ajayre/djetecu/005/Photos/ECU GIF/Aux Board Wiring.gif

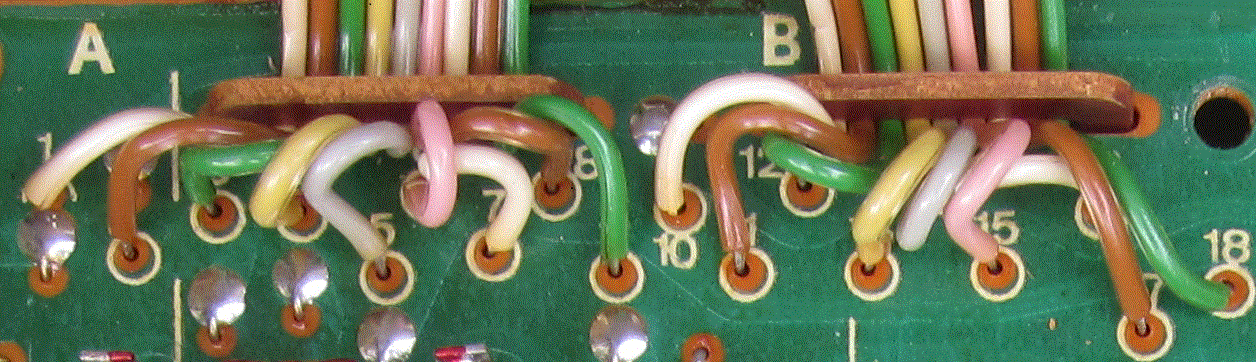
005/Photos/ECU GIF/Aux Board Wiring.gif
