ajayre/djetecu/005/Photos/ECU GIF/ECU Connector.gif

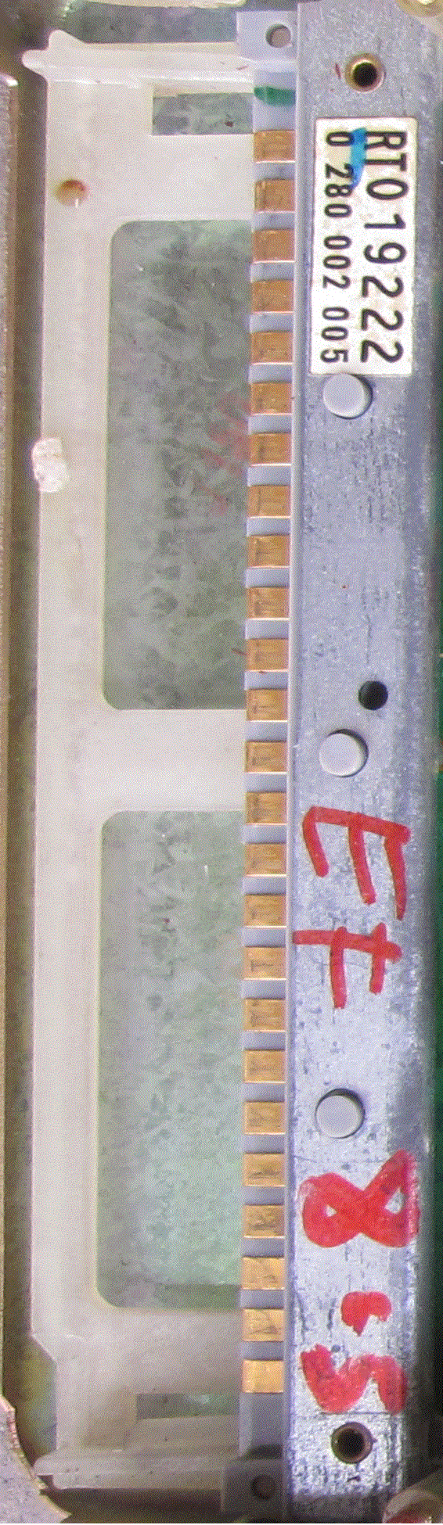
005/Photos/ECU GIF/ECU Connector.gif
