ajayre/djetecu/README.md

# Bosch D-Jetronic ECU Reverse Engineering Project

Schematics, simulation and photos. Work in progress. Supplied as-is.
