ajayre/djetecu/005/Schematics/Bosch 0 280 002 005 ECU Schematic.pdf-comment.html

# Bosch 0 280 002 005 ECU Schematic.pdf - Drive File Comments

{"anchor":"[null,[20,[0.3388324975967407,0.570936918258667,0.3535383939743042,0.5936641693115234]]]","author":{"displayName":"Pulse Width Multiplier","kind":"drive#user","picture":{"url":"//ssl.gstatic.com/docs/common/blue_silhouette96-0.png"}},"commentId":"AAAAKIMqTOY","content":"This area on the Aux Board is where the injector pulse is modified by bias inputs from the Speed Correction, Acceleration Enrichmentt, and Coolant Temperature Compensation circuits.\r\rNote the numerous (17) elevated resistors seen in the center. These are \"switched on test\" resistors where tuning can be performed by replacing resistors with different values. SOT resistors are depicted in bold throughout this schematic.\r","createdDate":"2020-08-13T01:20:13.000Z","deleted":false,"fileId":"AAHRpnXss1BSm1GQ5JTXtdxWG7rqqPFxCiCbxdgMYGcspkrfiV3KI8ri_D3V4RS67tfEnK4pajk2hcSiFbKjaerxNkvqE3YmhLg","fileTitle":"Bosch 0 280 002 005 ECU Schematic.pdf","htmlContent":"This area on the Aux Board is where the injector pulse is modified by bias inputs from the Speed Correction, Acceleration Enrichmentt, and Coolant Temperature Compensation circuits.<br><br>Note the numerous (17) elevated resistors seen in the center. These are &quot;switched on test&quot; resistors where tuning can be performed by replacing resistors with different values. SOT resistors are depicted in bold throughout this schematic.<br>","kind":"drive#comment","modifiedDate":"2020-08-13T01:20:35.000Z","replies":[],"status":"open"}

Author profile image

Pulse Width Multiplier

Aug 13, 2020, 1:20:13 AM(edited: Aug 13, 2020, 1:20:35 AM)

This area on the Aux Board is where the injector pulse is modified by bias inputs from the Speed Correction, Acceleration Enrichmentt, and Coolant Temperature Compensation circuits.

Note the numerous (17) elevated resistors seen in the center. These are "switched on test" resistors where tuning can be performed by replacing resistors with different values. SOT resistors are depicted in bold throughout this schematic.

{"anchor":"[null,[17,[0.27902859449386597,0.7633093595504761,0.29373449087142944,0.7860366106033325]]]","author":{"displayName":"Voltage Regulator","kind":"drive#user","picture":{"url":"//ssl.gstatic.com/docs/common/blue_silhouette96-0.png"}},"commentId":"AAAAKIMqTOM","content":"Many circuits in this ECU require a 10V power source provided by this step down regulator.\r","createdDate":"2020-08-13T01:18:38.000Z","deleted":false,"fileId":"AAHRpnXss1BSm1GQ5JTXtdxWG7rqqPFxCiCbxdgMYGcspkrfiV3KI8ri_D3V4RS67tfEnK4pajk2hcSiFbKjaerxNkvqE3YmhLg","fileTitle":"Bosch 0 280 002 005 ECU Schematic.pdf","htmlContent":"Many circuits in this ECU require a 10V power source provided by this step down regulator.<br>","kind":"drive#comment","modifiedDate":"2020-08-13T01:19:10.000Z","replies":[],"status":"open"}

Author profile image

Voltage Regulator

Aug 13, 2020, 1:18:38 AM(edited: Aug 13, 2020, 1:19:10 AM)

Many circuits in this ECU require a 10V power source provided by this step down regulator.

{"anchor":"[null,[16,[0.8002287149429321,0.18081945180892944,0.8149346113204956,0.2035467028617859]]]","author":{"displayName":"Acceleration Enrichment","kind":"drive#user","picture":{"url":"//ssl.gstatic.com/docs/common/blue_silhouette96-0.png"}},"commentId":"AAAAKIMqTOo","content":"This area of the Aux Board takes a signal from the TPS via ECU terminals 9 and 20 through Aux leads 3 and 5 as alternating HI - LO as the throttle is advanced. The Acceleration Enrichment circuit uses this step function to enrich the mixture based on driver demand from the right foot.\r\rAn idle signal from the TPS (terminal 17 via Aux 2) shuts down this circuit.\r","createdDate":"2020-08-13T01:17:27.000Z","deleted":false,"fileId":"AAHRpnXss1BSm1GQ5JTXtdxWG7rqqPFxCiCbxdgMYGcspkrfiV3KI8ri_D3V4RS67tfEnK4pajk2hcSiFbKjaerxNkvqE3YmhLg","fileTitle":"Bosch 0 280 002 005 ECU Schematic.pdf","htmlContent":"This area of the Aux Board takes a signal from the TPS via ECU terminals 9 and 20 through Aux leads 3 and 5 as alternating HI - LO as the throttle is advanced. The Acceleration Enrichment circuit uses this step function to enrich the mixture based on driver demand from the right foot.<br><br>An idle signal from the TPS (terminal 17 via Aux 2) shuts down this circuit.<br>","kind":"drive#comment","modifiedDate":"2020-08-13T01:17:54.000Z","replies":[],"status":"open"}

Author profile image

Acceleration Enrichment

Aug 13, 2020, 1:17:27 AM(edited: Aug 13, 2020, 1:17:54 AM)

This area of the Aux Board takes a signal from the TPS via ECU terminals 9 and 20 through Aux leads 3 and 5 as alternating HI - LO as the throttle is advanced. The Acceleration Enrichment circuit uses this step function to enrich the mixture based on driver demand from the right foot.

An idle signal from the TPS (terminal 17 via Aux 2) shuts down this circuit.

{"anchor":"[null,[6,[0.5404975414276123,0.7821174263954163,0.555203378200531,0.8048446774482727]]]","author":{"displayName":"Fuel Pump Control","kind":"drive#user","picture":{"url":"//ssl.gstatic.com/docs/common/blue_silhouette96-0.png"}},"commentId":"AAAAKIMqTOQ","content":"This circuit delivers a switched ground to ECU terminal 19 which is wired to terminal 85 of the Fuel Pump Relay under two conditions:\r\r1. ECU powered without a speed signal (100 series Aux Board) > C400 provides switched ground for 1.5 seconds to pressurize fuel loop for start.\r\r2. ECU powered with a speed signal (above 300 RPM), continuous ground delivered through T401 until engine RPM drops or ECU is powered off.\r","createdDate":"2020-08-13T01:14:26.000Z","deleted":false,"fileId":"AAHRpnXss1BSm1GQ5JTXtdxWG7rqqPFxCiCbxdgMYGcspkrfiV3KI8ri_D3V4RS67tfEnK4pajk2hcSiFbKjaerxNkvqE3YmhLg","fileTitle":"Bosch 0 280 002 005 ECU Schematic.pdf","htmlContent":"This circuit delivers a switched ground to ECU terminal 19 which is wired to terminal 85 of the Fuel Pump Relay under two conditions:<br><br>1. ECU powered without a speed signal (100 series Aux Board) &gt; C400 provides switched ground for 1.5 seconds to pressurize fuel loop for start.<br><br>2. ECU powered with a speed signal (above 300 RPM), continuous ground delivered through T401 until engine RPM drops or ECU is powered off.<br>","kind":"drive#comment","modifiedDate":"2020-08-13T01:15:11.000Z","replies":[],"status":"open"}

Author profile image

Fuel Pump Control

Aug 13, 2020, 1:14:26 AM(edited: Aug 13, 2020, 1:15:11 AM)

This circuit delivers a switched ground to ECU terminal 19 which is wired to terminal 85 of the Fuel Pump Relay under two conditions:

1. ECU powered without a speed signal (100 series Aux Board) > C400 provides switched ground for 1.5 seconds to pressurize fuel loop for start.

2. ECU powered with a speed signal (above 300 RPM), continuous ground delivered through T401 until engine RPM drops or ECU is powered off.

{"anchor":"[null,[4,[0.7425106167793274,0.17060983180999756,0.7572165131568909,0.193337082862854]]]","author":{"displayName":"Injector Drivers","kind":"drive#user","picture":{"url":"//ssl.gstatic.com/docs/common/blue_silhouette96-0.png"}},"commentId":"AAAAKIMqTOg","content":"The Injector Drivers are the heavy components along the right edge and upper edge of this picture. This is actually the lower and left sides of the ECU when it is mounted - easily identified by the 2 large heat sinks mounted on those sides. Injector pulses from the drivers are output to the ECU terminals shown:\r\r3 > I > 1 & 5\r4 > II > 4 & 8\r5 > III > 6 & 3\r6 > IV > 7 & 2\r\rNote the correlation to the M117 firing order\r\r1-5-4-8-6-3-7-2\r\rThis part of the ECU draws power from terminal 24. The rest of the ECU draws power from terminal 16.\r","createdDate":"2020-08-13T01:12:15.000Z","deleted":false,"fileId":"AAHRpnXss1BSm1GQ5JTXtdxWG7rqqPFxCiCbxdgMYGcspkrfiV3KI8ri_D3V4RS67tfEnK4pajk2hcSiFbKjaerxNkvqE3YmhLg","fileTitle":"Bosch 0 280 002 005 ECU Schematic.pdf","htmlContent":"The Injector Drivers are the heavy components along the right edge and upper edge of this picture. This is actually the lower and left sides of the ECU when it is mounted - easily identified by the 2 large heat sinks mounted on those sides. Injector pulses from the drivers are output to the ECU terminals shown:<br><br>3 &gt; I &gt; 1 &amp; 5<br>4 &gt; II &gt; 4 &amp; 8<br>5 &gt; III &gt; 6 &amp; 3<br>6 &gt; IV &gt; 7 &amp; 2<br><br>Note the correlation to the M117 firing order<br><br>1-5-4-8-6-3-7-2<br><br>This part of the ECU draws power from terminal 24. The rest of the ECU draws power from terminal 16.<br>","kind":"drive#comment","modifiedDate":"2020-08-13T01:13:28.000Z","replies":[],"status":"open"}

Author profile image

Injector Drivers

Aug 13, 2020, 1:12:15 AM(edited: Aug 13, 2020, 1:13:28 AM)

The Injector Drivers are the heavy components along the right edge and upper edge of this picture. This is actually the lower and left sides of the ECU when it is mounted - easily identified by the 2 large heat sinks mounted on those sides. Injector pulses from the drivers are output to the ECU terminals shown:

3 > I > 1 & 5
4 > II > 4 & 8
5 > III > 6 & 3
6 > IV > 7 & 2

Note the correlation to the M117 firing order

1-5-4-8-6-3-7-2

This part of the ECU draws power from terminal 24. The rest of the ECU draws power from terminal 16.

{"anchor":"[null,[4,[0.5571870803833008,0.14481693506240845,0.5718929767608643,0.1675441861152649]]]","author":{"displayName":"NOR Gates","kind":"drive#user","picture":{"url":"//ssl.gstatic.com/docs/common/blue_silhouette96-0.png"}},"commentId":"AAAAKIMqTOI","content":"Labeled by groups, these serve a summation process on the various waveforms created by the pulse wave multiplier (300 series on Aux Board). The \"OR'd\" together waveform is delivered to the Injector Drivers.\r","createdDate":"2020-08-13T01:11:04.000Z","deleted":false,"fileId":"AAHRpnXss1BSm1GQ5JTXtdxWG7rqqPFxCiCbxdgMYGcspkrfiV3KI8ri_D3V4RS67tfEnK4pajk2hcSiFbKjaerxNkvqE3YmhLg","fileTitle":"Bosch 0 280 002 005 ECU Schematic.pdf","htmlContent":"Labeled by groups, these serve a summation process on the various waveforms created by the pulse wave multiplier (300 series on Aux Board). The &quot;OR&#39;d&quot; together waveform is delivered to the Injector Drivers.<br>","kind":"drive#comment","modifiedDate":"2020-08-13T01:11:29.000Z","replies":[],"status":"open"}

Author profile image

NOR Gates

Aug 13, 2020, 1:11:04 AM(edited: Aug 13, 2020, 1:11:29 AM)

Labeled by groups, these serve a summation process on the various waveforms created by the pulse wave multiplier (300 series on Aux Board). The "OR'd" together waveform is delivered to the Injector Drivers.

{"anchor":"[null,[3,[0.6409828066825867,0.4349873661994934,0.6556887030601501,0.45771467685699463]]]","author":{"displayName":"Injector Group Toggle Input from PG","kind":"drive#user","picture":{"url":"//ssl.gstatic.com/docs/common/blue_silhouette96-0.png"}},"commentId":"AAAAKIMqTOc","content":"The 800 series components span upwards and left from this highlighted area. This part takes the 5V square wave signals, phased at 90 degrees, from the pulse generator to the rest of the Injector Group Toggle circuit depicted on page 13.\r","createdDate":"2020-08-13T01:07:25.000Z","deleted":false,"fileId":"AAHRpnXss1BSm1GQ5JTXtdxWG7rqqPFxCiCbxdgMYGcspkrfiV3KI8ri_D3V4RS67tfEnK4pajk2hcSiFbKjaerxNkvqE3YmhLg","fileTitle":"Bosch 0 280 002 005 ECU Schematic.pdf","htmlContent":"The 800 series components span upwards and left from this highlighted area. This part takes the 5V square wave signals, phased at 90 degrees, from the pulse generator to the rest of the Injector Group Toggle circuit depicted on page 13.<br>","kind":"drive#comment","modifiedDate":"2020-08-13T01:09:57.000Z","replies":[],"status":"open"}

Author profile image

Injector Group Toggle Input from PG

Aug 13, 2020, 1:07:25 AM(edited: Aug 13, 2020, 1:09:57 AM)

The 800 series components span upwards and left from this highlighted area. This part takes the 5V square wave signals, phased at 90 degrees, from the pulse generator to the rest of the Injector Group Toggle circuit depicted on page 13.

{"anchor":"[null,[2,[0.33187827467918396,0.5666389465332031,0.34658414125442505,0.5893661975860596]]]","author":{"displayName":"Groups I & III","kind":"drive#user","picture":{"url":"//ssl.gstatic.com/docs/common/blue_silhouette96-0.png"}},"commentId":"AAAAKIMqTOk","content":"Group I & III components are in the lower left half of this polygon\r\r21 > I > 1 & 5\r22 > III > 6 & 3\r","createdDate":"2020-08-13T01:03:48.000Z","deleted":false,"fileId":"AAHRpnXss1BSm1GQ5JTXtdxWG7rqqPFxCiCbxdgMYGcspkrfiV3KI8ri_D3V4RS67tfEnK4pajk2hcSiFbKjaerxNkvqE3YmhLg","fileTitle":"Bosch 0 280 002 005 ECU Schematic.pdf","htmlContent":"Group I &amp; III components are in the lower left half of this polygon<br><br>21 &gt; I &gt; 1 &amp; 5<br>22 &gt; III &gt; 6 &amp; 3<br>","kind":"drive#comment","modifiedDate":"2020-08-13T01:05:09.000Z","replies":[],"status":"open"}

Author profile image

Groups I & III

Aug 13, 2020, 1:03:48 AM(edited: Aug 13, 2020, 1:05:09 AM)

Group I & III components are in the lower left half of this polygon

21 > I > 1 & 5
22 > III > 6 & 3

{"anchor":"[null,[2,[0.4779117703437805,0.4607802629470825,0.4926176369190216,0.48350757360458374]]]","author":{"displayName":"Groups II & IV","kind":"drive#user","picture":{"url":"//ssl.gstatic.com/docs/common/blue_silhouette96-0.png"}},"commentId":"AAAAKIMqTOU","content":"Group II & IV components are in the upper right half of this polygon.\r\r13 > II > 4 & 8\r14 > IV > 7 & 2\r","createdDate":"2020-08-13T01:02:45.000Z","deleted":false,"fileId":"AAHRpnXss1BSm1GQ5JTXtdxWG7rqqPFxCiCbxdgMYGcspkrfiV3KI8ri_D3V4RS67tfEnK4pajk2hcSiFbKjaerxNkvqE3YmhLg","fileTitle":"Bosch 0 280 002 005 ECU Schematic.pdf","htmlContent":"Group II &amp; IV components are in the upper right half of this polygon.<br><br>13 &gt; II &gt; 4 &amp; 8<br>14 &gt; IV &gt; 7 &amp; 2<br>","kind":"drive#comment","modifiedDate":"2020-08-13T01:06:20.000Z","replies":[],"status":"open"}

Author profile image

Groups II & IV

Aug 13, 2020, 1:02:45 AM(edited: Aug 13, 2020, 1:06:20 AM)

Group II & IV components are in the upper right half of this polygon.

13 > II > 4 & 8
14 > IV > 7 & 2
