ajayre/djetecu/005/Photos/100 Full Load Mixture Control.jpg

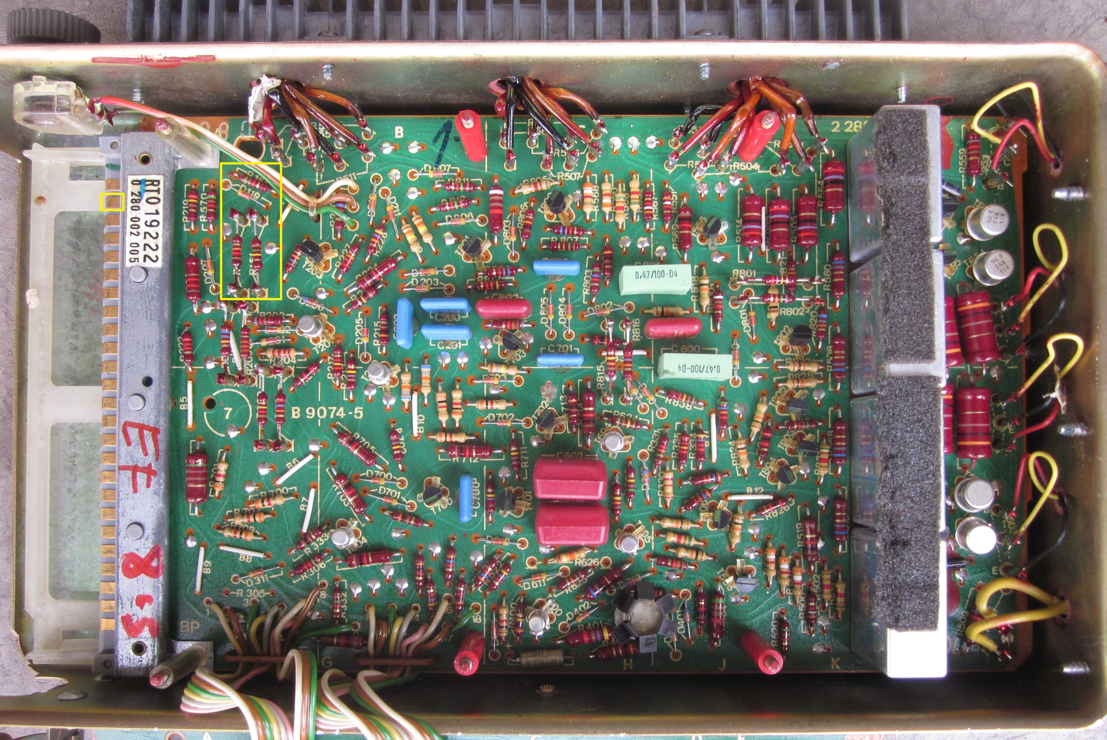
005/Photos/100 Full Load Mixture Control.jpg
