ajayre/djetecu/005/Photos/A-100 Voltage Regulator.jpg

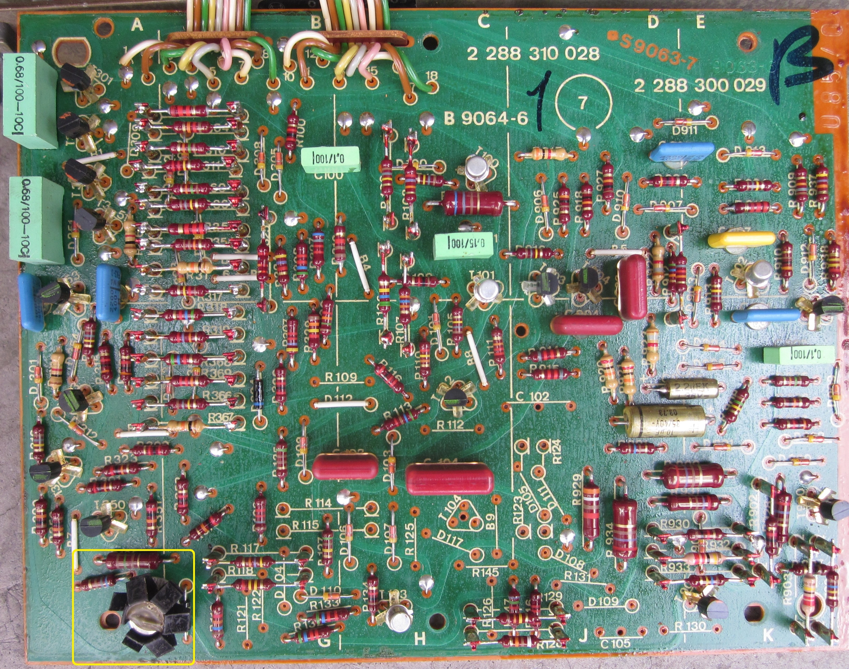
005/Photos/A-100 Voltage Regulator.jpg
