ajayre/djetecu/005/Photos/A-900 Accelerartion Enrichment.jpg

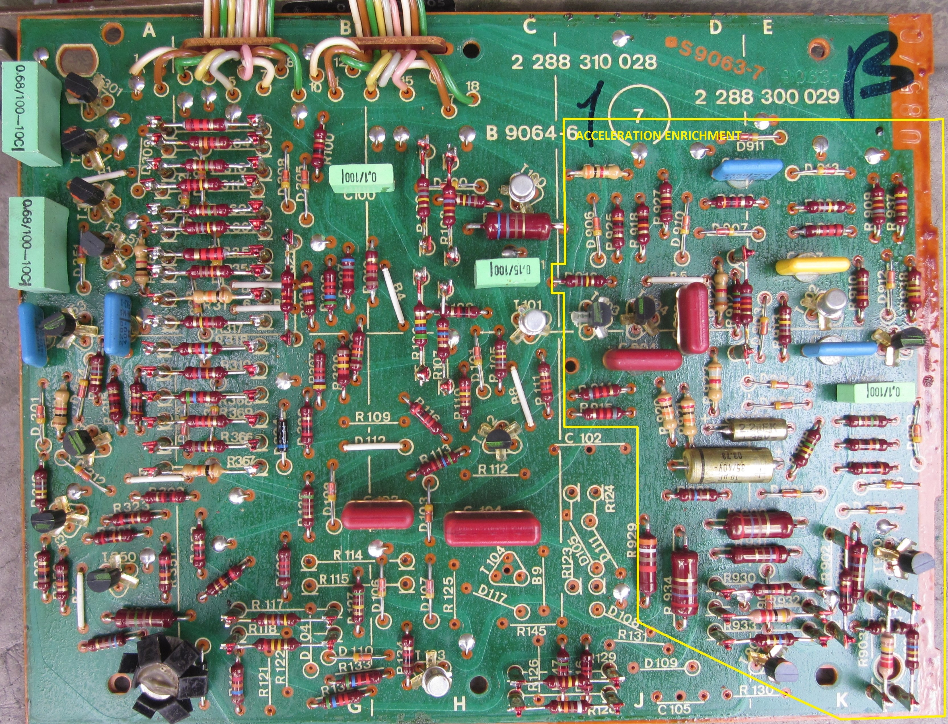
005/Photos/A-900 Accelerartion Enrichment.jpg
