ajayre/djetecu/005/Photos/ECU GIF/Inection to Ignition Correlation.gif

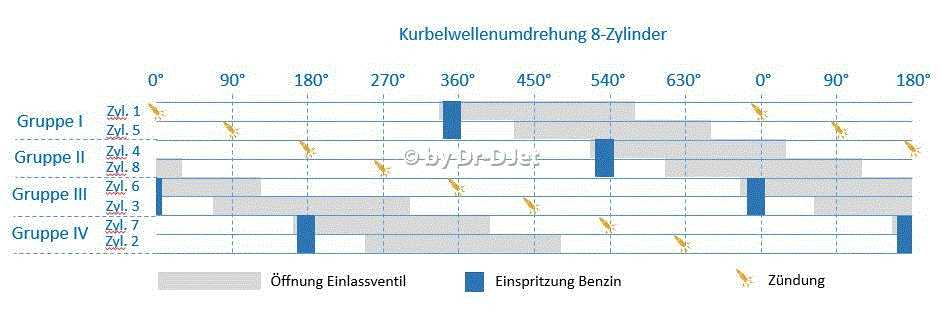
005/Photos/ECU GIF/Inection to Ignition Correlation.gif
