ajayre/djetecu/005/Schematics/Bosch ECU 0 280 002 005 Components.xlsx

Reference | Value | PCB | Footprint | Datasheet | Notes | Qty
C200 | 6n8 | M | Lower Right B | ~ |  | 1
C201 | 6n8 | M | Lower Right B | ~ |  | 1
C202 | 1n0 | M | Lower Center B | ~ |  | 1
C400 | 6u8 | M | Lower Left H | 5910-00-600-2672 MIL-ETS_B 6.8/35 20% 39003 P (https://www.parttarget.com/5910-00-600-2672_5910006002672_MILC39003-1.html/-F8D27916-3146-4198-B705-0653E1CA1DFE) | EPO Tantal | 1
C500 | 6u8 | M | Right D Line | ~ | Bosch MK 6,8μF ±5% 100V | 1
C501 | 6u8 | M | Right D Line | ~ | Bosch MK 6,8μF ±5% 100V | 1
C550 | 6u8 | M | Right K Line | ~ | Bosch MK 6,8μF ±5% 100V | 1
C551 | 6u8 | M | Right K Line | ~ | Bosch MK 6,8μF ±5% 100V | 1
C602 | 2u2 | M | Center H | ~ |  | 1
C603 | 2u2 | M | Center H | ~ |  | 1
C700 | 2n2 | M | Center Right G | ~ |  | 1
C701 | 2n2 | M | Lower Center C | ~ |  | 1
C800 | 470n | M | Left D-J Line | ~ |  | 1
C801 | 33n | M | Lower C-D Line | ~ |  | 1
C802 | 33n | M | Lower B-C Line | ~ |  | 1
C803 | 470n | M | Lower C-D Line | ~ |  | 1
C805 | 2n2 | M | Center Left C | ~ |  | 1
C100 | 100n | A | Upper B-C Line | ~ |  | 1
C101 | 15n | A | Lower Right C | ~ |  | 1
C103 | 15n | A | Center G-H Line | ~ |  | 1
C121 | 470n | A | Center H | ~ |  | 1
C300 | 680n | A | Upper Left A | ~ |  | 1
C301 | 1n0 | A | Left A-F Line | ~ |  | 1
C350 | 680n | A | Lower Left A | ~ |  | 1
C351 | 2n2 | A | Center A-F Line | ~ |  | 1
C900 | 10uF | A | Center D-E Line | ~ |  | 1
C901 | 2n2 | A | Upper Center K | ~ |  | 1
C902 | 100n | A | Upper Right K | ~ |  | 1
C903 | 47n | A | Right D-J Line | ~ |  | 1
C904 | 47n | A | Upper Left J | ~ |  | 1
C905 | 3n3 | A | Center D-E Line | ~ |  | 1
C906 | 2u2 | A | Upper D-E Line | ~ |  | 1
C907 | 100p | A | Lower Left E | ~ |  | 1 | 33
Reference | Value | PCB | Footprint | Datasheet | Notes | Qty
D119 | D | M | Upper Center A | ~ |  | 1
D201 | D | M | Lower Right A | ~ |  | 1
D202 | D | M | Lower Right A | ~ |  | 1
D203 | D | M | Lower Center B | ~ |  | 1
D204 | D | M | Lower Center B | ~ |  | 1
D205 | D | M | Lower Left B | ~ |  | 1
D206 | D | M | Lower A-B Line | ~ |  | 1
D207 | D | M | Center Left A | ~ |  | 1
D210 | D | M | Upper Left B | ~ |  | 1
D211 | D | M | Upper Left B | ~ |  | 1
D307 | D | M | Upper Right H | ~ |  | 1
D310 | D | M | Upper H-J Line | ~ |  | 1
D311 | D | M | Lower Center F | ~ |  | 1
D400 | D | M | Lower Left H | ~ |  | 1
D401 | 7V4 | M | Lower Left J | ~ |  | 1
D402 | D | M | Lower Center H | ~ |  | 1
D403 | D | M | Lower Left J | ~ |  | 1
D500 | D | M | Lower Center K | ~ | D600 on Peter's labeled picture | 1
D501 | D | M | Lower Right E wired out to heat sink | ~ |  | 1
D550 | D | M | Upper Center E | ~ | D500 on Peter's labeled picture | 1
D610 | 7V4 | M | Upper Right H | ~ |  | 1
D611 | D | M | Lower Left H | ~ |  | 1
D612 | D | M | Lower G-H Line | ~ |  | 1
D613 | 7V4 | M | Lower Right H | ~ |  | 1
D700 | D | M | Center G | ~ |  | 1
D701 | D | M | Center G | ~ |  | 1
D702 | D | M | Upper G-H Line | ~ |  | 1
D703 | D | M | Upper G-H Line | ~ |  | 1
D800 | D | M | Center D-J Line | ~ |  | 1
D801 | D | M | Lower Center D | ~ |  | 1
D802 | D | M | Lower Right C | ~ |  | 1
D803 | D | M | Center Left C | ~ |  | 1
D804 | D | M | Lower Center C | ~ |  | 1
D805 | D | M | Lower Left C | ~ |  | 1
D806 | D | M | Center Right B | ~ |  | 1
D807 | D | M | Upper Right B | ~ |  | 1
D100 | D | A | Center C | ~ |  | 1
D101 | D | A | Upper Center H | ~ |  | 1
D102 | D | A | Center Right G | ~ |  | 1
D103 | D | A | Center Left H | ~ |  | 1
D106 | D | A | Lower Left H | ~ |  | 1
D107 | D | A | Lower Left H | ~ |  | 1
D110 | D | A | Lower G-H Line | ~ |  | 1
D120 | 10V | A | Lower Left G | ~ |  | 1
D301 | D | A | Upper Left F | ~ |  | 1
D302 | D | A | Center Left B | ~ |  | 1
D303 | D | A | Lower Left B | ~ |  | 1
D304 | 6V2 | A | Upper Center G | ~ |  | 1
D305 | D | A | Center Right B | ~ |  | 1
D306 | D | A | Lower Left B | ~ |  | 1
D308 | D | A | Center B | ~ |  | 1
D312 | D | A | Center F | ~ |  | 1
D351 | D | A | Lower Left A | ~ |  | 1
D352 | D | A | Center Left B | ~ |  | 1
D353 | D | A | Upper Left G | ~ |  | 1
D354 | D | A | Upper Center F | ~ |  | 1
D356 | D | A | Upper Left G | ~ |  | 1
D900 | D | A | Center Right K | ~ |  | 1
D901 | D | A | Center Left K | ~ |  | 1
D902 | D | A | Center Right K | ~ |  | 1
D903 | D | A | Left E-K Line | ~ |  | 1
D904 | D | A | Upper Left K | ~ |  | 1
D905 | D | A | Upper Left K | ~ |  | 1
D906 | D | A | Lower Left D | ~ |  | 1
D907 | D | A | Lower D-E Line | ~ |  | 1
D908 | D | A | Lower Left K | ~ |  | 1
D909 | D | A | Upper Right K | ~ |  | 1
D910 | D | A | Lower Right D | ~ |  | 1
D911 | D | A | Upper D-E Line | ~ |  | 1
D912 | D | A | Lower Right E | ~ |  | 1
D913 | D | A | Center E | ~ |  | 1 | 71
Reference | Value | PCB | Footprint | Datasheet | Notes | Qty
R151 | 150K | M | Center A | ~ | Bn Gn Y Gd = 150KΩ ±5% SOT pair = 11111Ω | 1
R152 | 12K | M | Center A | ~ | Bn R O Gd = 12KΩ ±5% | 1
R155 | 5k1 | M | Upper Center A | ~ | Gn Br R Gd = 5.1KΩ ±5% | 1
R200 | 120K | M | Upper Center F | ~ | Bn R Y Gd = 120KΩ ±5% SOT pair = 22041Ω | 1
R201 | 27K | M | Upper Right F | ~ | R V O Gd = 27KΩ ±5% | 1
R202 | 820 | M | Lower Center A | ~ | Gr R Bn R = 820Ω ±2% | 1
R204 | 2k2 | M | Lower Center A | ~ | R R R R = 2.2KΩ ±2% | 1
R205 | 680K | M | Left A-F Line | ~ | Bl Gr Y Gd = 680KΩ ±5% SOT pair 31473Ω | 1
R206 | 33K | M | Center A-F Line | ~ | O O O Gd = 33KΩ ±5% | 1
R209 | 130K | M | Center B | ~ | Br O Y Gd = 130KΩ ±5% | 1
R210 | 68K | M | Center B-G Line | ~ | Bl Gr O Gd = 68KΩ ±5% | 1
R211 | 68K | M | Center B-G Line | ~ | Bl Gr O Gd = 68KΩ ±5% | 1
R212 | 130K | M | Center B | ~ | Br O Y Gd = 130KΩ ±5% | 1
R213 | 180K | M | Left B-G Line | ~ | Br Gr Y Gd = 180KΩ ±5% | 1
R214 | 100K | M | Center Left B | ~ | Br Bk Y Gd = 100KΩ ±5% | 1
R215 | 300 | M | Lower Left B | ~ | O Bk Br Gd = 300Ω ±5% | 1
R216 | 2K | M | Right A-F Line | ~ | R Bk R Gd = 2KΩ ±5% | 1
R217 | 2k4 | M | Left B-G Line | ~ | R Y R Gd = 2.4KΩ ±5% | 1
R218 | 510 | M | Center Left F | ~ | Gr Br Br Gd = 510Ω ±5% | 1
R219 | 240 | M | Upper Left A | ~ | R Y Br Gd = 240Ω ±5% | 1
R220 | 1k2 | M | Center Left A | ~ | Br R R Gd = 1.2KΩ ±5% | 1
R222 | 2k2 | M | Lower Leftt A | ~ | R R R Gd = 2.2KΩ ±5% | 1
R224 | 1K | M | Center Left B | ~ | Br Bk R Gd = 1KΩ ±5% | 1
R227 | 22K | M | Center Left B | ~ | R R O Gd = 22KΩ ±5% | 1
R228 | 47K | M | Center Left B | ~ | Y V O Gd = 47KΩ ±5% | 1
R229 | 18K | M | Center Right A | ~ | R529 on Peter's labeled picture - Br Gr O Gd = 18KΩ ±5% | 1
R230 | 6k2 | M | Upper Left B (under rheostat wires) | ~ | Bl R R Gd = 6.2KΩ ±5% (need to verify with clip undone) | 1
R306 | 1k5 | M | Center F-G Line | ~ | Br Gn R R = 1.5KΩ ±2% | 1
R330 | 2k4 | M | Center Left J | ~ | R Y R R = 2.4KΩ ±2% | 1
R331 | 15K | M | Upper H-J Line | ~ | Br Gn O R = 15KΩ ±2% | 1
R332 | 1k5 | M | Lower Left G | ~ | Br Gn R Gd = 1.5KΩ ±5% | 1
R333 | 100 | M | Lower F-G Line | ~ | Br Bk Br Gd = 100Ω ±5% | 1
R334 | 4k8 | M | Upper Left J | ~ | Y Gr R R = 4.8KΩ ±2% | 1
R335 | 22K | M | Upper Left J | ~ | R R O R = 22KΩ ±2% | 1
R400 | 300K | M | Lower Left H | ~ | O Bk Y Gd = 300KΩ ±5% | 1
R401 | 470 | M | Lower Right H | ~ | Y V Br R = 470Ω ±2% | 1
R402 | 1K | M | Lower Left J | ~ | R408 on Peter's labeled picture - Br Bk R Gd = 1KΩ ±5% | 1
R403 | 1k2 | M | Lower H-J Line | ~ | Br R R Gd = 1.2KΩ ±5% | 1
R404 | 510 | M | Lower Center J | ~ | Gn Br Br R = 510Ω ±2% | 1
R405 | 3 | M | Lower Right H | ~ | O Bk Gd Gd = 3Ω ±5% | 1
R407 | 68 | M | Lower Right H | ~ | Bl Gr Bk Gd = 68Ω ±5% | 1
R408 | 1K | M | Lower Left H | ~ | R403(2) on Peter's labeled picture - Br Bk R Gd = 1KΩ ±5% | 1
R500 | 3k9 | M | Lower Right J | ~ | O W R Gd = 3.9KΩ ±5% | 1
R501 | 3k9 | M | Lower Right J | ~ | O W R Gd = 3.9KΩ ±5% | 1
R502 | 5k1 | M | Lower Left K | ~ | Gn Br R Gd = 5.1KΩ ±5% | 1
R503 | 300 | M | Upper Center K | ~ | O Bk Br Gd = 300Ω ±5% | 1
R504 | 27 |  | Upper Center D wired out to Heat Sink | ~ | 014 measured ceramic | 1
R505 | 27 | M | Upper Right D | ~ | R W Bk Gd = 27Ω ±5% | 1
R506 | 6 |  | Upper Left C wired out to Heat Sink | ~ | 014 measured ceramic | 1
R507 | 6 |  | Upper Left C wired out to Heat Sink | ~ | 014 measured ceramic | 1
R508 | 6.8 | M | Left E-K Line | ~ | Bl Gr Gd Gd = 6.8Ω ±5% | 1
R509 | 820 | M | Lower Right K | ~ | Gr R Br Gd = 820Ω ±5% | 1
R510 | 6.8 | M | Center Left K | ~ | Bl Gr Gd Gd = 6.8Ω ±5% | 1
R511 | 6 |  | Upper A-B Line wired out to Heat Sink | ~ | 014 measured ceramic | 1
R512 | 6 |  | Upper A-B Line wired out to Heat Sink | ~ | 014 measured ceramic | 1
R513 | 27 |  | Upper Left D wired out to Heat Sink | ~ | 014 measured ceramic | 1
R514 | 27 | M | Upper Center D | ~ | R W Bk Gd = 27Ω ±5% | 1
R515 | 300 | M | Upper Center K | ~ | O Bk Br Gd = 300Ω ±5% | 1
R516 | 5k1 | M | Lower Left K | ~ | Gn Br R Gd = 5.1KΩ ±5% | 1
R517 | 3k9 | M | Lower Right J | ~ | O W R Gd = 3.9KΩ ±5% | 1
R518 | 3k9 | M | Lower Right J | ~ | O W R Gd = 3.9KΩ ±5% | 1
R519 | 1K | M | Center Right J | ~ | Br Bk R Gd = 1KΩ ±5% | 1
R520 | 5k1 | M | Lower Right J | ~ | Gn Br R Gd = 5.1KΩ ±5% | 1
R521 | 3k9 | M | Lower Right G | ~ | O Bk R Gd = 3KΩ ±5% | 1
R522 | 4k7 | M | Lower Left H | ~ | Y V R Gd = 4.7KΩ ±5% | 1
R523 | 3k6 | M | Lower G-H Line | ~ | O Bl R Gd = 3.6KΩ ±5% | 1
R550 | 3k9 | M | Upper Center C | ~ | O W R Gd = 3.9KΩ ±5% | 1
R551 | 3k9 | M | Upper Left D | ~ | O W R Gd = 3.9KΩ ±5% | 1
R552 | 5k1 | M | Upper Right C | ~ | Gn Br R Gd = 5.1KΩ ±5% | 1
R553 | 300 | M | Lower Right E | ~ | O Bk Br Gd = 300Ω ±5% | 1
R554 | 27 |  | Upper Left D wired out to Heat Sink | ~ | 014 measured ceramic | 1
R555 | 27 | M | Upper Right D | ~ | R W Bk Gd = 27Ω ±5% | 1
R556 | 6 |  | Upper A-B Line wired out to Heat Sink | ~ | 014 measured ceramic | 1
R557 | 6 |  | Upper A-B Line wired out to Heat Sink | ~ | 014 measured ceramic | 1
R558 | 6.8 | M | Upper Left K | ~ | Bl Gr Gd Gd = 6.8Ω ±5% | 1
R559 | 820 | M | Upper Right E | ~ | Gr R Br Gd = 820Ω ±5% | 1
R560 | 6.8 | M | Center Left E | ~ | Bl Gr Gd Gd = 6.8Ω ±5% | 1
R561 | 6 |  | Upper Left C wired out to Heat Sink | ~ | R501 on Peter's schematic - 014 measured ceramic | 1
R562 | 6 |  | Upper Left C wired out to Heat Sink | ~ | R502 on Peter's schematic - 014 measured ceramic | 1
R563 | 27 |  | Upper Right D-E Line wired out to Heat Sink | ~ | 014 measured ceramic | 1
R564 | 27 | M | Upper Left E | ~ | R W Bk Gd = 27Ω ±5% | 1
R565 | 300 | M | Lower Center E | ~ | O Bk Br Gd = 300Ω ±5% | 1
R566 | 5k1 | M | Upper Right C | ~ | Gn Br R Gd = 5.1KΩ ±5% | 1
R567 | 3k9 | M | Upper Right C | ~ | O W R Gd = 3.9KΩ ±5% | 1
R568 | 3k9 | M | Upper Center C | ~ | O W R Gd = 3.9KΩ ±5% | 1
R569 | 1K | M | Upper Left D | ~ | Br Bk R Gd = 1KΩ ±5% | 1
R570 | 5k1 | M | Upper Left A | ~ | Gn Br R Gd = 5.1KΩ ±5% | 1
R571 | 3K | M | Lower Center G | ~ | O Bk R Gd = 3KΩ ±5% | 1
R572 | 4k7 | M | Lower Right G | ~ | Y V R Gd = 4.7KΩ ±5% | 1
R573 | 3k6 | M | Lower Right G | ~ | O Bl R Gd = 3.6KΩ ±5% | 1
R620 | 10K | M | Center Left J | ~ | Br Bk O Gd = 10KΩ ±5% | 1
R621 | 5k1 | M | Center Left J | ~ | Gn Br R Gd = 5.1KΩ ±5% | 1
R622 | 500K | M | Center Right H | ~ | R602 on Peter's labeled picture - Gn Br Y Gd = 510KΩ ±5% | 1
R623 | 130K | M | Center Right H | ~ | R603 on Peter's labeled picture - Br O Y Gd = 130KΩ ±5% | 1
R624 | 510K | M | Upper Right H | ~ | Gn Br Y Gd = 510KΩ ±5% | 1
R625 | 15K | M | Lower Center H | ~ | Br Gn O Gd = 15KΩ ±5% | 1
R627 | 24K | M | Lower Center H | ~ | R Y O Gd = 24KΩ ±5% | 1
R628 | 10K | M | Center Left J | ~ | Br Bk O Gd = 10KΩ ±5% | 1
R629 | 1k3 | M | Lower Left J | ~ | R626 on Peter's labeled pictuere - Br O R Gd = 1.3KΩ ±5% | 1
R700 | 3K | M | Center Right F | ~ | O Bk R Gd = 3KΩ ±5% | 1
R701 | 3K | M | Upper Left F | ~ | O Bk R Gd = 3KΩ ±5% | 1
R702 | 180K | M | Upper Center G | ~ | Br Gr Y Gd = 180KΩ ±5% | 1
R703 | 1K | M | Center Left G | ~ | Br Bk R Gd = 1KΩ ±5% | 1
R704 | 300 | M | Center G | ~ | O Bk Br Gd = 300Ω ±5% | 1
R705 | 1K | M | Upper Left G | ~ | Br Bk R Gd = 1KΩ ±5% | 1
R706 | 180K | M | Center Left H | ~ | Br Gr Y Gd = 180KΩ ±5% | 1
R707 | 3K | M | Center F | ~ | O Bk R Gd = 3KΩ ±5% | 1
R708 | 3K | M | Center F | ~ | O Bk R Gd = 3KΩ ±5% | 1
R709 | 3K | M | Upper Right G | ~ | O Bk R Gd = 3KΩ ±5% | 1
R710 | 3K | M | Upper G-H Line | ~ | O Bk R Gd = 3KΩ ±5% | 1
R711 | 180K | M | Upper Left H | ~ | Br Gr Y Gd = 180KΩ ±5% | 1
R712 | 1k | M | Upper G-H Line | ~ | Br Bk R Gd = 1KΩ ±5% | 1
R713 | 300 | M | Upper Center H | ~ | O Bk Br Gd = 300Ω ±5% | 1
R714 | 1K | M | Upper Center H | ~ | Br Bk R Gd = 1KΩ ±5% | 1
R715 | 180k | M | Left H-C Line | ~ | R713 (2) on Peter's schematic - Br Gr Y Gd = 180KΩ ±5% | 1
R717 | 3K | M | Upper Right G | ~ | O Bk R Gd = 3KΩ ±5% | 1
R718 | 3K | M | Upper Right G | ~ | O Bk R Gd = 3KΩ ±5% | 1
R800 | 9k1 | M | Lower Left D | ~ | W Br R Gd = 9.1KΩ ±5% | 1
R801 | 270K | M | Lower Right D | ~ | R V Y Gd = 270KΩ ±5% SOT pair 58696Ω | 1
R802 | 75K | M | Lower Right D | ~ | V Gn O Gd = 75KΩ ±5% | 1
R803 | 5k6 | M | Lower Right C | ~ | Gn Bl R Gd = 5.6KΩ ±5% | 1
R804 | 6k8 | M | Center Left C | ~ | Bl Gr R Gd = 6.8KΩ ±5% | 1
R805 | 5k1 | M | Upper Left C | ~ | Gn Br R Gd = 5.1KΩ ±5% | 1
R806 | 10K | M | Upper Left C | ~ | Br Bk O Gd = 10KΩ ±5% | 1
R807 | 15K | M | Center Left C | ~ | Br Gn O Gd = 15KΩ ±5% | 1
R808 | 900 | M | Upper Left C | ~ | W Br Br Rd = 910Ω ±2% | 1
R809 | 6k8 | M | Lower B-C Line | ~ | Bl Gr R Gd = 6.8KΩ ±5% | 1
R810 | 1k5 | M | Upper Right B | ~ | Br Gn R Gd = 1.5KΩ ±5% | 1
R811 | 1k5 | M | Upper Right B | ~ | Br Gn R Gd = 1.5KΩ ±5% | 1
R812 | 4k3 | M | Lower B-C Line | ~ | Y O R Gd = 4.3KΩ ±5% | 1
R813 | 1k3 | M | Lower Left C | ~ | Br O R Gd = 1.3KΩ ±5% | 1
R814 | 20K | M | Lower Right C | ~ | R Bk O Rd = 20KΩ ±2% | 1
R815 | 130K | M | Right C-H Line | ~ | Br O Y Gd = 130KΩ ±5% SOT pair 22357Ω | 1
R816 | 27K | M | Right C-H Line | ~ | R V O Gd = 27KΩ ±5% | 1
R817 | 10K | M | Lower C-D Line | ~ | Br Bk O Gd = 10KΩ ±5% | 1
R818 | 10K | M | Lower Left D | ~ | Br Bk O Gd = 10KΩ ±5% | 1
R819 | 10K | M | Lower Right D | ~ | Br Bk O Gd = 10KΩ ±5% | 1
R820 | 68K | M | Lower Left E | ~ | Bl Gr O Gd = 68KΩ ±5% | 1
R821 | 22K | M | Lower Right D | ~ | R R O Gd = 22KΩ ±5% | 1
R822 | 56k | M | Upper Center J | ~ | Gr Bl O R = 56KΩ ±2% | 1
R823 | 10K | M | Center J | ~ | R822 (2) on Peter's labeled picture - Br Bk O Gd = 10KΩ ±5% | 1
R824 | 10k | M | Upper Center J | ~ | Br Bk O Gd = 10KΩ ±5% | 1
R825 | 1K | M | Lower Left G | ~ | Br Bk R Gd = 1KΩ ±5% | 1
R826 | 2K | M | Center Right J | ~ | R Bk R Gd = 2KΩ ±5% | 1
R827 | 1K | M | Lower F-G Line | ~ | Br Bk R Gd = 1KΩ ±5% | 1
R828 | 10K | M | Upper Right J | ~ | Br Bk O Gd = 10KΩ ±5% | 1
R829 | 10K | M | Upper Right J | ~ | Br Bk O Gd = 10KΩ ±5% | 1
R830 | 2K | M | Upper Right J | ~ | R Bk R Gd = 2KΩ ±5% | 1
R831 | 5k1 | M | Center J-K Line | ~ | Gn Br R Gd = 5.1KΩ ±5% | 1
R832 | 5k1 | M | Upper J-K Line | ~ | Gn Br R Gd = 5.1KΩ ±5% | 1
R833 | 10K | M | Right D-J Line | ~ | Br Bk O Gd = 10KΩ ±5% | 1
R835 | 300 | M | Center Right C | ~ | R839 on Peter's schematic - O Bk Br Gd = 300Ω ±5% | 1
R836 | 36K | M | Center Left J | ~ | R835 on Peter's labeled picture - O Bl O Rd = 36KΩ ±2% | 1
R837 | 36K | M | Center Left J | ~ | O Bl O Rd = 36KΩ ±2% | 1
R838 | 510K | M | Upper Left J |  | Gr Br Y Rd = 510KΩ ±2% | 1 | 155
R100 | 2K | A | Upper Right A | ~ | R Bk R Gd = 2KΩ ±5% | 1
R101 | 180K | A | Upper Center C | ~ | Br Gr Y Gd = 180KΩ ±5% | 1
R102 | 180K | A | Center Left C | ~ | Br Gr Y Gd = 180KΩ ±5% SOT pair 23478Ω | 1
R103 | 27K | A | Center C | ~ | R V O Gd = 27KΩ ±5% | 1
R104 | 680 | A | Lower Right C | ~ | Bl Gr Br Gd = 680Ω ±5% | 1
R105 | 180K | A | Upper Right H | ~ | Br Gr Y Gd = 180KΩ ±5% | 1
R106 | 560K | A | Left C-H Line | ~ | Gr Bl Y Gd = 560KΩ ±5% SOT pair 33826Ω | 1
R107 | 36K | A | Left C-H Line | ~ | O Bl O Gd = 36KΩ ±5% | 1
R108 | 1K | A | Lower Center C | ~ | Br Bk R Gd = 1KΩ ±5% | 1
R110 | 24K | A | Upper Center H | ~ | Rd Y O Gd = 24KΩ ±5% | 1
R111 | 22K | A | Upper Right H | ~ | R R O Gd = 22KΩ ±5% | 1
R113 | 560 | A | Center H | ~ | Gr Bl Br R = 560Ω ±2% | 1
R116 | 2K | A | Upper Left H | ~ | R Bk R R = 2KΩ ±2% | 1
R117 | 47K | A | Lower Center G | ~ | Y V O Gd = 47KΩ ±5% SOT pair 39303Ω | 1
R118 | 240K | A | Lower Center G | ~ | R Y Y Gd = 240KΩ ±5% | 1
R119 | 16K | A | Lower Left G | ~ | Br Bl O R = 16KΩ ±2% | 1
R120 | 1k8 | A | Center G | ~ | Br Gr R R = 1.8KΩ ±2% | 1
R127 | 510K | A | Lower Right G | ~ | Gr Br Y Gd = 510KΩ ±5% | 1
R128 | 91K | A | Bottom H-J Line | ~ | W Br O Gd = 91KΩ ±5% SOT pair 53529Ω | 1
R129 | 130K | A | Bottom H-J Line | ~ | Br O Y Gd = 130KΩ ±5% | 1
R132 | 5k6 | A | Bottom Right G | ~ | Gn Bl R R = 5.6KΩ ±2% | 1
R133 | 5k6 | A | Bottom G-H Line | ~ | Gn Bl R R = 5.6KΩ ±2% | 1
R134 | 1K | A | Bottom Left H | ~ | Br Bk R Gd = 1KΩ ±5% | 1
R135 | 500 | A | Center Right G | ~ | Gn Br Br Gd = 510Ω ±5% | 1
R146 | 2k4 | A | Lower Left J | ~ | R Y R R = 2.4KΩ ±2% [014 Aux Board] | 1
R147 | 7k5 | A | Lower Left J | ~ | V Gn R R = 7.5KΩ ±2% | 1
R161 | 150 | A | Lower F-G Line | ~ | Br Gn Br Gd = 150Ω ±5% | 1
R162 | 680 | A | Lower Right F | ~ | Bl Gr Br Gd = 680Ω ±5% | 1
R300 | 10K | A | Lower Left F | ~ | Br Bk O Gd = 10KΩ ±5% | 1
R301 | 20K | A | Center F | ~ | R Bk O Gd = 20KΩ ±5% | 1
R302 | 2K | A | Center F-G Line | ~ | R Bk R Gd = 2KΩ ±5% | 1
R303 | 2k2 | A | Upper A-B Line | ~ | R R R Gd = 2.2KΩ ±5% SOT pair 1859Ω | 1
R304 | 12K | A | Upper A-B Line | ~ | Br R O Gd = 12KΩ ±5% | 1
R307 | 4k7 | A | Upper Right G | ~ | Y V R R = 4.7KΩ ±2% | 1
R308 | 5k6 | A | Lower Right B | ~ | Gn Bl R R = 5.6KΩ ±2% | 1
R309 | 15K | A | Right B-G Line | ~ | Br Gn O R = 15KΩ ±2% | 1
R310 | 15K | A | Center A-B Line | ~ | Br Gn O Gd = 15KΩ ±5% SOT pair 14043Ω | 1
R311 | 220K | A | Center A-B Line | ~ | R R Y Gd = 220KΩ ±5% | 1
R312 | 180K | A | Center Left F | ~ | Br Gr Y Gd = 180KΩ ±5% | 1
R313 | 1k1 | A | Lower Left C | ~ | Br Br R Gd = 1.1KΩ ±5% | 1
R315 | 3K | A | Upper Center F | ~ | O Bk R Gd = 3KΩ ±5% | 1
R316 | 10K | A | Lower A-B Line | ~ | Br Bk O Gd = 10KΩ ±5% SOT pair 9231Ω | 1
R317 | 120K | A | Lower A-B Line | ~ | Br R Y Gd = 120KΩ ±5% | 1
R318 | 5k6 | A | Upper F-G Line | ~ | Gn Bl R Gd = 5.6KΩ ±5% SOT pair 4638Ω | 1
R319 | 27K | A | Upper F-G Line | ~ | R V O Gd = 27KΩ ±5% | 1
R320 | 2K | A | Upper Right G | ~ | R Bk R Gd = 2KΩ ±5% | 1
R323 | 20K | A | Center Right F | ~ | R Bk O Gd = 20KΩ ±5% | 1
R324 | 4k7 | A | Lower Right B | ~ | Y V R Gd = 4.7KΩ ±5% SOT pair 4003Ω | 1
R325 | 27K | A | Right B-G Line | ~ | R V O Gd = 27KΩ ±5% | 1
R326 | 1K | A | Upper Left F | ~ | Br Bk R Gd = 1KΩ ±5% | 1
R327 | 6k8 | A | Lower Right B | ~ | Bl Gr R R = 6.8KΩ ±2% | 1
R329 | 130K | A | Upper Right G | ~ | Br O Y R = 130KΩ ±2% | 1
R350 | 10K | A | Lower Left F | ~ | Br Bk O Gd = 10KΩ ±5% | 1
R351 | 20K | A | Lower Right F | ~ | R Bk O Gd = 20KΩ ±5% | 1
R352 | 2K | A | Lower Left G | ~ | R Bk R Gd = 2KΩ ±5% | 1
R353 | 2k2 | A | Lower A-B Line | ~ | R R R Gd = 2.2KΩ ±5% SOT pair 1833Ω | 1
R354 | 11K | A | Lower A-B Line | ~ | Br Br O Gd = 11KΩ ±5% | 1
R360 | 15K | A | Center A-B Line | ~ | Br Gn O Gd = 15KΩ ±5% SOT pair 13846Ω | 1
R361 | 180K | A | Center A-B Line | ~ | Br Gr Y Gd = 180KΩ ±5% | 1
R362 | 180K | A | Upper Right F | ~ | Br Gr Y Gd = 180KΩ ±5% | 1
R363 | 1K | A | Lower Left A | ~ | Br Bk R Gd = 1KΩ ±5% | 1
R365 | 3K | A | Upper Right F | ~ | O Bk R Gd = 3KΩ ±5% | 1
R366 | 180K | A | Upper F-G Line | ~ | Br Gr Y Gd = 180KΩ ±5% SOT pair 9474Ω | 1
R367 | 10K | A | Upper F-G Line | ~ | Br Bk O Gd = 10KΩ ±5% | 1
R368 | 5k6 | A | Upper F-G Line | ~ | Gn Bl R Gd = 5.6KΩ ±5% SOT pair 4464Ω | 1
R369 | 22K | A | Upper F-G Line | ~ | R R O Gd = 22KΩ ±5% | 1
R373 | 20K | A | Lower Left G | ~ | R Bk O Gd = 20KΩ ±5% | 1
R900 | 270 | A | Center J-K Line | ~ | R B Br Gd = 270Ω ±5% | 1
R901 | 160 | A | Center Right J | ~ | Br Bl Br Gd = 160Ω ±5% | 1
R902 | 1K | A | Lower Center K | ~ | Br Bk R Gd = 1KΩ ±5% {parallel pair with R928} | 1
R903 | 14K | A | Lower Right K | ~ | Br Y Bk R R = 14KΩ ±2% SOT pair 12874Ω | 1
R904 | 160K | A | Lower Right K | ~ | Br Bl Y Gd = 160KΩ ±5% | 1
R906 | 3K | A | Center Right K | ~ | O Bk R Gd = 3KΩ ±5% | 1
R907 | 100K | A | Lower Right K | ~ | 014: Bn Bk Y Gd = 100KΩ ±5% | 1
R908 | 150K | A | Upper Left K | ~ | Br Gn Y Gd = 150KΩ ±5% | 1
R909 | 18K | A | Center Right E | ~ | Br Gr O Gd =18KΩ ±5% | 1
R910 | 300 | A | Lower Right E | ~ | O Bk Br Gd = 300Ω ±5% | 1
R911 | 2k2 | A | Lower Center E | ~ | R R R Gd = 2.2KΩ ±5% | 1
R912 | 56K | A | Right D-J Line | ~ | Gn Bl O Gd = 56KΩ ±5% | 1
R913 | 180K | A | Left E-K Line | ~ | Br Gr Y Gd = 180KΩ ±5% | 1
R914 | 8k2 | A | Upper Left J | ~ | Gr R R Gd = 8.2KΩ ±5% | 1
R915 | 8k2 | A | Upper Left J | ~ | Gr R R Gd = 8.2KΩ ±5% | 1
R916 | 180k | A | Lower C-D Line | ~ | Br Gr Y Gd = 180KΩ ±5% | 1
R917 | 3K | A | Center Left D | ~ | O Bk R Gd = 3KΩ ±5% | 1
R918 | 10K | A | Lower Left D | ~ | Br Bk O Gd = 10KΩ ±5% | 1
R919 | 82K | A | Right D-J Line | ~ | Gr R O Gd = 82KΩ ±5% | 1
R920 | 20K | A | Upper Center J | ~ | R Bk O Gd = 20KΩ ±5% | 1
R921 | 20K | A | Upper Center J | ~ | R Bk O Gd = 20KΩ ±5% | 1
R922 | 1k8 | A | Lower Right D | ~ | Br Gr R Gd = 1.8KΩ ±5% | 1
R923 | 1k8 | A | Upper Right J | ~ | Br Gr R Gd = 1.8KΩ ±5% | 1
R924 | 180k | A | Center E | ~ | Br Gr Y Gd = 180KΩ ±5% | 1
R925 | 300 | A | Lower Left D | ~ | O Bk Br Gd = 300Ω ±5% | 1
R926 | 3K | A | Center D-E Line | ~ | O Bk R Gd = 3KΩ ±5% | 1
R927 | 10K | A | Lower Center D | ~ | Br Bk O Gd = 10KΩ ±5% | 1
R928 | 270 | A | Lower Right K | ~ | R V Br Gd = 270Ω ±5% | 1
R929 | 390 | A | Lower Center J | ~ | O W Br R = 390Ω ±2% | 1
R930 | 1K | A | Lower J-K Line | ~ | Br Bk R Gd = 1KΩ ±5% | 1
R931 | 270 | A | Center J-K Line | ~ | R V Br Gd = 270Ω ±5% | 1
R932 | 14K | A | Lower J-K Line | ~ | Br Y Bk R R = 14KΩ ±2% SOT pair 12874Ω | 1
R933 | 160K | A | Lower J-K Line | ~ | Br Bl Y Gd = 160KΩ ±5% | 1
R934 | 270 | A | Lower Center J | ~ | R V Br Gd = 270Ω ±5% | 1
R935 | 15K | A | Upper Right K | ~ | Br Gn O Gd = 15KΩ ±5% | 1
R936 | 10K | A | Upper Right K | ~ | Br Bk O Gd = 10KΩ ±5% | 1
R937 | 47K | A | Center Right E | ~ | Y V O Gd = 47KΩ ±5% | 1
R938 | 240K | A | Lower Right E | ~ | R Y Y Gd = 240KΩ ±5% | 1 | 105 | 260
Reference | Value | PCB | Footprint | Datasheet | Notes | Qty
T200 | S7324 | M | Package_TO_SOT_THT:TO-92_Inline | http://www.fairchildsemi.com/ds/BC/BC547.pdf | Left B-G Line | 1
T201 | S2670 | M | Package_TO_SOT_THT:TO-92_Inline | http://www.fairchildsemi.com/ds/BC/BC547.pdf | Lower A-B Line - "TIY S 09" | 1
T203 | S2066 | M | Package_TO_SOT_THT:TO-92_Inline | http://www.fairchildsemi.com/ds/BC/BC557.pdf | Center A-B Line - "TIY S 21" | 1
T304 | BCY58 | M | Package_TO_SOT_THT:TO-92_Inline | http://www.fairchildsemi.com/ds/BC/BC547.pdf | Lower Left G BCY57R M407 | 1
T400 | BCY57 | M | Package_TO_SOT_THT:TO-92_Inline | http://www.fairchildsemi.com/ds/BC/BC547.pdf | Lower Left H | 1
T401 | BSX95 | M | Package_TO_SOT_THT:TO-92_Inline | http://www.fairchildsemi.com/ds/BC/BC547.pdf | Lower Right H | 1
T500 | BCY58 | M | Package_TO_SOT_THT:TO-92_Inline | http://www.fairchildsemi.com/ds/BC/BC547.pdf | Center K | 1
T501 | BSX95 | M | Package_TO_SOT_THT:TO-92_Inline | https://diotec.com/tl_files/diotec/files/pdf/datasheets/bc337.pdf | Center Right K | 1
T502 | AUY21 | M | Package_TO_SOT_THT:TO-3PB-3_Vertical | http://skory.gylcomp.hu/alkatresz/2SB817.pdf | Lower Right E wired out to heat sink | 1
T503 | AUY21 | M | Package_TO_SOT_THT:TO-3PB-3_Vertical | http://skory.gylcomp.hu/alkatresz/2SB817.pdf | Center Right K wired out to heat sink | 1
T504 | BSX95 | M | Package_TO_SOT_THT:TO-92_Inline | https://diotec.com/tl_files/diotec/files/pdf/datasheets/bc337.pdf | Center Right K | 1
T505 | BCY58 | M | Package_TO_SOT_THT:TO-92_Inline | http://www.fairchildsemi.com/ds/BC/BC547.pdf | Center K | 1
T506 | BCY58 | M | Package_TO_SOT_THT:TO-92_Inline | http://www.fairchildsemi.com/ds/BC/BC547.pdf | Lower Center J | 1
T550 | BCY58 | M | Package_TO_SOT_THT:TO-92_Inline | http://www.fairchildsemi.com/ds/BC/BC547.pdf | Center E | 1
T551 | BSX95 | M | Package_TO_SOT_THT:TO-92_Inline | https://diotec.com/tl_files/diotec/files/pdf/datasheets/bc337.pdf | Center Right E | 1
T552 | AUY21 | M | Package_TO_SOT_THT:TO-3PB-3_Vertical | http://skory.gylcomp.hu/alkatresz/2SB817.pdf | Upper Right K wired out to heat sink | 1
T553 | AUY21 | M | Package_TO_SOT_THT:TO-3PB-3_Vertical | http://skory.gylcomp.hu/alkatresz/2SB817.pdf | Upper Right E wired out to heat sink | 1
T554 | BSX95 | M | Package_TO_SOT_THT:TO-92_Inline | https://diotec.com/tl_files/diotec/files/pdf/datasheets/bc337.pdf | Lower Right E | 1
T555 | BCY58 | M | Package_TO_SOT_THT:TO-92_Inline | http://www.fairchildsemi.com/ds/BC/BC547.pdf | Lower Center E | 1
T556 | BCY58 | M | Package_TO_SOT_THT:TO-92_Inline | http://www.fairchildsemi.com/ds/BC/BC547.pdf | Center Left D | 1
T604 | BCY57 | M | Package_TO_SOT_THT:TO-92_Inline | http://www.fairchildsemi.com/ds/BC/BC547.pdf | Upper Right H | 1
T605 | BCY57 | M | Package_TO_SOT_THT:TO-92_Inline | http://www.fairchildsemi.com/ds/BC/BC547.pdf | Lower Right H | 1
T700 | BCY58 | M | Package_TO_SOT_THT:TO-92_Inline | http://www.fairchildsemi.com/ds/BC/BC547.pdf | Center Right G | 1
T701 | BCY58 | M | Package_TO_SOT_THT:TO-92_Inline | http://www.fairchildsemi.com/ds/BC/BC547.pdf | Center Left H | 1
T702 | BCY58 | M | Package_TO_SOT_THT:TO-92_Inline | http://www.fairchildsemi.com/ds/BC/BC547.pdf | Upper Left H | 1
T703 | BCY58 | M | Package_TO_SOT_THT:TO-92_Inline | http://www.fairchildsemi.com/ds/BC/BC547.pdf | Lower Left C | 1
T800 | BCY58 | M | Package_TO_SOT_THT:TO-92_Inline | http://www.fairchildsemi.com/ds/BC/BC547.pdf | Upper Left C | 1
T801 | BCY58 | M | Package_TO_SOT_THT:TO-92_Inline | http://www.fairchildsemi.com/ds/BC/BC547.pdf | Center Right B | 1
T802 | S2066 | M | Package_TO_SOT_THT:TO-92_Inline | http://www.fairchildsemi.com/ds/BC/BC557.pdf | Lower Right D | 1
T803 | BCY58 | M | Package_TO_SOT_THT:TO-92_Inline | http://www.cdil.com/datasheets/bc413_14_b_c.pdf | Upper Right J | 1
T804 | BCY58 | M | Package_TO_SOT_THT:TO-92_Inline | http://www.fairchildsemi.com/ds/BC/BC547.pdf | Upper Right J | 1
T805 | BCY58 | M | Package_TO_SOT_THT:TO-92_Inline | http://www.fairchildsemi.com/ds/BC/BC547.pdf | Upper Right J | 1
T806 | BCY58 | M | Package_TO_SOT_THT:TO-92_Inline | http://www.fairchildsemi.com/ds/BC/BC547.pdf | Center Left J | 1
T100 | S2672 | A | Package_TO_SOT_THT:TO-92_Inline | http://www.fairchildsemi.com/ds/BC/BC547.pdf | Center Right C | 1
T101 | S2672 | A | Package_TO_SOT_THT:TO-92_Inline | http://www.fairchildsemi.com/ds/BC/BC547.pdf | Right C-H Line | 1
T102 | BCY58 | A | Package_TO_SOT_THT:TO-92_Inline | http://www.fairchildsemi.com/ds/BC/BC547.pdf | Upper Right H | 1
T103 | S2672 | A | Package_TO_SOT_THT:TO-92_Inline | http://www.fairchildsemi.com/ds/BC/BC547.pdf | Lower Left H | 1
T109 | BSX45 | A | Package_TO_SOT_THT:TO-92_Inline | http://www.fairchildsemi.com/ds/BC/BC547.pdf | Lower Right F | 1
T300 | BCY58 | A | Package_TO_SOT_THT:TO-92_Inline | http://www.fairchildsemi.com/ds/BC/BC547.pdf | Center Left F | 1 | 52
T301 | S2066 | A | Package_TO_SOT_THT:TO-92_Inline | http://www.fairchildsemi.com/ds/BC/BC557.pdf | Upper Left A | 1
T302 | S2066 | A | Package_TO_SOT_THT:TO-92_Inline | http://www.fairchildsemi.com/ds/BC/BC557.pdf | Center Left A | 1
T303 | BCY58 | A | Package_TO_SOT_THT:TO-92_Inline | http://www.fairchildsemi.com/ds/BC/BC547.pdf | Upper Center F | 1
T350 | BCY58 | A | Package_TO_SOT_THT:TO-92_Inline | http://www.fairchildsemi.com/ds/BC/BC547.pdf | Lower Right F | 1
T351 | S2066 | A | Package_TO_SOT_THT:TO-92_Inline | http://www.fairchildsemi.com/ds/BC/BC557.pdf | Lower Center A | 1
T352 | S2066 | A | Package_TO_SOT_THT:TO-92_Inline | http://www.fairchildsemi.com/ds/BC/BC557.pdf | Center A | 1
T353 | BCY58 | A | Package_TO_SOT_THT:TO-92_Inline | http://www.fairchildsemi.com/ds/BC/BC547.pdf | Left A-F Line | 1
T900 | S2066 | A | Package_TO_SOT_THT:TO-92_Inline | http://www.fairchildsemi.com/ds/BC/BC557.pdf | Center Right K | 1
T901 | BCY58 | A | Package_TO_SOT_THT:TO-92_Inline | http://www.fairchildsemi.com/ds/BC/BC547.pdf | Upper Right K | 1
T902 | BCY58 | A | Package_TO_SOT_THT:TO-92_Inline | http://www.fairchildsemi.com/ds/BC/BC547.pdf | Lower Center E | 1
T903 | BCY58 | A | Package_TO_SOT_THT:TO-92_Inline | http://www.fairchildsemi.com/ds/BC/BC547.pdf | Left D-J Line | 1
T904 | BCY58 | A | Package_TO_SOT_THT:TO-92_Inline | http://www.fairchildsemi.com/ds/BC/BC547.pdf | Center D-J Line | 1
T905 | S2066 | A | Package_TO_SOT_THT:TO-92_Inline | http://www.fairchildsemi.com/ds/BC/BC557.pdf | Lower J-K Line | 1
Reference | Value | PCB | Footprint | Datasheet | Notes | Qty
ECU1 | Edge Connector | M |  | ~ |  | 1
RV1 | ECU Rheostat | M |  | ~ | DRALOWID 65H | 1
MPS1 | Manifold Pressure Sensor |  |  | ~ | Bosch 0 280 100 100 | 1
SW1 | Start |  |  | ~ | Start Bus Power (T50) | 1
SW2 | Full Throttle |  |  | ~ | E2 grounded to E12 | 1
SW3 | At Idle |  |  | ~ | E17 Grounded to E12 | 1
T1 | Air Temp Sensor |  |  | Steinhart-Hart Calculator for T1 Air Temp Sensor | Bosch 0 280 130 006 | 1
T2 | Water Temp Sensor |  |  | Steinhart-Hart Calculator for T2 Coolant Temp Sensor | Bosch 0 280 130 014 | 1
