ajayre/djetecu/005/Schematics/Bosch 0 280 002 005 ECU Schematic 1.08.pdf

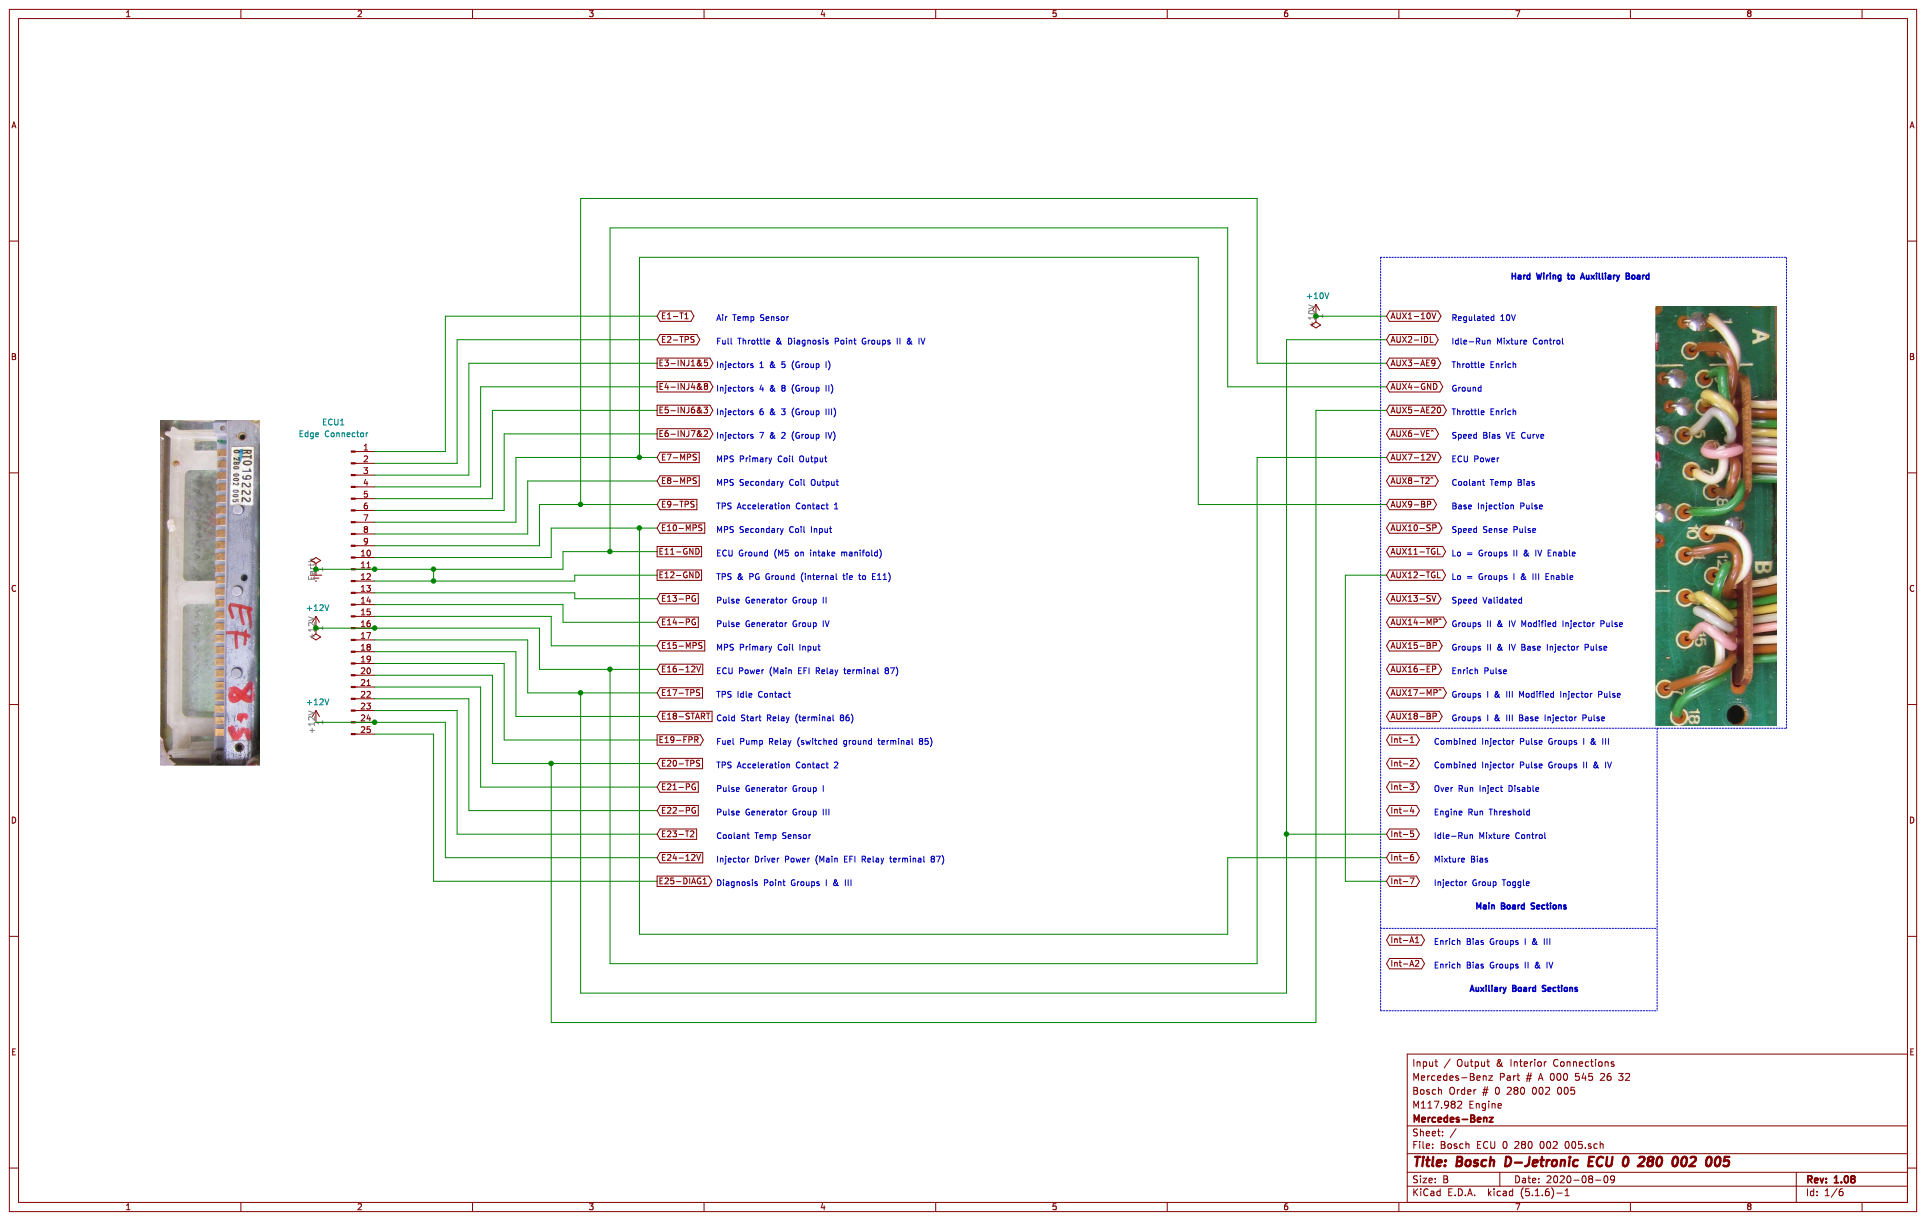
[picture p13: page 1]

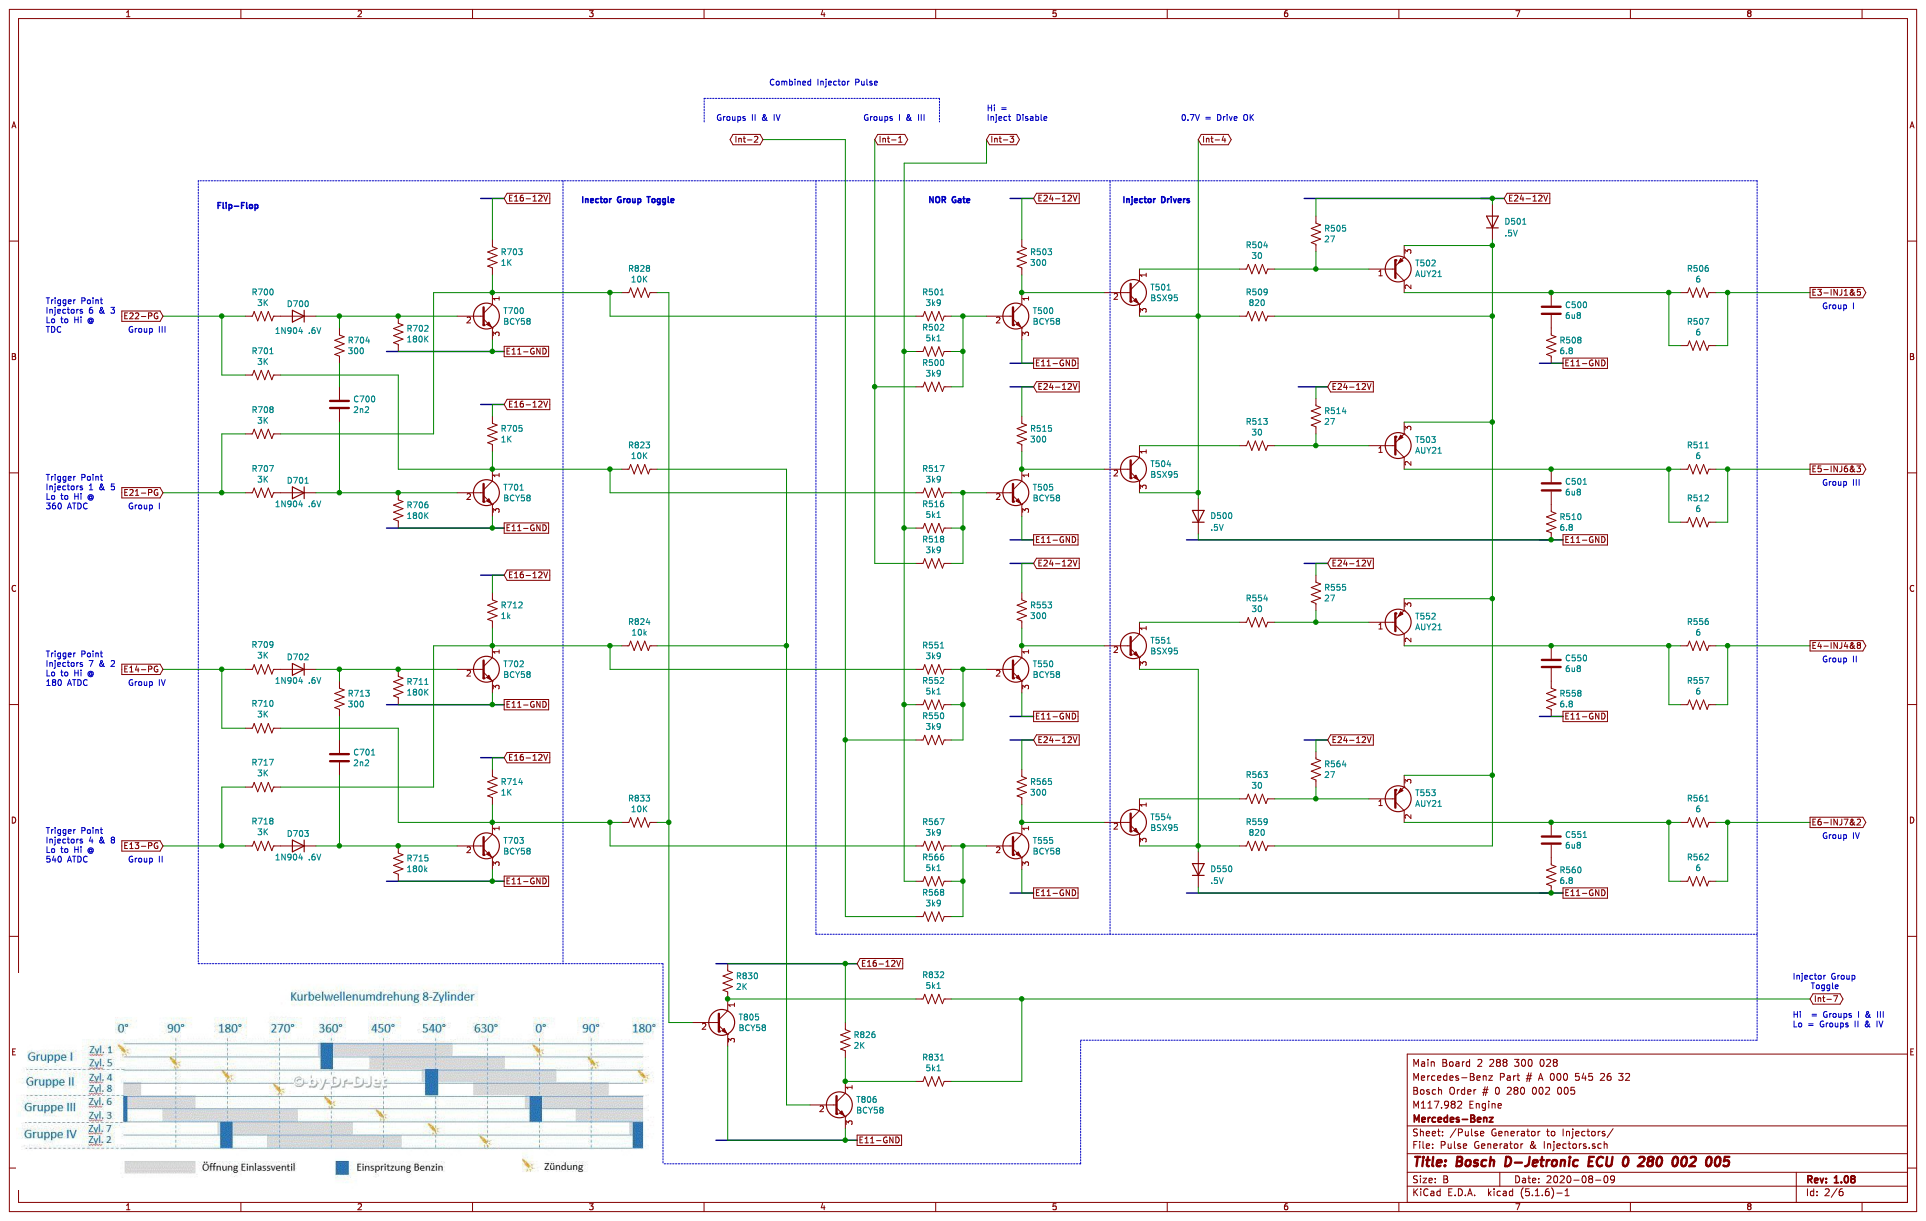
[picture p14: page 2]

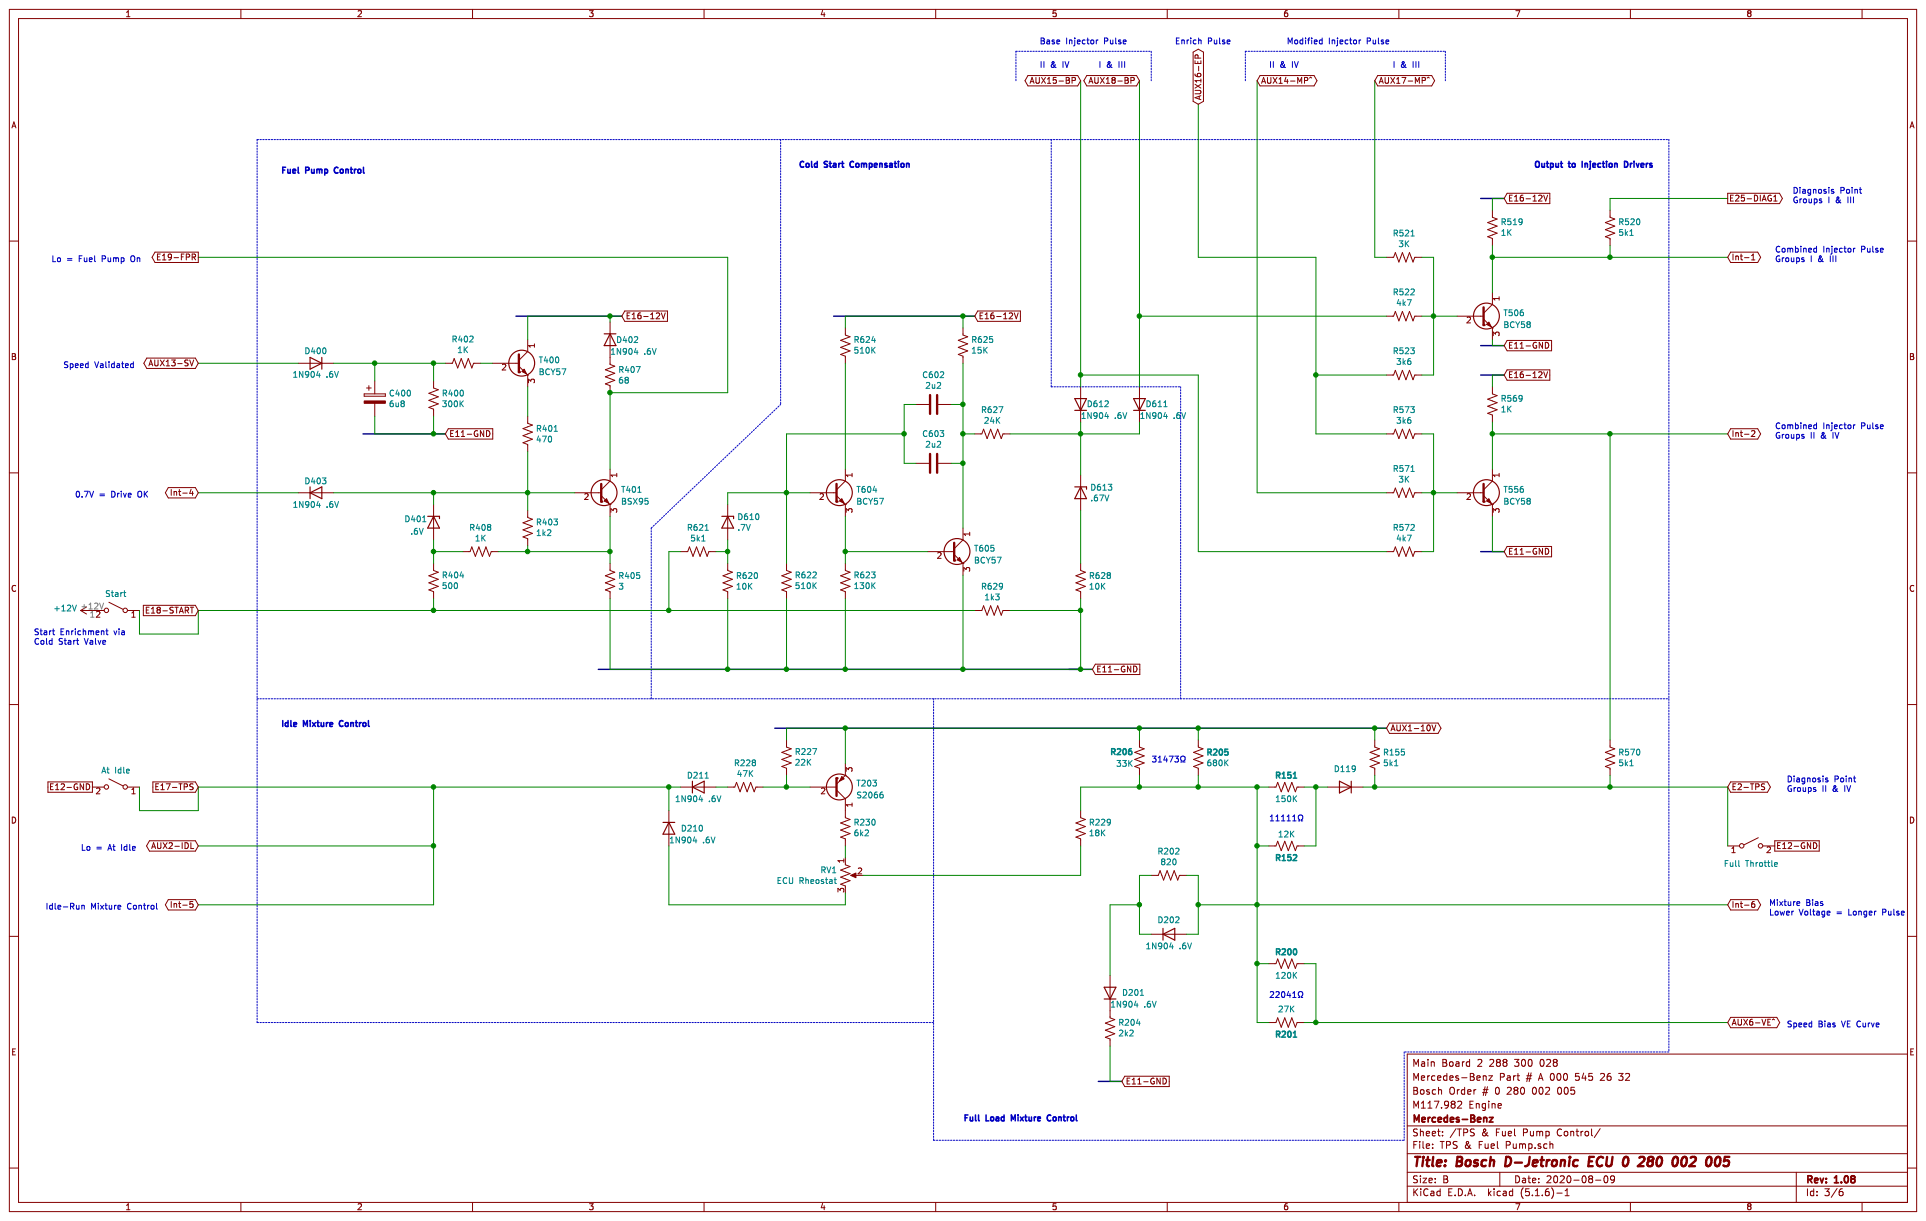
[picture p15: page 3]

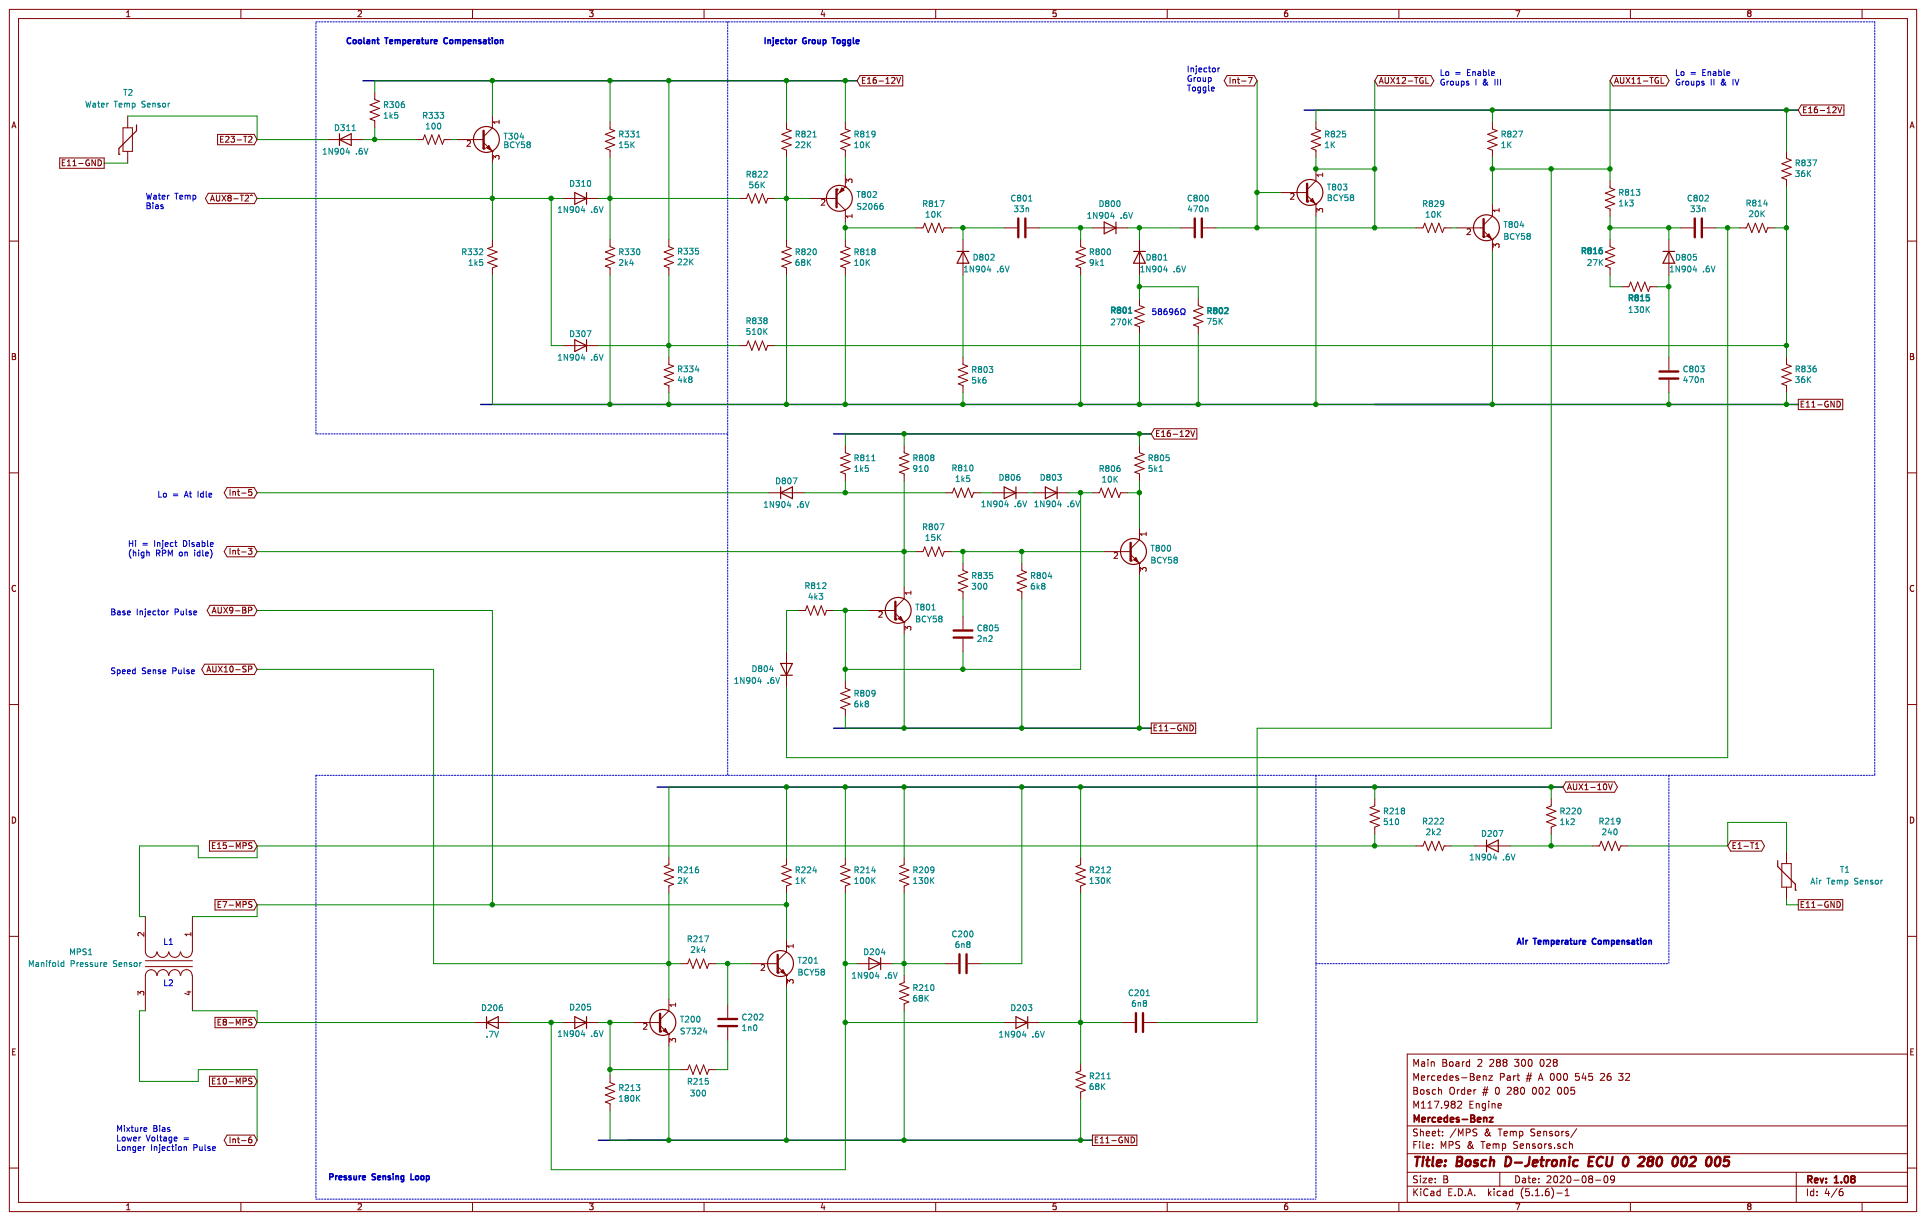
[picture p16: page 4]

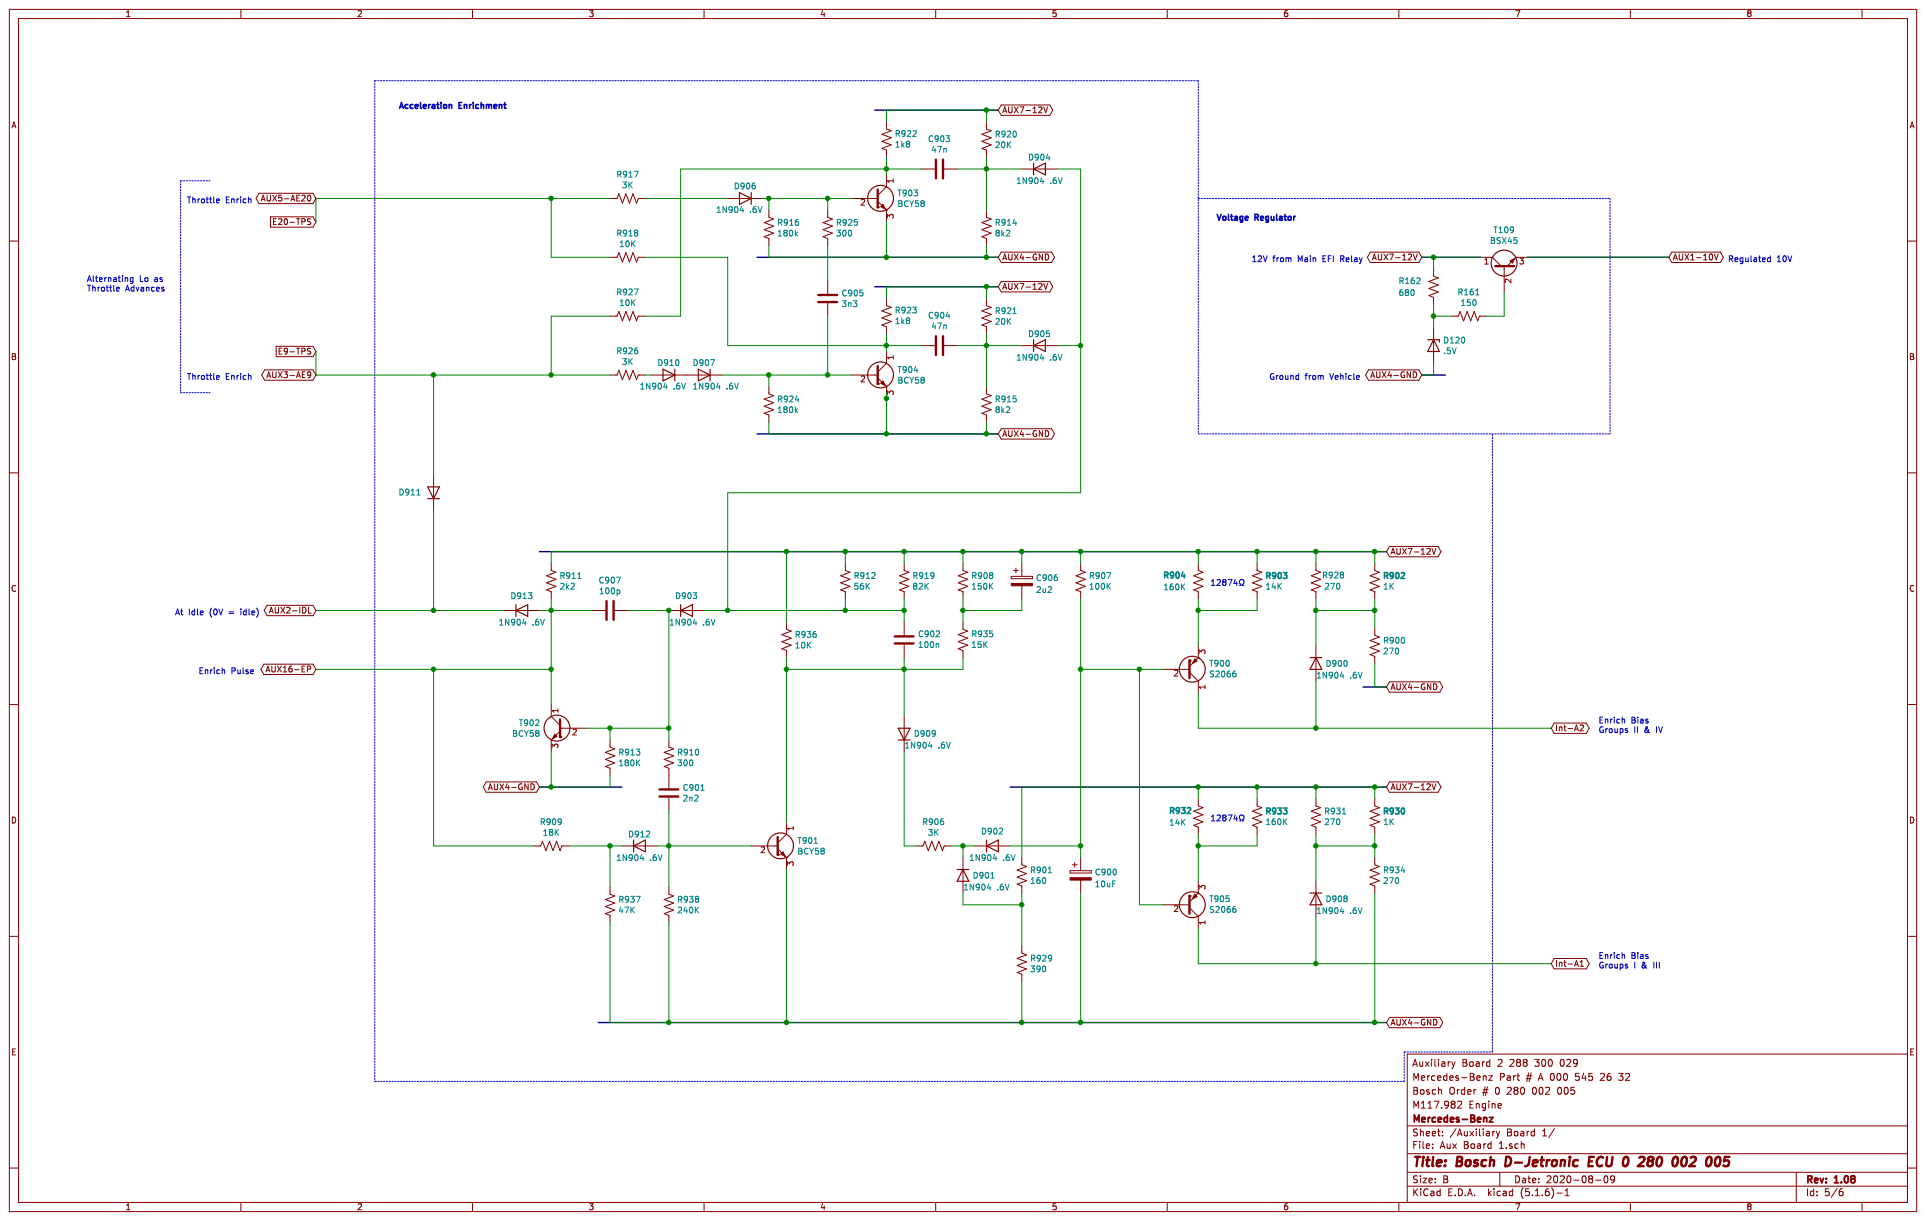
[picture p17: page 5]

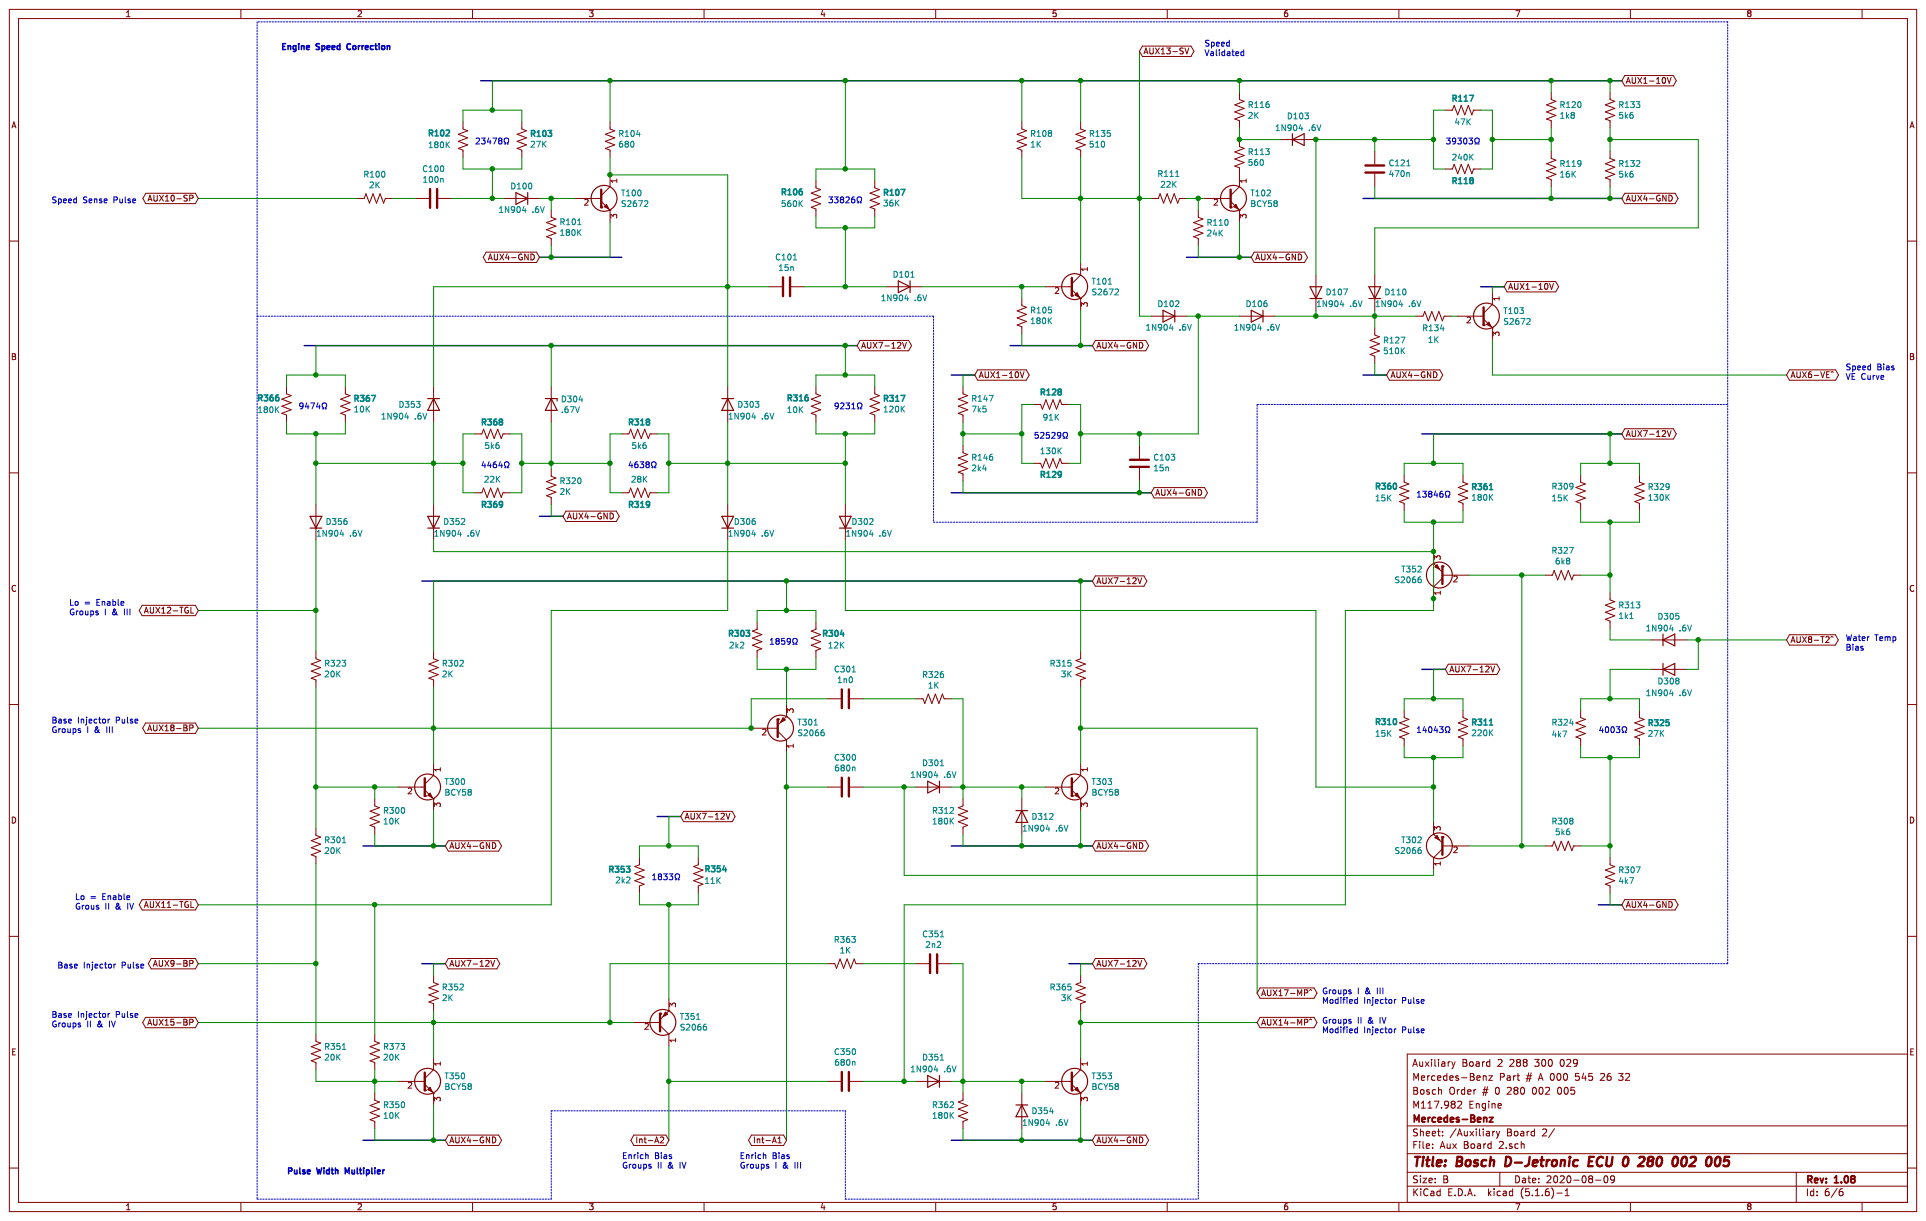
[picture p18: page 6]
