ajayre/djetecu/005/Schematics/Bosch 0 280 002 005 ECU Schematic 1.09.pdf

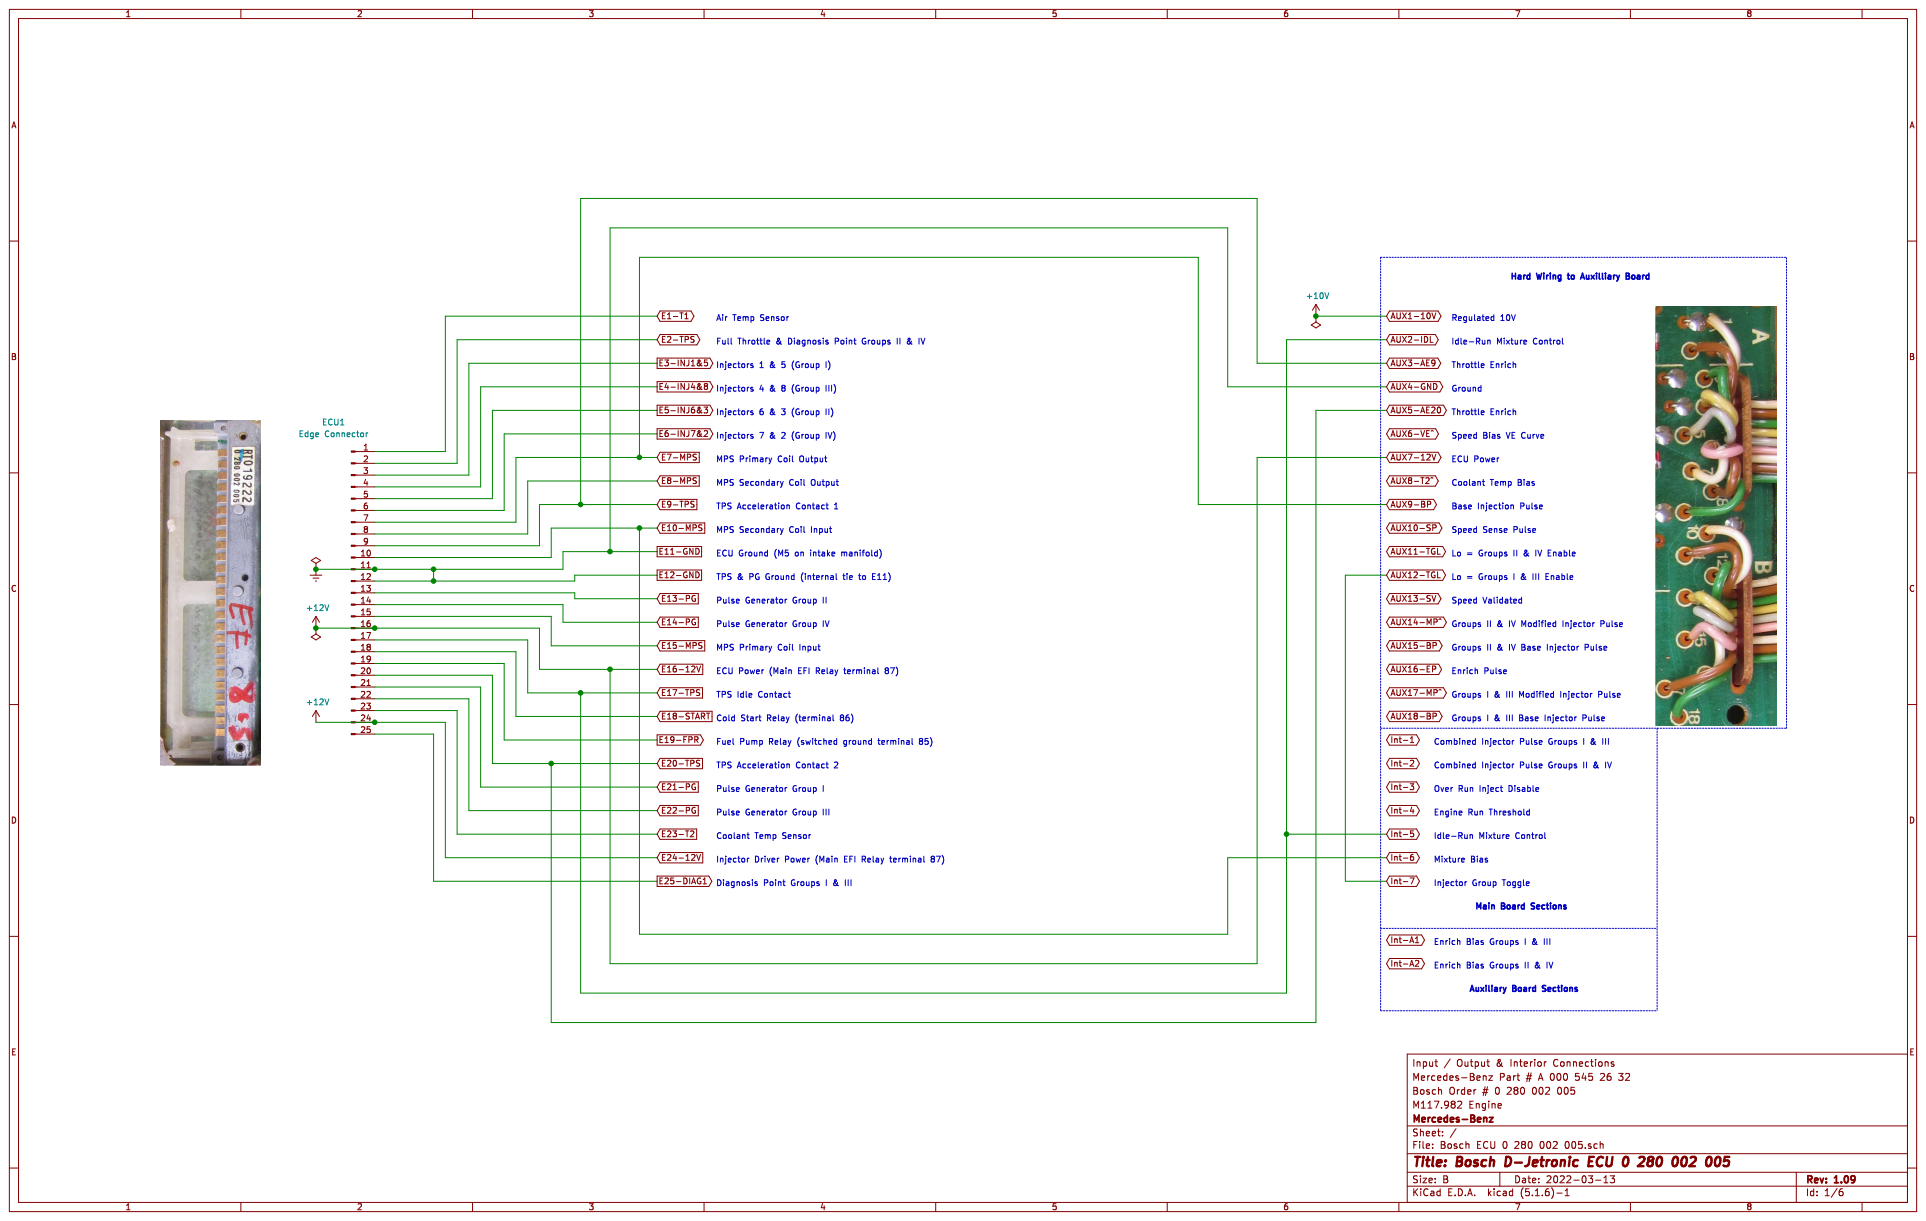
[picture p19: page 1]

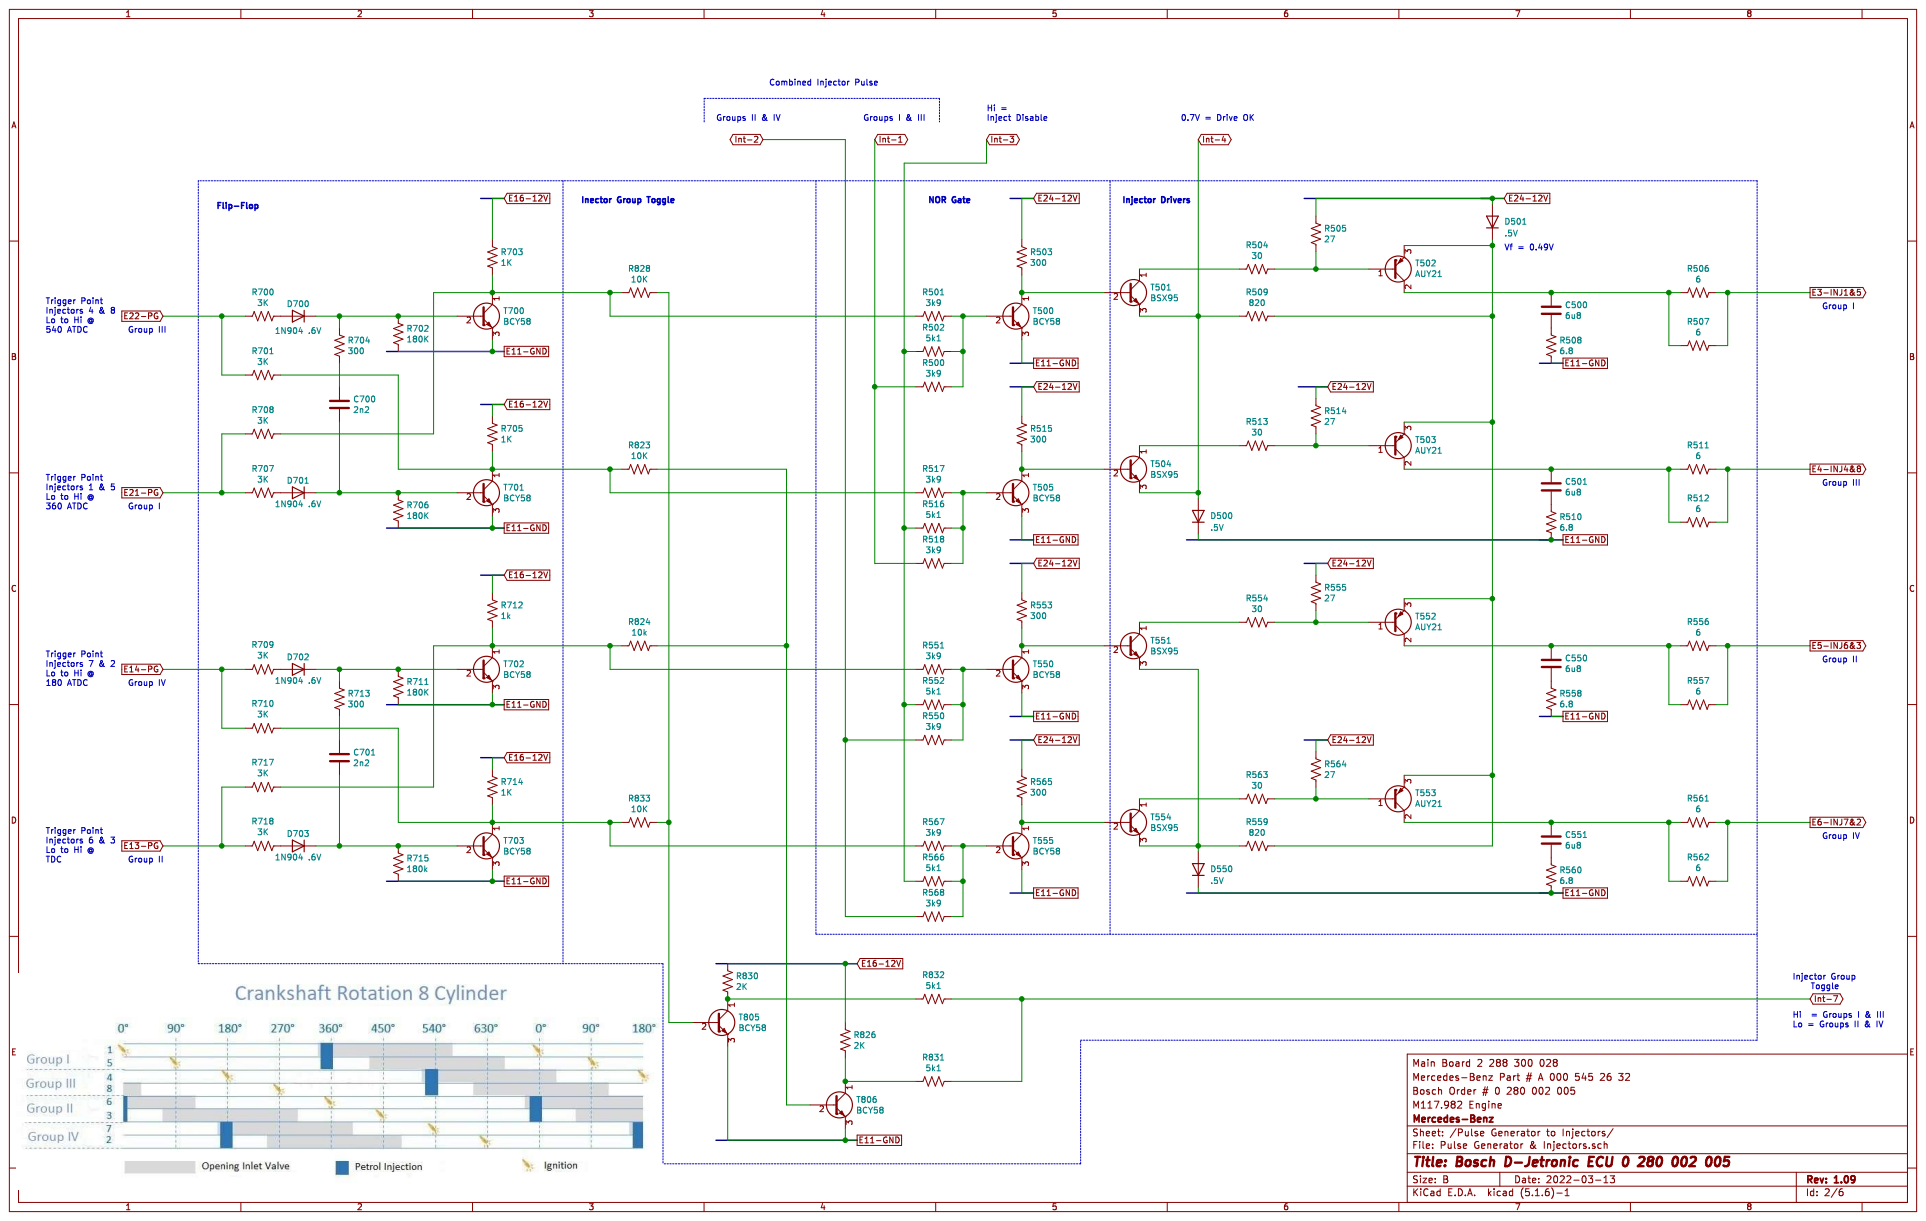
[picture p20: page 2]

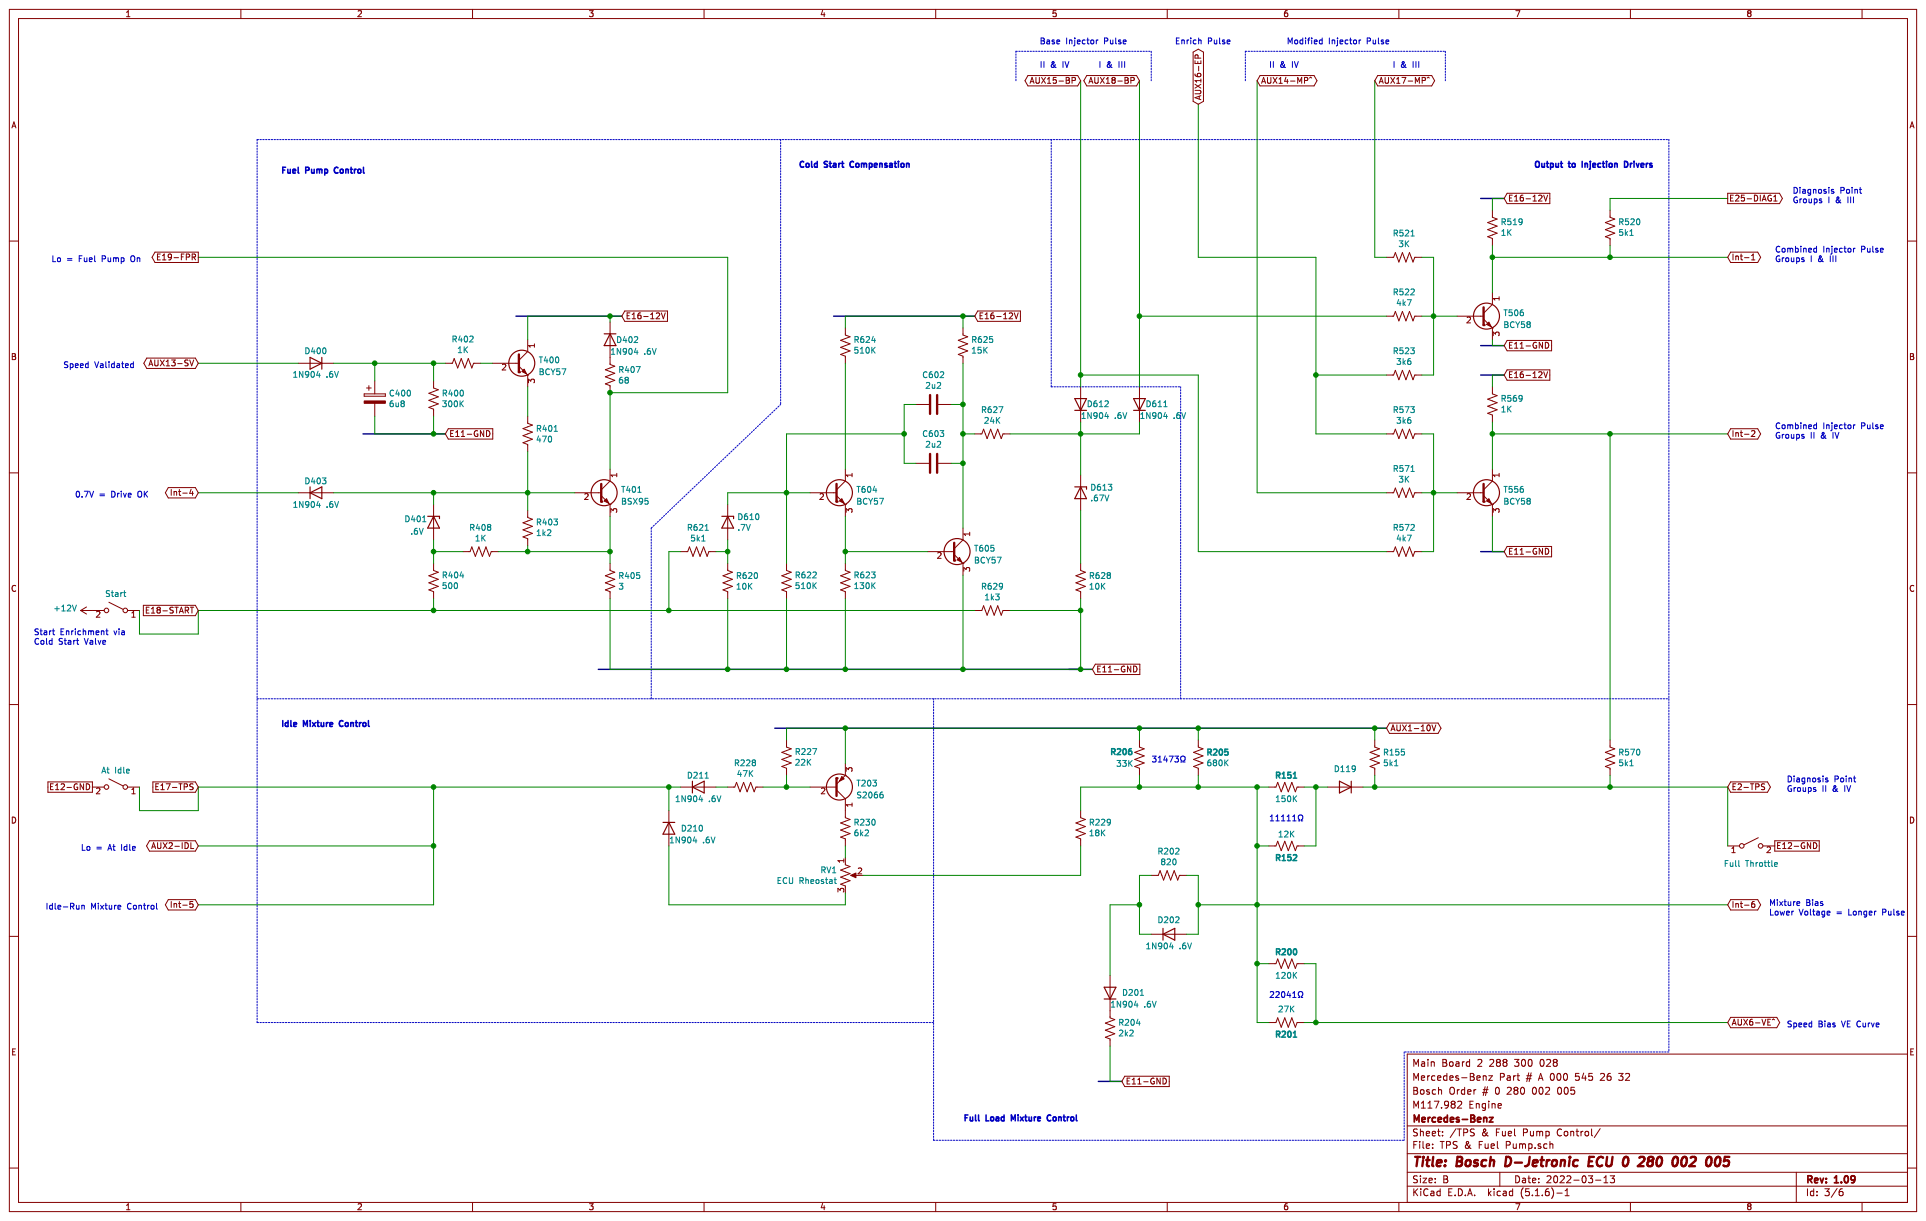
[picture p21: page 3]

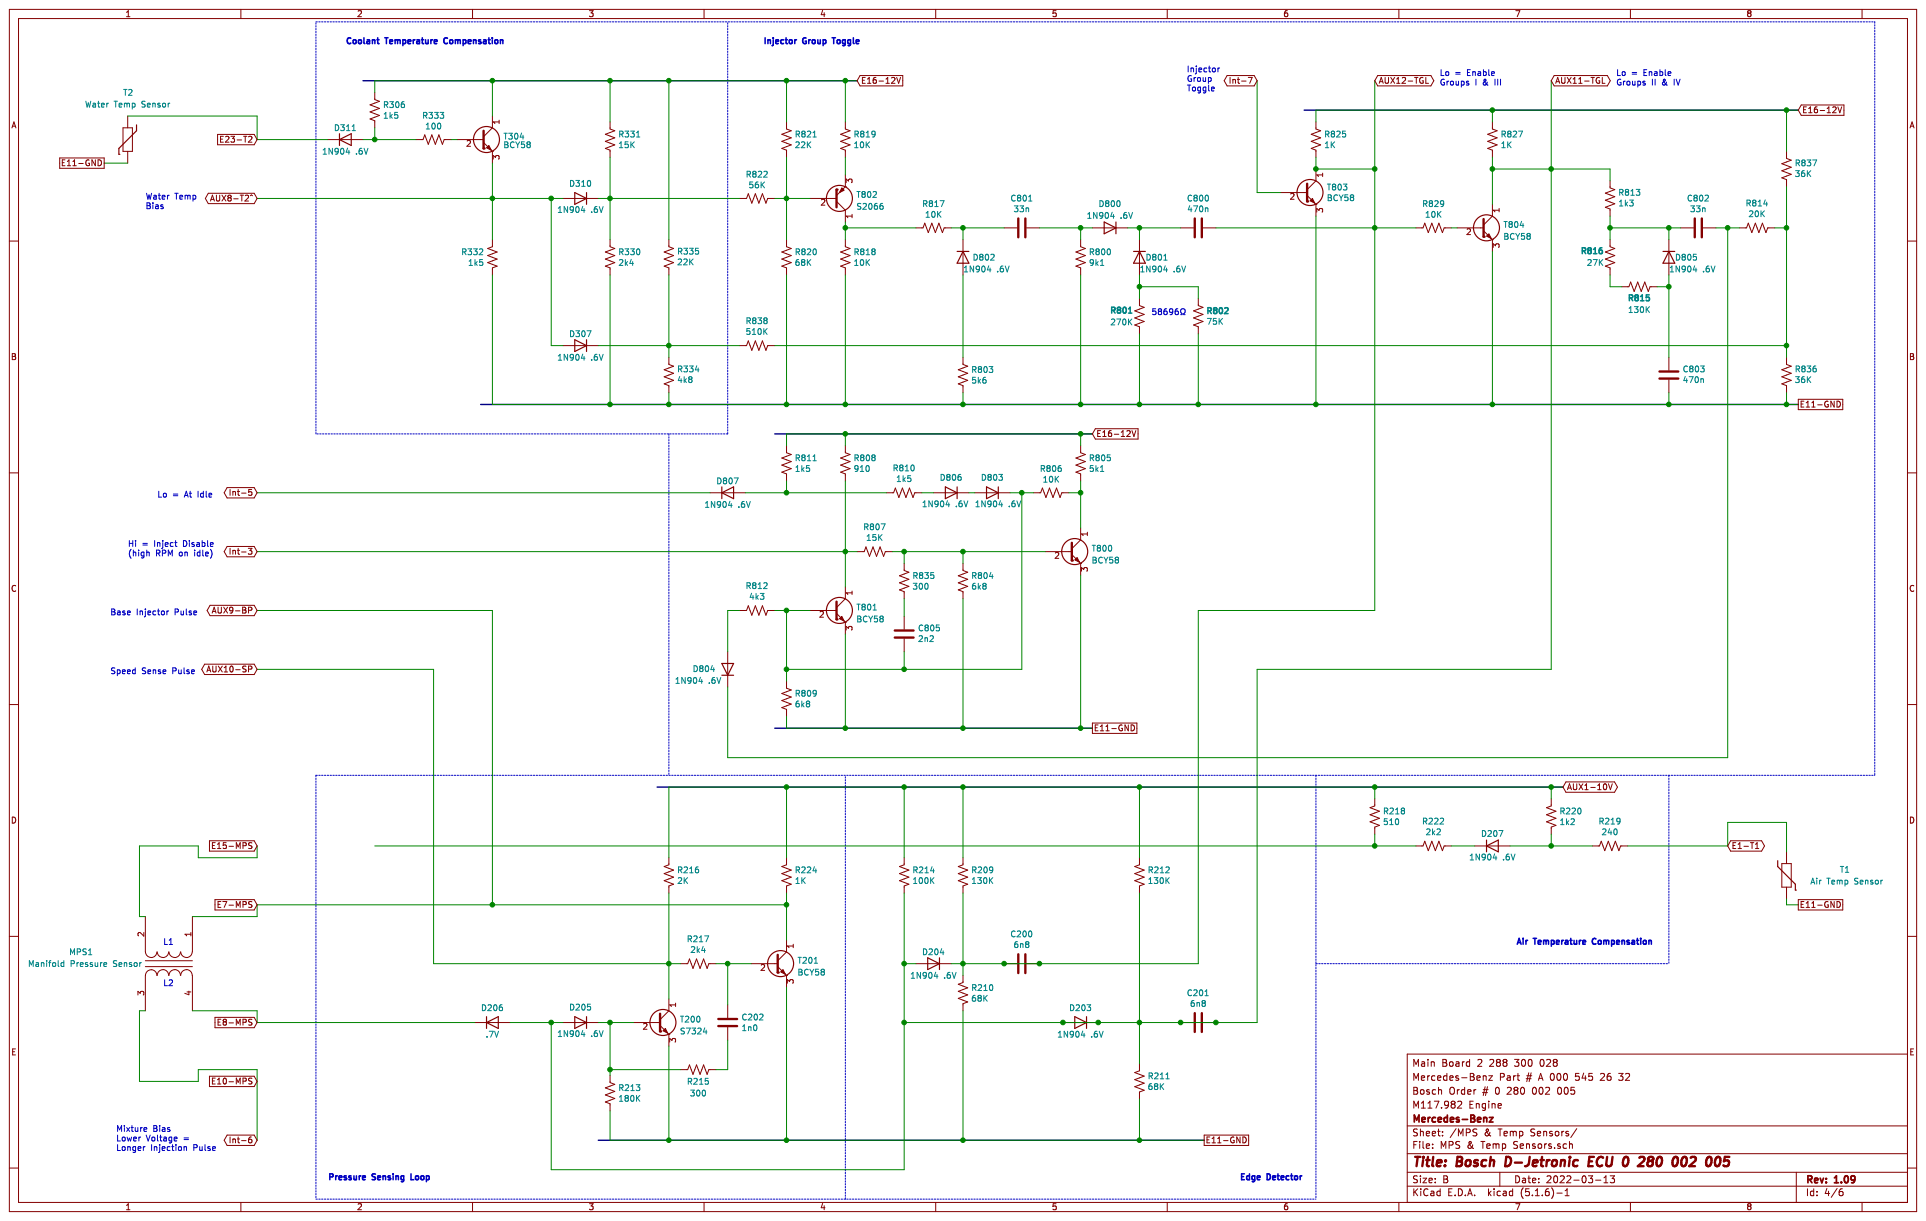
[picture p22: page 4]

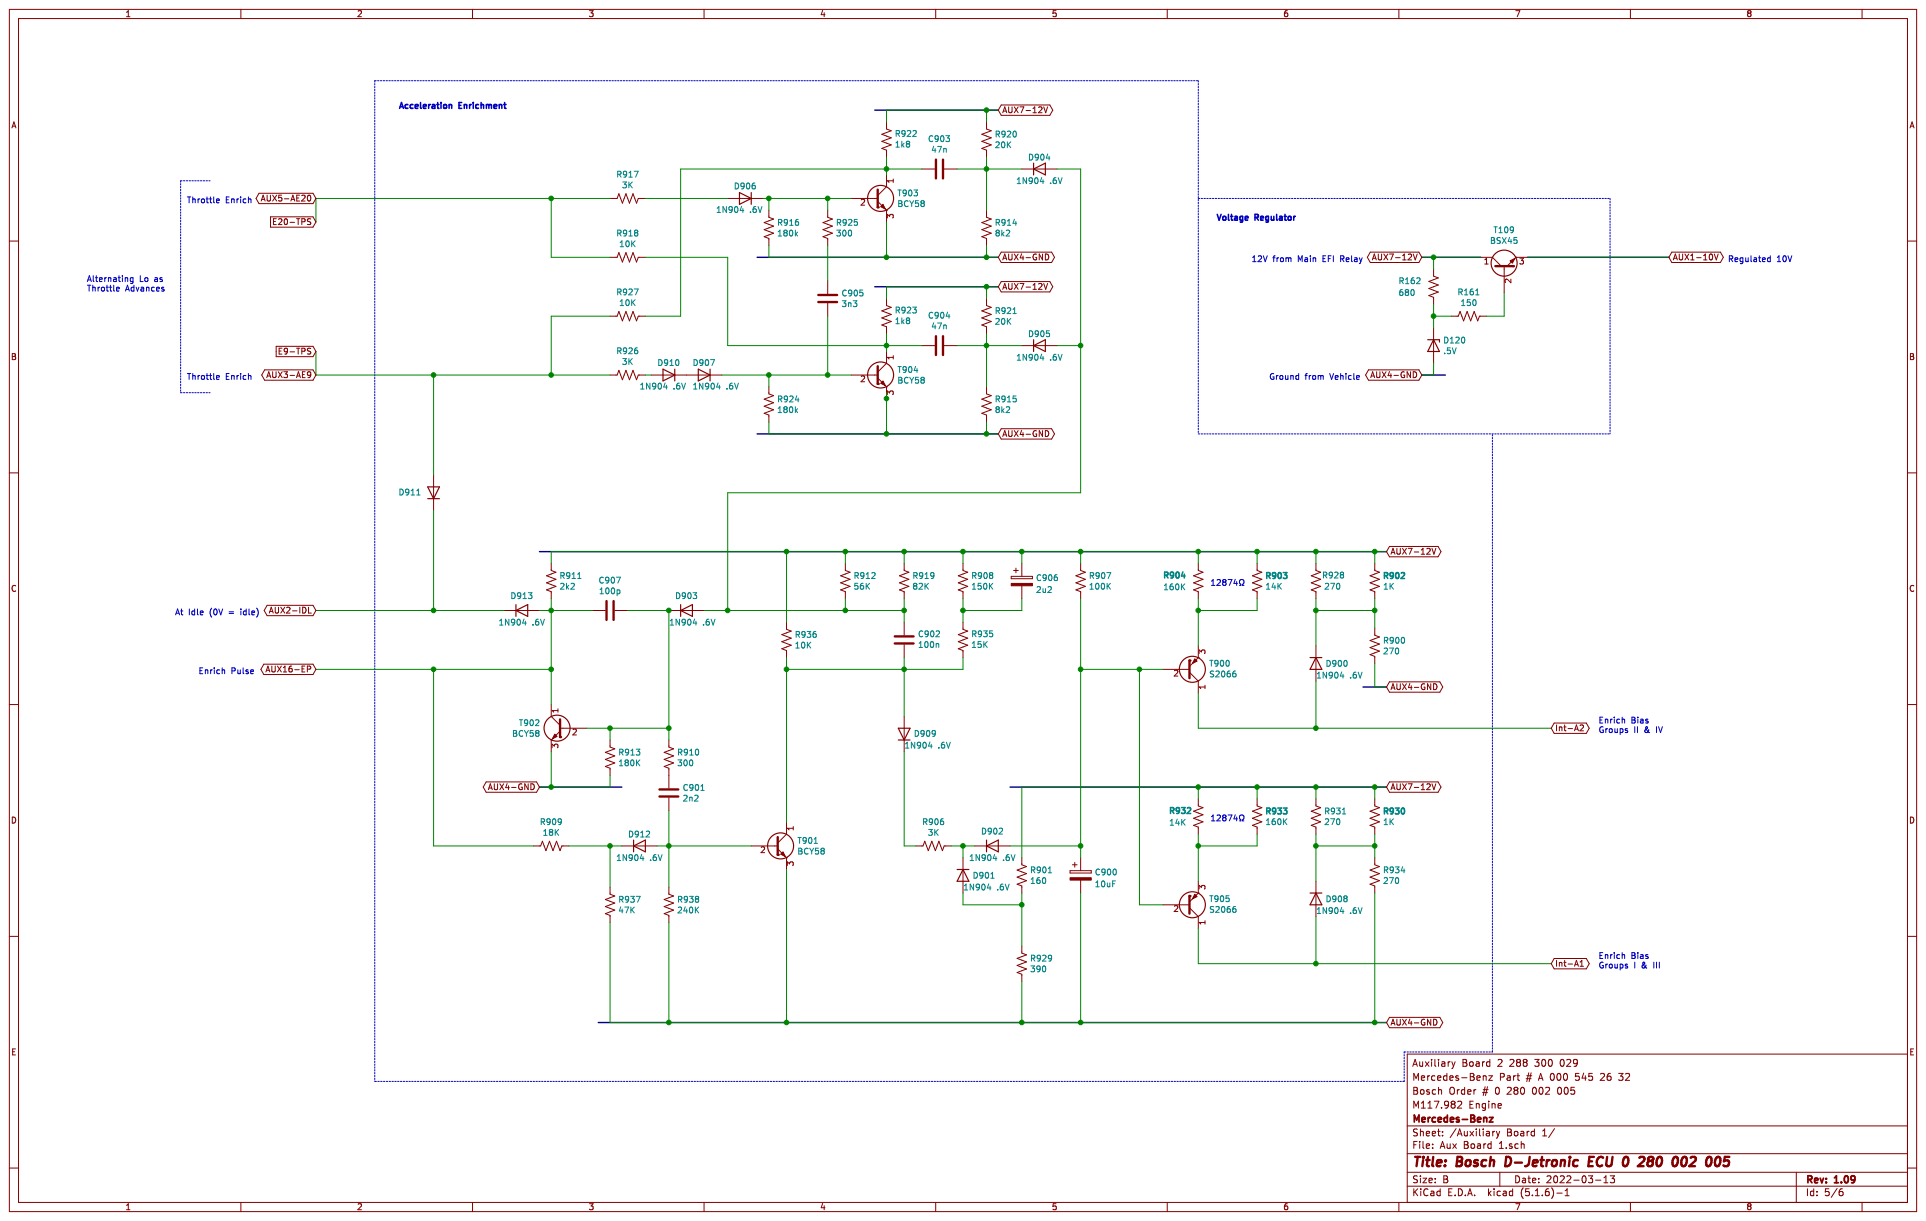
[picture p23: page 5]

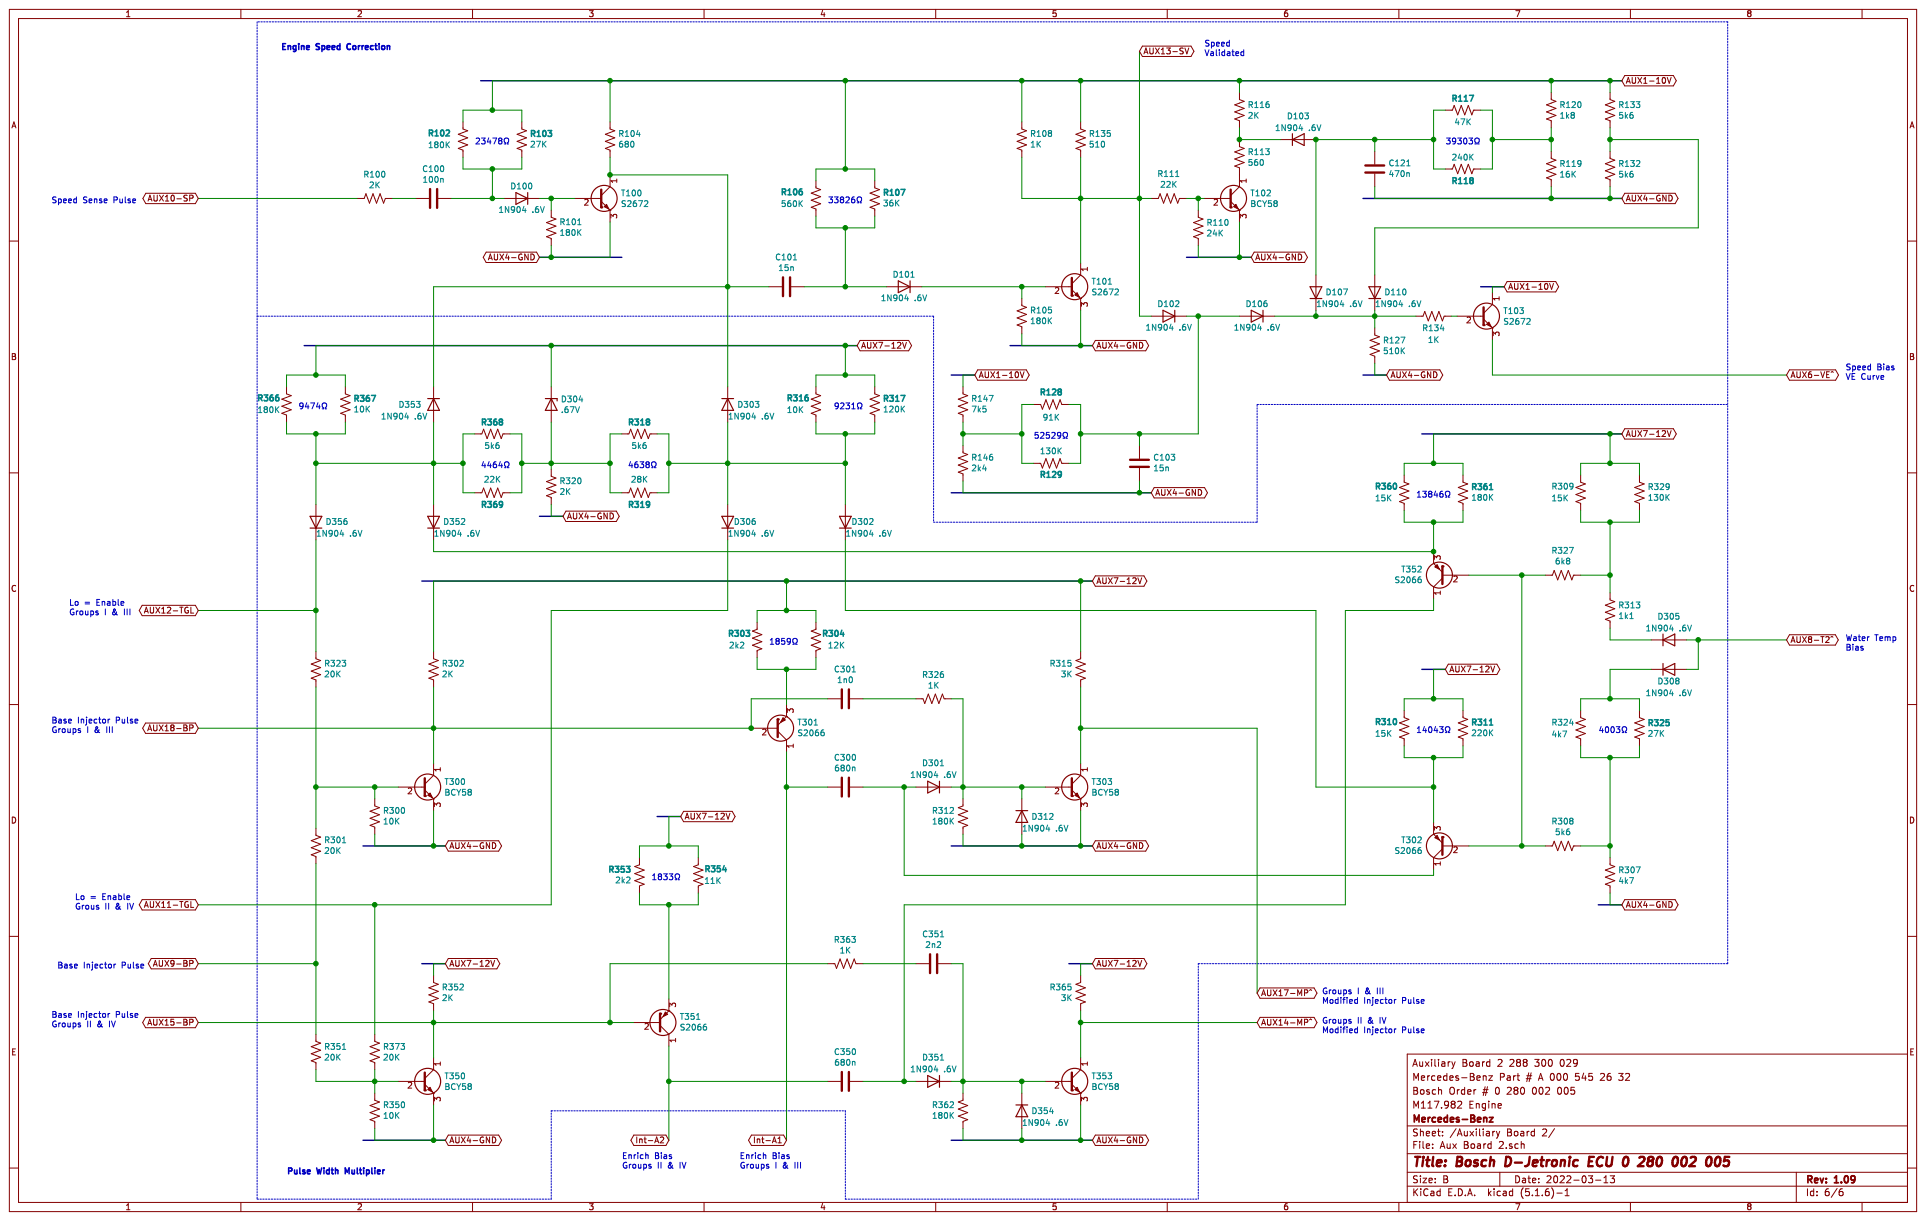
[picture p24: page 6]
