ajayre/djetecu/005/Schematics/Aux Board 1.sch

## KiCad design 005/Schematics/Aux Board 1.sch (2024-06-13)

Schematic: Aux Board 1.sch

Parts:
C900: 10uF; Aux Center D-E Line
C901: 2n2; Aux Upper Center K
C902: 100n; Aux Upper Right K
C903: 47n; Aux Right D-J Line
C904: 47n; Aux Upper Left J
C905: 3n3; Aux Center D-E Line
C906: 2u2; Aux Upper D-E Line
C907: 100p; Aux Lower Left E
D120: .5V; Aux Lower Left G
D900, D902: 1N904 .6V; Aux Center Right K
D901: 1N904 .6V; Aux Center Left K
D903: 1N904 .6V; Aux Left E-K Line
D904, D905: 1N904 .6V; Aux Upper Left K
D906: 1N904 .6V; Aux Lower Left D
D907: 1N904 .6V; Aux Lower D-E Line
D908: 1N904 .6V; Aux Lower Left K
D909: 1N904 .6V; Aux Upper Right K
D910: 1N904 .6V; Aux Lower Right D
D911: 1N904 .6V; Aux Upper D-E Line
D912: 1N904 .6V; Aux Lower Right E
D913: 1N904 .6V; Aux Center E
R161: 150; Aux Lower F-G Line
R162: 680; Aux Lower Right F
R900, R931: 270; Aux Center J-K Line
R901: 160; Aux Center Right J
R902: 1K; Aux Lower Center K
R903: 14K; Aux Lower Right K
R904: 160K; Aux Lower Right K
R906: 3K; Aux Center Right K
R907: 100K; Aux Lower Right K
R908: 150K; Aux Upper Left K
R909: 18K; Aux Center Right E
R910: 300; Aux Lower Right E
R911: 2k2; Aux Lower Center E
R912: 56K; Aux Right D-J Line
R913: 180K; Aux Left E-K Line
R914, R915: 8k2; Aux Upper Left J
R916: 180k; Aux Lower C-D Line
R917: 3K; Aux Center Left D
R918: 10K; Aux Lower Left D
R919: 82K; Aux Right D-J Line
R920, R921: 20K; Aux Upper Center J
R922: 1k8; Aux Lower Right D
R923: 1k8; Aux Upper Right J
R924: 180k; Aux Center E
R925: 300; Aux Lower Left D
R926: 3K; Aux Center D-E Line
R927: 10K; Aux Lower Center D
R928: 270; Aux Lower Right K
R929: 390; Aux Lower Center J
R930: 1K; Aux Lower J-K Line
R932: 14K; Aux Lower J-K Line
R933: 160K; Aux Lower J-K Line
R934: 270; Aux Lower Center J
R935: 15K; Aux Upper Right K
R936: 10K; Aux Upper Right K
R937: 47K; Aux Center Right E
R938: 240K; Aux Lower Right E
T109: BSX45; TO-92_Inline
T900, T905: S2066; TO-92_Inline
T901, T902, T903, T904: BCY58; TO-92_Inline

Notes on the sheet:
Throttle Enrich
Alternating Lo as Throttle Advances
12V from Main EFI Relay
Ground from Vehicle
Regulated 10V
Enrich Bias Groups II & IV
Enrich Bias Groups I & III
Enrich Pulse
At Idle (0V = idle)
Acceleration Enrichment
Voltage Regulator
12874Ω
