ajayre/djetecu/005/Schematics/Aux Board 2.sch

## KiCad design 005/Schematics/Aux Board 2.sch (2024-06-13)

Schematic: Aux Board 2.sch

Parts:
C100: 100n; Aux Upper B-C Line
C101: 15n; Aux Lower Right C
C103: 15n; Aux Center G-H Line
C121: 470n; Aux Center H
C300: 680n; Aux Upper Left A
C301: 1n0; Aux Left A-F Line
C350: 680n; Aux Lower Left A
C351: 2n2; Aux Center A-F Line
D100: 1N904 .6V; Aux Center C
D101: 1N904 .6V; Aux Upper Center H
D102: 1N904 .6V; Aux Center Right G
D103: 1N904 .6V; Aux Center Left H
D106, D107: 1N904 .6V; Aux Lower Left H
D110: 1N904 .6V; Aux Lower G-H Line
D301: 1N904 .6V; Aux Upper Left F
D302, D352: 1N904 .6V; Aux Center Left B
D303, D306: 1N904 .6V; Aux Lower Left B
D304: .67V; Aux Upper Center G
D305: 1N904 .6V; Aux Center Right B
D308: 1N904 .6V; Aux Center B
D312: 1N904 .6V; Aux Center F
D351: 1N904 .6V; Aux Lower Left A
D353, D356: 1N904 .6V; Aux Upper Left G
D354: 1N904 .6V; Aux Upper Center F
R100: 2K; Aux Upper Right A
R101: 180K; Aux Upper Center C
R102: 180K; Aux Center Left C
R103: 27K; Aux Center C
R104: 680; Aux Lower Right C
R105: 180K; Aux Upper Right H
R106: 560K; Aux Left C-H Line
R107: 36K; Aux Left C-H Line
R108: 1K; Aux Lower Center C
R110: 24K; Aux Upper Center H
R111: 22K; Aux Upper Right H
R113: 560; Aux Center H
R116: 2K; Aux Upper Left H
R117: 47K; Aux Lower Center G
R118: 240K; Aux Lower Center G
R119: 16K; Aux Lower Left G
R120: 1k8; Aux Center G
R127: 510K; Aux Lower Right G
R128: 91K; Aux Bottom H-J Line
R129: 130K; Aux Bottom H-J Line
R132: 5k6; Aux Bottom Right G
R133: 5k6; Aux Bottom G-H Line
R134: 1K; Aux Bottom Left H
R135: 510; Aux Center Right G
R146: 2k4; Aux Lower Left J
R147: 7k5; Aux Lower Left J
R300, R350: 10K; Aux Lower Left F
R301: 20K; Aux Center F
R302: 2K; Aux Center F-G Line
R303: 2k2; Aux Upper A-B Line
R304: 12K; Aux Upper A-B Line
R307: 4k7; Aux Upper Right G
R308: 5k6; Aux Lower Right B
R309: 15K; Aux Right B-G Line
R310, R360: 15K; Aux Center A-B Line
R311: 220K; Aux Center A-B Line
R312: 180K; Aux Center Left F
R313: 1k1; Aux Lower Left C
R315: 3K; Aux Upper Center F
R316: 10K; Aux Lower A-B Line
R317: 120K; Aux Lower A-B Line
R318, R368: 5k6; Aux Upper F-G Line
R319: 28K; Aux Upper F-G Line
R320: 2K; Aux Upper Right G
R323: 20K; Aux Center Right F
R324: 4k7; Aux Lower Right B
R325: 27K; Aux Right B-G Line
R326: 1K; Aux Upper Left F
R327: 6k8; Aux Lower Right B
R329: 130K; Aux Upper Right G
R351: 20K; Aux Lower Right F
R352: 2K; Aux Lower Left G
R353: 2k2; Aux Lower A-B Line
R354: 11K; Aux Lower A-B Line
R361: 180K; Aux Center A-B Line
R362: 180K; Aux Upper Right F
R363: 1K; Aux Lower Left A
R365: 3K; Aux Upper Right F
R366: 180K; Aux Upper F-G Line
R367: 10K; Aux Upper F-G Line
R369: 22K; Aux Upper F-G Line
R373: 20K; Aux Lower Left G
T100, T101, T103: S2672; TO-92_Inline
T102, T300, T303, T350, T353: BCY58; TO-92_Inline
T301, T302, T351, T352: S2066; TO-92_Inline

Notes on the sheet:
Water Temp Bias
Lo = Enable Groups I & III
Lo = Enable Grous II & IV
Base Injector Pulse Groups I & III
Base Injector Pulse
Base Injector Pulse Groups II & IV
Enrich Bias Groups II & IV
Enrich Bias Groups I & III
Groups I & III Modified Injector Pulse
Speed Bias VE Curve
Speed Validated
Speed Sense Pulse
Engine Speed Correction
Groups II & IV Modified Injector Pulse
39303Ω
33826Ω
23478Ω
52529Ω
1859Ω
14043Ω
9231Ω
4638Ω
4003Ω
1833Ω
13846Ω
9474Ω
4464Ω
Pulse Width Multiplier
