ajayre/djetecu/005/Schematics/MPS & Temp Sensors.kicad_sch

## KiCad design 005/Schematics/MPS & Temp Sensors.kicad_sch (2024-06-13)

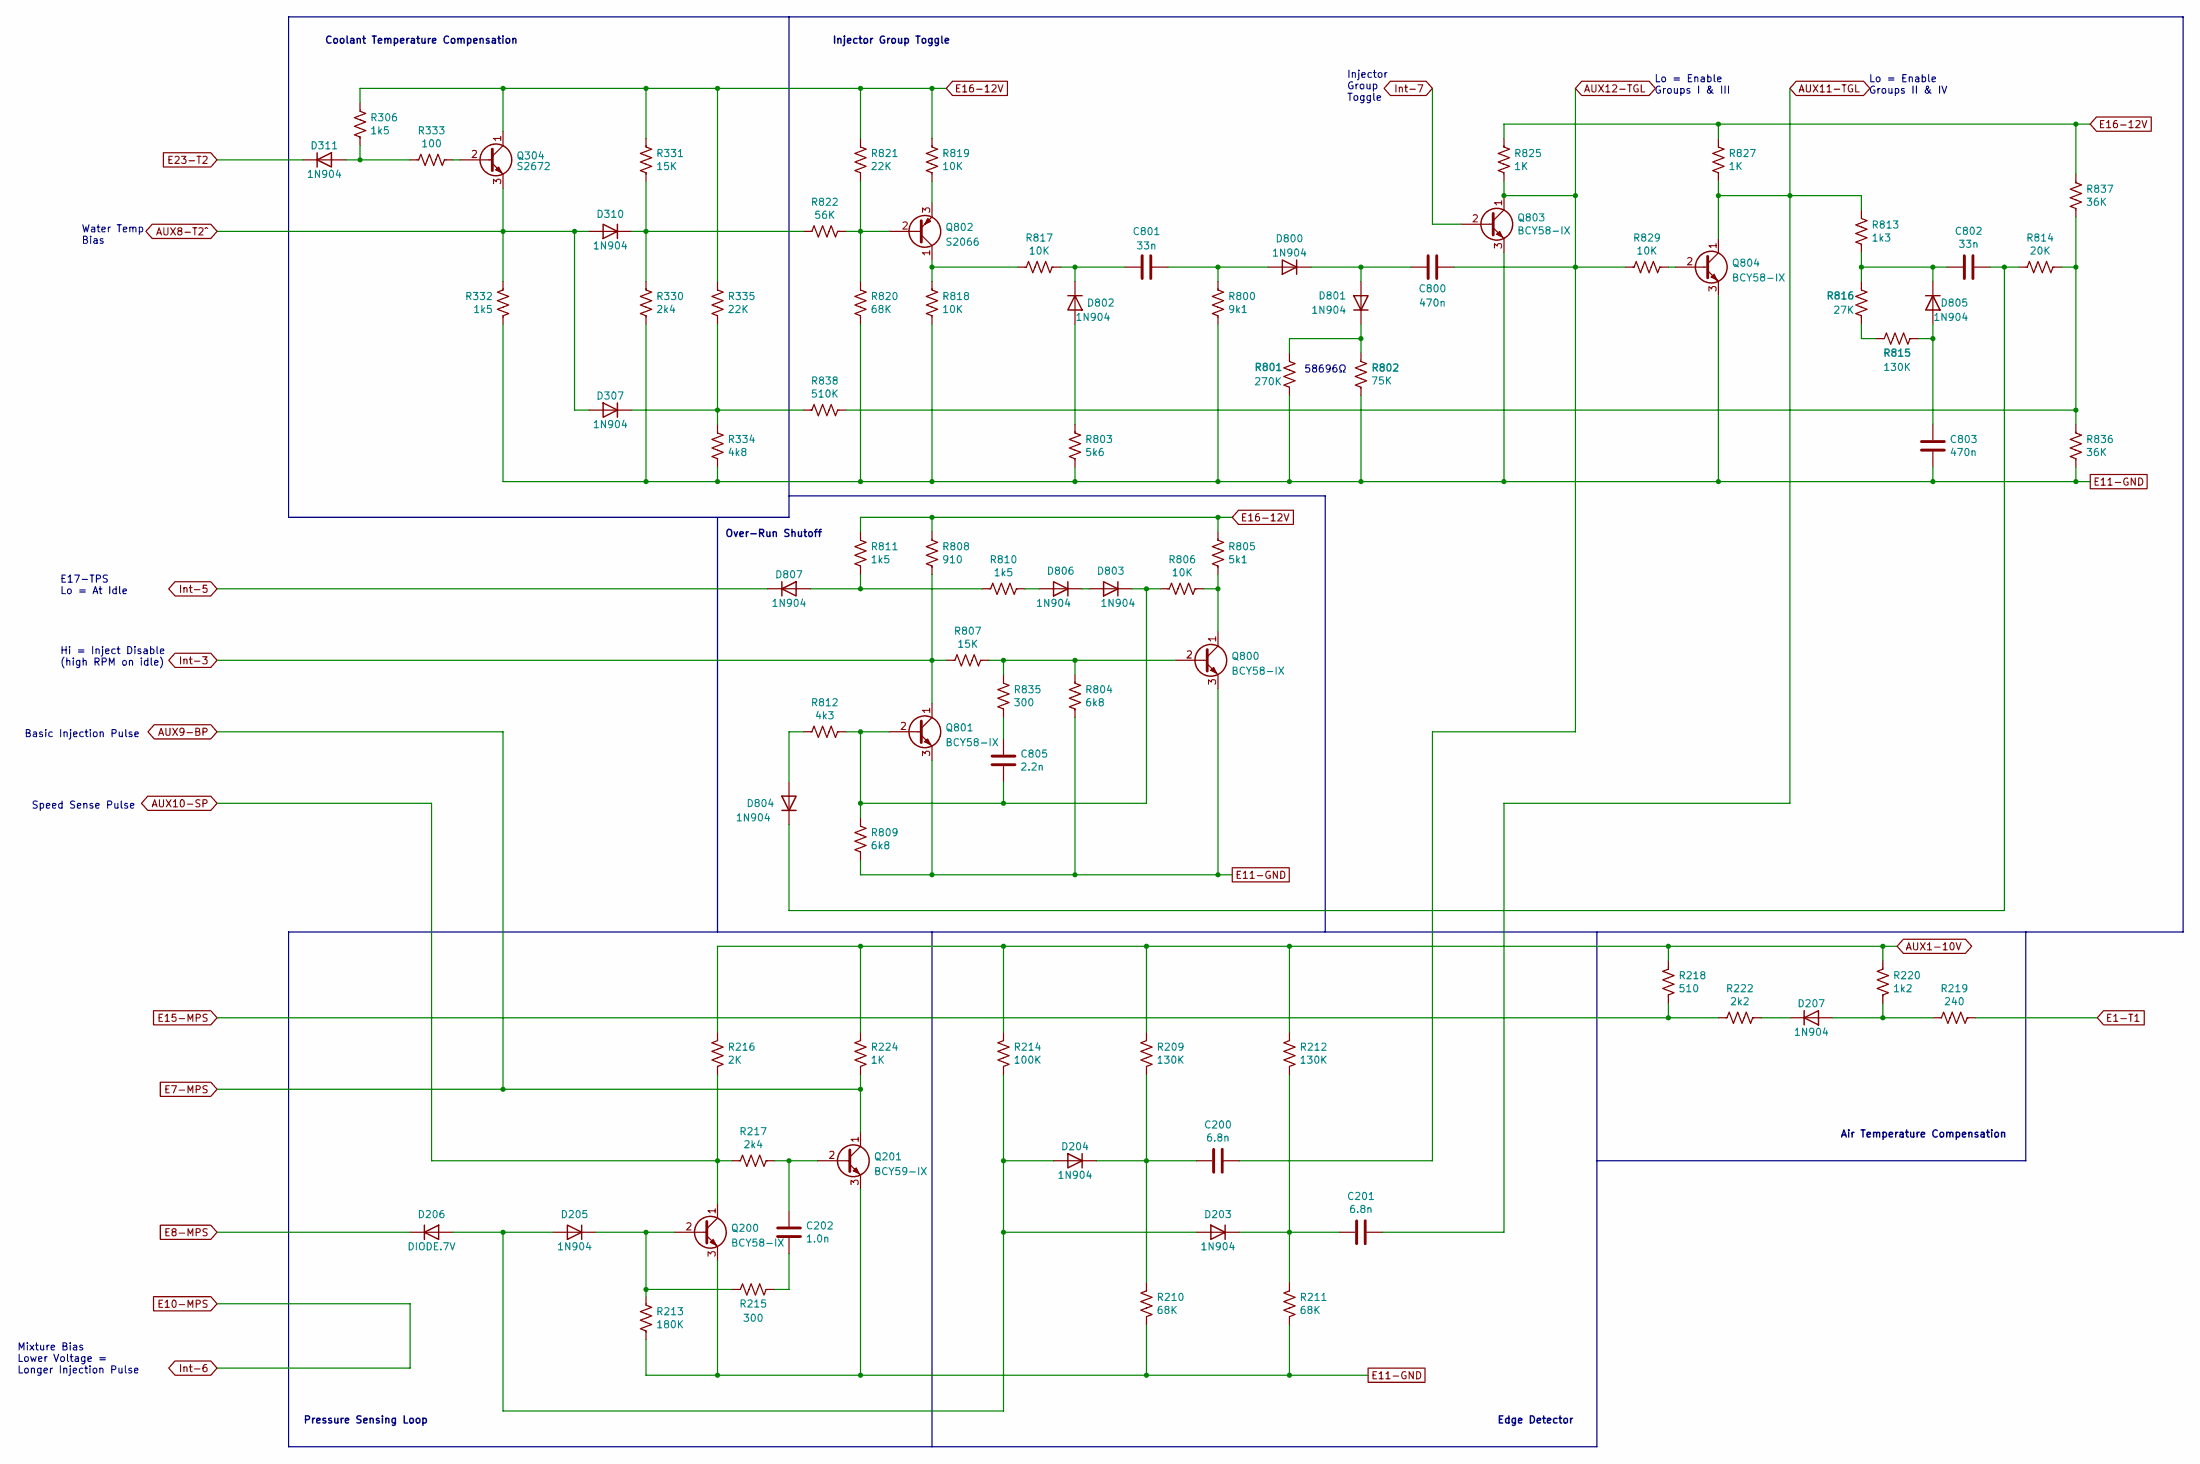
[picture p25: schematic MPS & Temp Sensors.kicad_sch]

Parts:
C200, C201: 6.8n; Lower Right B
C202: 1.0n; Lower Center B
C800: 470n; Left D-J Line
C801: 33n; Lower C-D Line
C802: 33n; Lower B-C Line
C803: 470n; Lower C-D Line
C805: 2.2n; Center Left C
D203, D204: 1N904; Lower Center B
D205: 1N904; Lower Left B
D206: DIODE.7V; Lower A-B Line
D207: 1N904; Center Left A
D307: 1N904; Upper Right H
D310: 1N904; Upper H-J Line
D311: 1N904; Lower Center F
D800: 1N904; Center D-J Line
D801: 1N904; Lower Center D
D802: 1N904; Lower Right C
D803: 1N904; Center Left C
D804: 1N904; Lower Center C
D805: 1N904; Lower Left C
D806: 1N904; Center Right B
D807: 1N904; Upper Right B
Q200: BCY58-IX
Q201: BCY59-IX; TO-92_Inline
Q304: S2672; TO-92_Inline
Q800, Q801, Q803, Q804: BCY58-IX; TO-92_Inline
Q802: S2066; TO-92_Inline
R209, R212: 130K; Center B
R210, R211: 68K; Center B-G Line
R213: 180K; Left B-G Line
R214: 100K; Center Left B
R215: 300; Lower Left B
R216: 2K; Right A-F Line
R217: 2k4; Left B-G Line
R218: 510; Center Left F
R219: 240; Upper Left A
R220: 1k2; Center Left A
R222: 2k2; Lower Left A
R224: 1K; Center Left B
R306: 1k5; Center F-G Line
R330: 2k4; Center Left J
R331: 15K; Upper H-J Line
R332: 1k5; Lower Left G
R333: 100; Lower F-G Line
R334: 4k8; Upper Left J
R335: 22K; Upper Left J
R800: 9k1; Lower Left D
R801: 270K; Lower Right D
R802: 75K; Lower Right D
R803: 5k6; Lower Right C
R804: 6k8; Center Left C
R805: 5k1; Upper Left C
R806: 10K; Upper Left C
R807: 15K; Center Left C
R808: 910; Upper Left C
R809: 6k8; Lower B-C Line
R810, R811: 1k5; Upper Right B
R812: 4k3; Lower B-C Line
R813: 1k3; Lower Left C
R814: 20K; Lower Right C
R815: 130K; Right C-H Line
R816: 27K; Right C-H Line
R817: 10K; Lower C-D Line
R818: 10K; Lower Left D
R819: 10K; Lower Right D
R820: 68K; Lower Left E
R821: 22K; Lower Right D
R822: 56K; Upper Center J
R825: 1K; Lower Left G
R827: 1K; Lower F-G Line
R829: 10K; Upper Right J
R835: 300; Center Right C
R836, R837: 36K; Center Left J
R838: 510K; Upper Left J

Connections:
AUX1-10V: R209.1, R212.1, R214.1, R216.1, R218.1, R220.1, R224.1
AUX8-T2^: D307.2 (A), D310.2 (A), Q304.3 (E), R332.1
AUX9-BP: Q201.1 (C), R224.2
AUX10-SP: Q200.1 (C), R216.2, R217.1
AUX11-TGL: C201.2, Q804.1 (C), R813.2, R827.2
AUX12-TGL: C200.2, C800.2, Q803.1 (C), R825.2, R829.2
E1-T1: R219.2
E8-MPS: D206.1 (K)
E11-GND: C803.1, Q200.3 (E), Q201.3 (E), Q800.3 (E), Q801.3 (E), Q803.3 (E), Q804.3 (E), R210.2, R211.2, R213.2, R330.2, R332.2, R334.1, R800.2, R801.2, R802.2, R803.2, R804.2, R809.2, R818.2, R820.2, R836.1
E15-MPS: R218.2, R222.1
E16-12V: Q304.1 (C), R306.1, R331.1, R335.2, R805.1, R808.1, R811.1, R819.1, R821.1, R825.1, R827.1, R837.2
E23-T2: D311.1 (K)
Int-3: Q801.1 (C), R807.1, R808.2
Int-5: D807.1 (K)
Int-7: Q803.2 (B)
unnamed: C200.1, D204.1 (K), R209.2, R210.1
unnamed: C201.1, D203.1 (K), R211.1, R212.2
unnamed: C202.1, Q201.2 (B), R217.2
unnamed: C202.2, R215.1
unnamed: C800.1, D800.1 (K), D801.2 (A)
unnamed: C801.1, D802.1 (K), R817.1
unnamed: C801.2, D800.2 (A), R800.1
unnamed: C802.1, D804.1 (K), R814.1
unnamed: C802.2, D805.1 (K), R813.1, R816.2
unnamed: C803.2, D805.2 (A), R815.2
unnamed: C805.1, D803.1 (K), Q801.2 (B), R806.2, R809.1, R812.2
unnamed: C805.2, R835.2
unnamed: D203.2 (A), D204.2 (A), D205.2 (A), D206.2 (A), R214.2
unnamed: D205.1 (K), Q200.2 (B), R213.1, R215.2
unnamed: D207.1 (K), R222.2
unnamed: D207.2 (A), R219.1, R220.2
unnamed: D307.1 (K), R334.2, R335.1, R838.1
unnamed: D310.1 (K), R330.1, R331.2, R822.2
unnamed: D311.2 (A), R306.2, R333.2
unnamed: D801.1 (K), R801.1, R802.1
unnamed: D802.2 (A), R803.1
unnamed: D803.2 (A), D806.1 (K)
unnamed: D804.2 (A), R812.1
unnamed: D806.2 (A), R810.2
unnamed: D807.2 (A), R810.1, R811.2
unnamed: Q304.2 (B), R333.1
unnamed: Q800.1 (C), R805.2, R806.1
unnamed: Q800.2 (B), R804.1, R807.2, R835.1
unnamed: Q802.1 (C), R817.2, R818.1
unnamed: Q802.2 (B), R820.1, R821.2, R822.1
unnamed: Q802.3 (E), R819.2
unnamed: Q804.2 (B), R829.1
unnamed: R814.2, R836.2, R837.1, R838.2
unnamed: R815.1, R816.1

Notes on the sheet:
Hi = Inject Disable (high RPM on idle)
Coolant Temperature Compensation
Basic Injection Pulse
58696Ω
Speed Sense Pulse
Air Temperature Compensation
Edge Detector
Pressure Sensing Loop
Lo = Enable Groups I & III
Over-Run Shutoff
Lo = Enable Groups II & IV
Mixture Bias Lower Voltage = Longer Injection Pulse
Water Temp Bias
E17-TPS Lo = At Idle
Injector Group Toggle
Injector Group Toggle
