ajayre/djetecu/005/Schematics/Simulation.kicad_sch

## KiCad design 005/Schematics/Simulation.kicad_sch (2024-06-13)

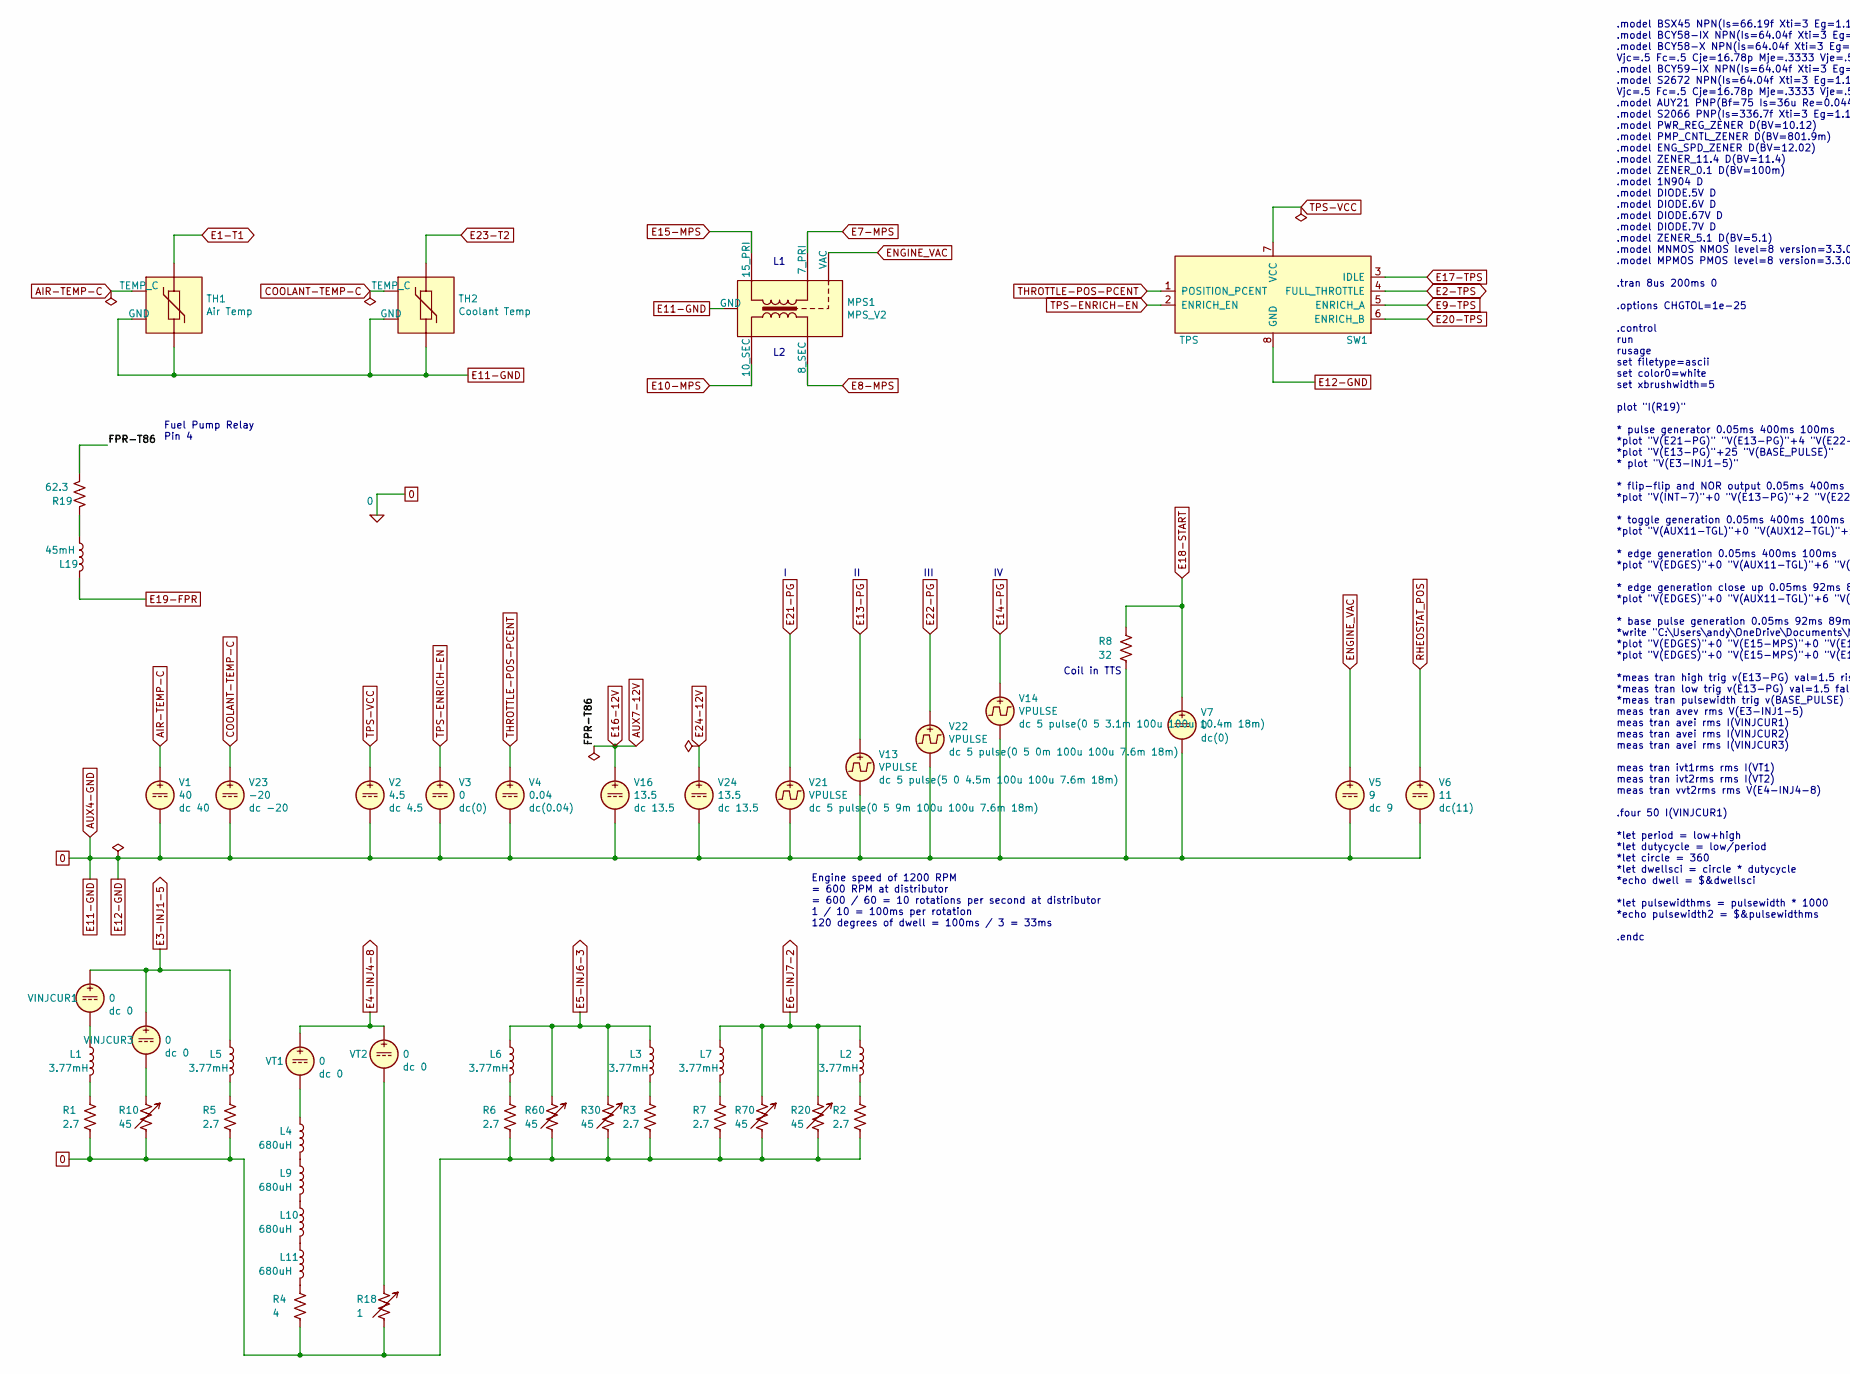
[picture p26: schematic Simulation.kicad_sch, part in row 1, column 1]

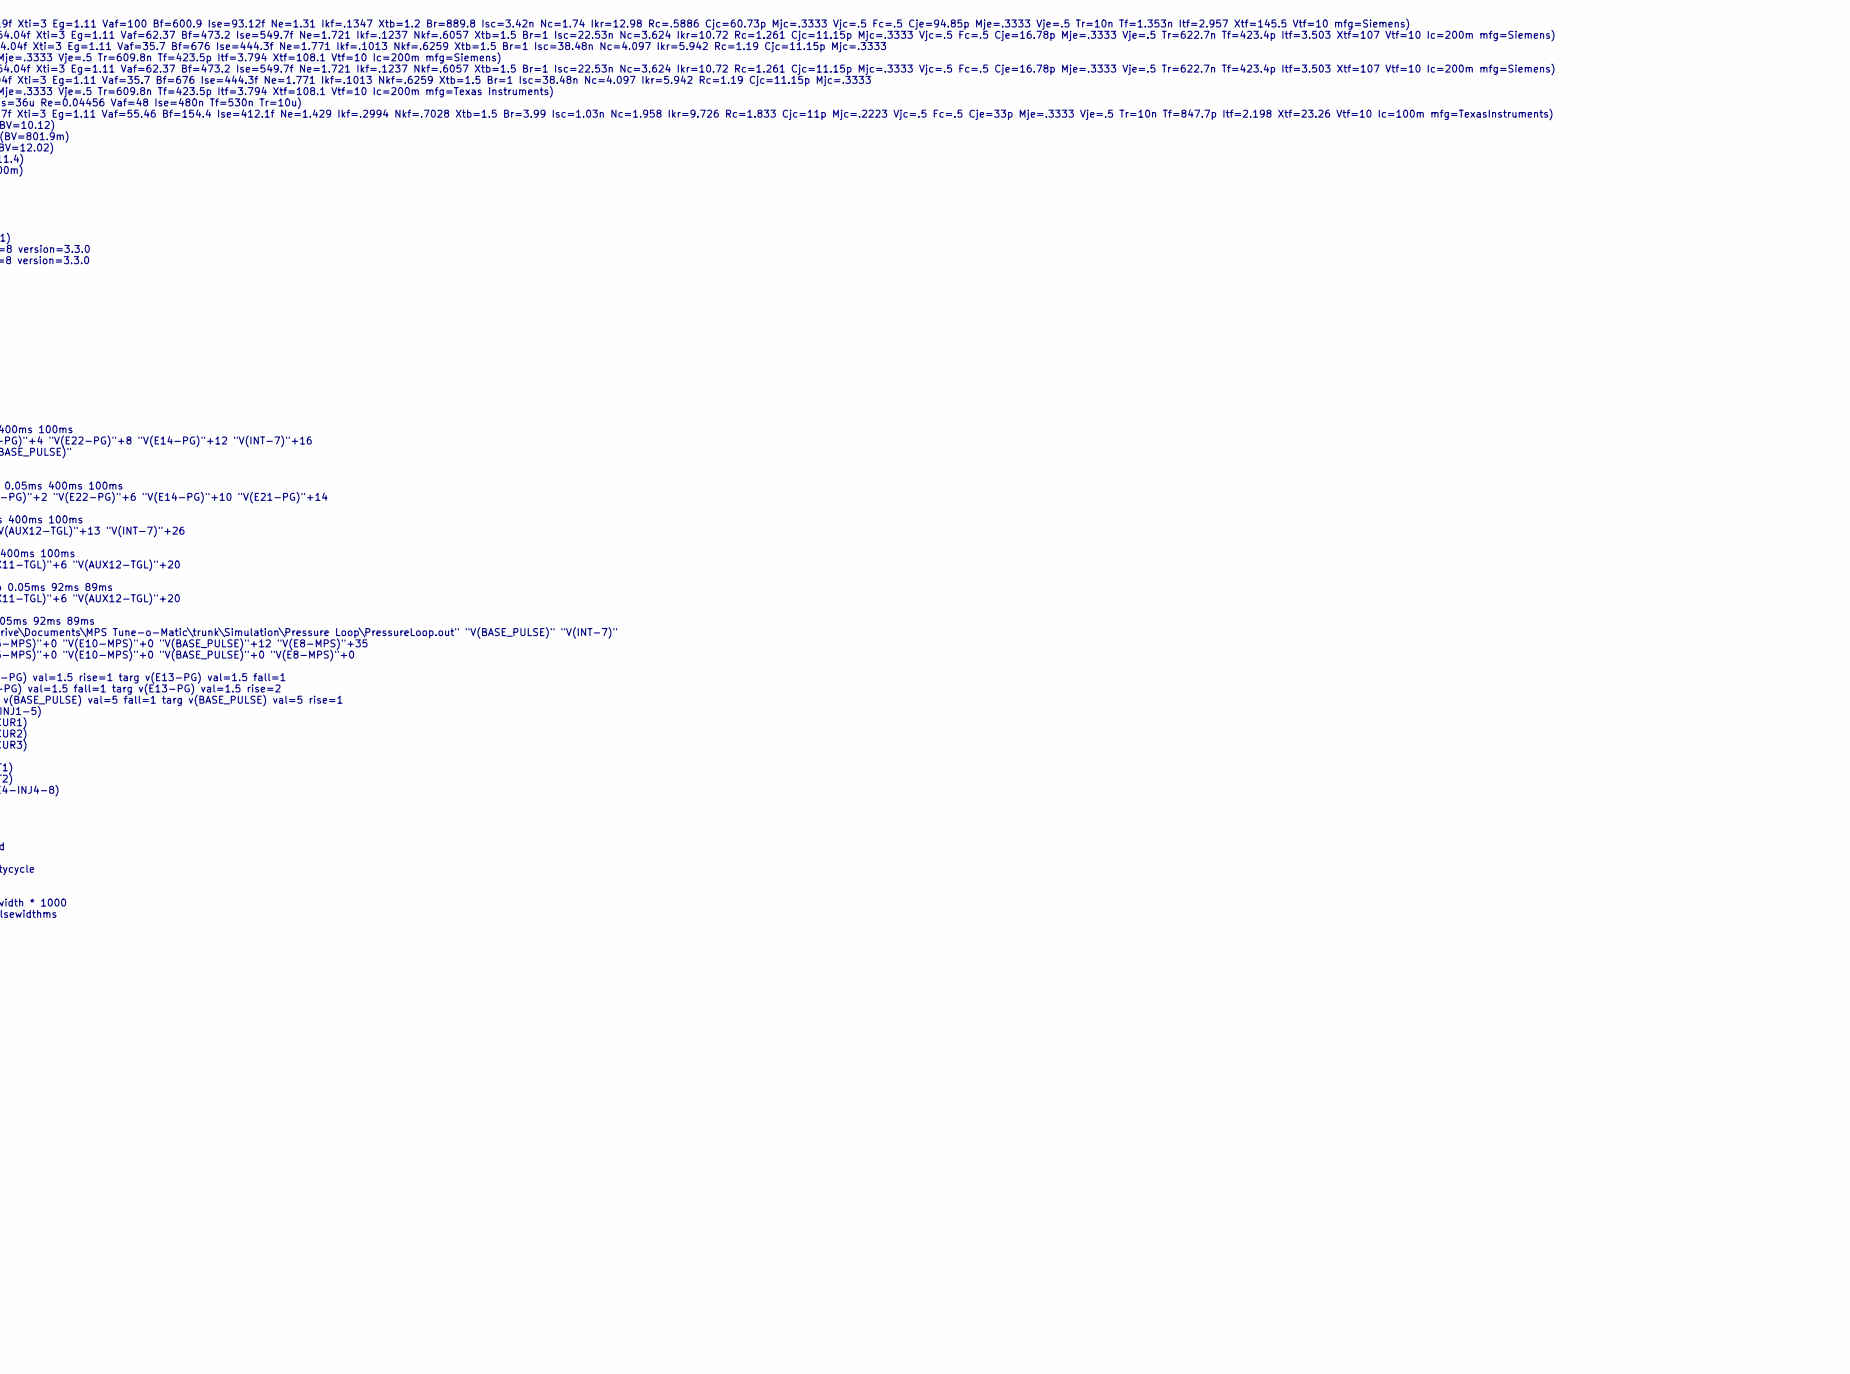
[picture p27: schematic Simulation.kicad_sch, part in row 1, column 2]

Parts:
L1, L2, L3, L5, L6, L7: 3.77mH
L4, L9, L10, L11: 680uH
L19: 45mH
MPS1: MPS_V2
R1, R2, R3, R5, R6, R7: 2.7
R4: 4
R8: 32
R10, R20, R30, R60, R70: 45
R18: 1
R19: 62.3
SW1: TPS
TH1: Air Temp
TH2: Coolant Temp
V1: 40
V2: 4.5
V3, V7: 0
V4: 0.04
V5: 9
V6: 11
V13, V14, V21, V22: VPULSE
V16, V24: 13.5
V23: -20
VINJCUR1, VINJCUR3: 0
VT1, VT2: 0

Connections:
0: MPS1.6 (GND), R1.2, R2.2, R3.2, R4.2, R5.2, R6.2, R7.2, R8.2, R10.2, R18.2, R20.2, R30.2, R60.2, R70.2, SW1.8 (GND), TH1.2, TH1.4 (GND), TH2.2, TH2.4 (GND), V1.2, V2.2, V3.2, V4.2, V5.2, V6.2, V7.2, V13.2, V14.2, V16.2, V21.2, V22.2, V23.2, V24.2
AIR-TEMP-C: TH1.3 (TEMP_C), V1.1
AUX7-12V: R19.2, V16.1
COOLANT-TEMP-C: TH2.3 (TEMP_C), V23.1
E1-T1: TH1.1
E2-TPS: SW1.4 (FULL_THROTTLE)
E3-INJ1-5: L5.1, VINJCUR1.1, VINJCUR3.1
E4-INJ4-8: VT1.1, VT2.1
E5-INJ6-3: L3.1, L6.1, R30.1, R60.1
E6-INJ7-2: L2.1, L7.1, R20.1, R70.1
E7-MPS: MPS1.1 (7_PRI)
E8-MPS: MPS1.3 (8_SEC)
E9-TPS: SW1.5 (ENRICH_A)
E10-MPS: MPS1.4 (10_SEC)
E13-PG: V13.1
E14-PG: V14.1
E15-MPS: MPS1.2 (15_PRI)
E17-TPS: SW1.3 (IDLE)
E18-START: R8.1, V7.1
E19-FPR: L19.1
E20-TPS: SW1.6 (ENRICH_B)
E21-PG: V21.1
E22-PG: V22.1
E23-T2: TH2.1
E24-12V: V24.1
ENGINE_VAC: MPS1.5 (VAC), V5.1
unnamed: L1.1, VINJCUR1.2
unnamed: L1.2, R1.1
unnamed: L2.2, R2.1
unnamed: L3.2, R3.1
unnamed: L4.1, VT1.2
unnamed: L4.2, L9.1
unnamed: L5.2, R5.1
unnamed: L6.2, R6.1
unnamed: L7.2, R7.1
unnamed: L9.2, L10.1
unnamed: L10.2, L11.1
unnamed: L11.2, R4.1
unnamed: L19.2, R19.1
unnamed: R10.1, VINJCUR3.2
unnamed: R18.1, VT2.2
RHEOSTAT_POS: V6.1
THROTTLE-POS-PCENT: SW1.1 (POSITION_PCENT), V4.1
TPS-ENRICH-EN: SW1.2 (ENRICH_EN), V3.1
TPS-VCC: SW1.7 (VCC), V2.1

Notes on the sheet:
.model BSX45 NPN(Is=66.19f Xti=3 Eg=1.11 Vaf=100 Bf=600.9 Ise=93.12f Ne=1.31 Ikf=.1347 Xtb=1.2 Br=889.8 Isc=3.42n Nc=1.74 Ikr=12.98 Rc=.5886 Cjc=60.73p Mjc=.3333 Vjc=.5 Fc=.5 Cje=94.85p Mje=.3333 Vje=.5 Tr=10n Tf=1.353n Itf=2.957 Xtf=145.5 Vtf=10 mfg=Siemens) .model BCY58-IX NPN(Is=64.04f Xti=3 Eg=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
III
Fuel Pump Relay Pin 4
Coil in TTS
Engine speed of 1200 RPM = 600 RPM at distributor = 600 / 60 = 10 rotations per second at distributor 1 / 10 = 100ms per rotation 120 degrees of dwell = 100ms / 3 = 33ms
