ajayre/djetecu/005/Schematics/TPS & Fuel Pump.kicad_sch

## KiCad design 005/Schematics/TPS & Fuel Pump.kicad_sch (2024-06-13)

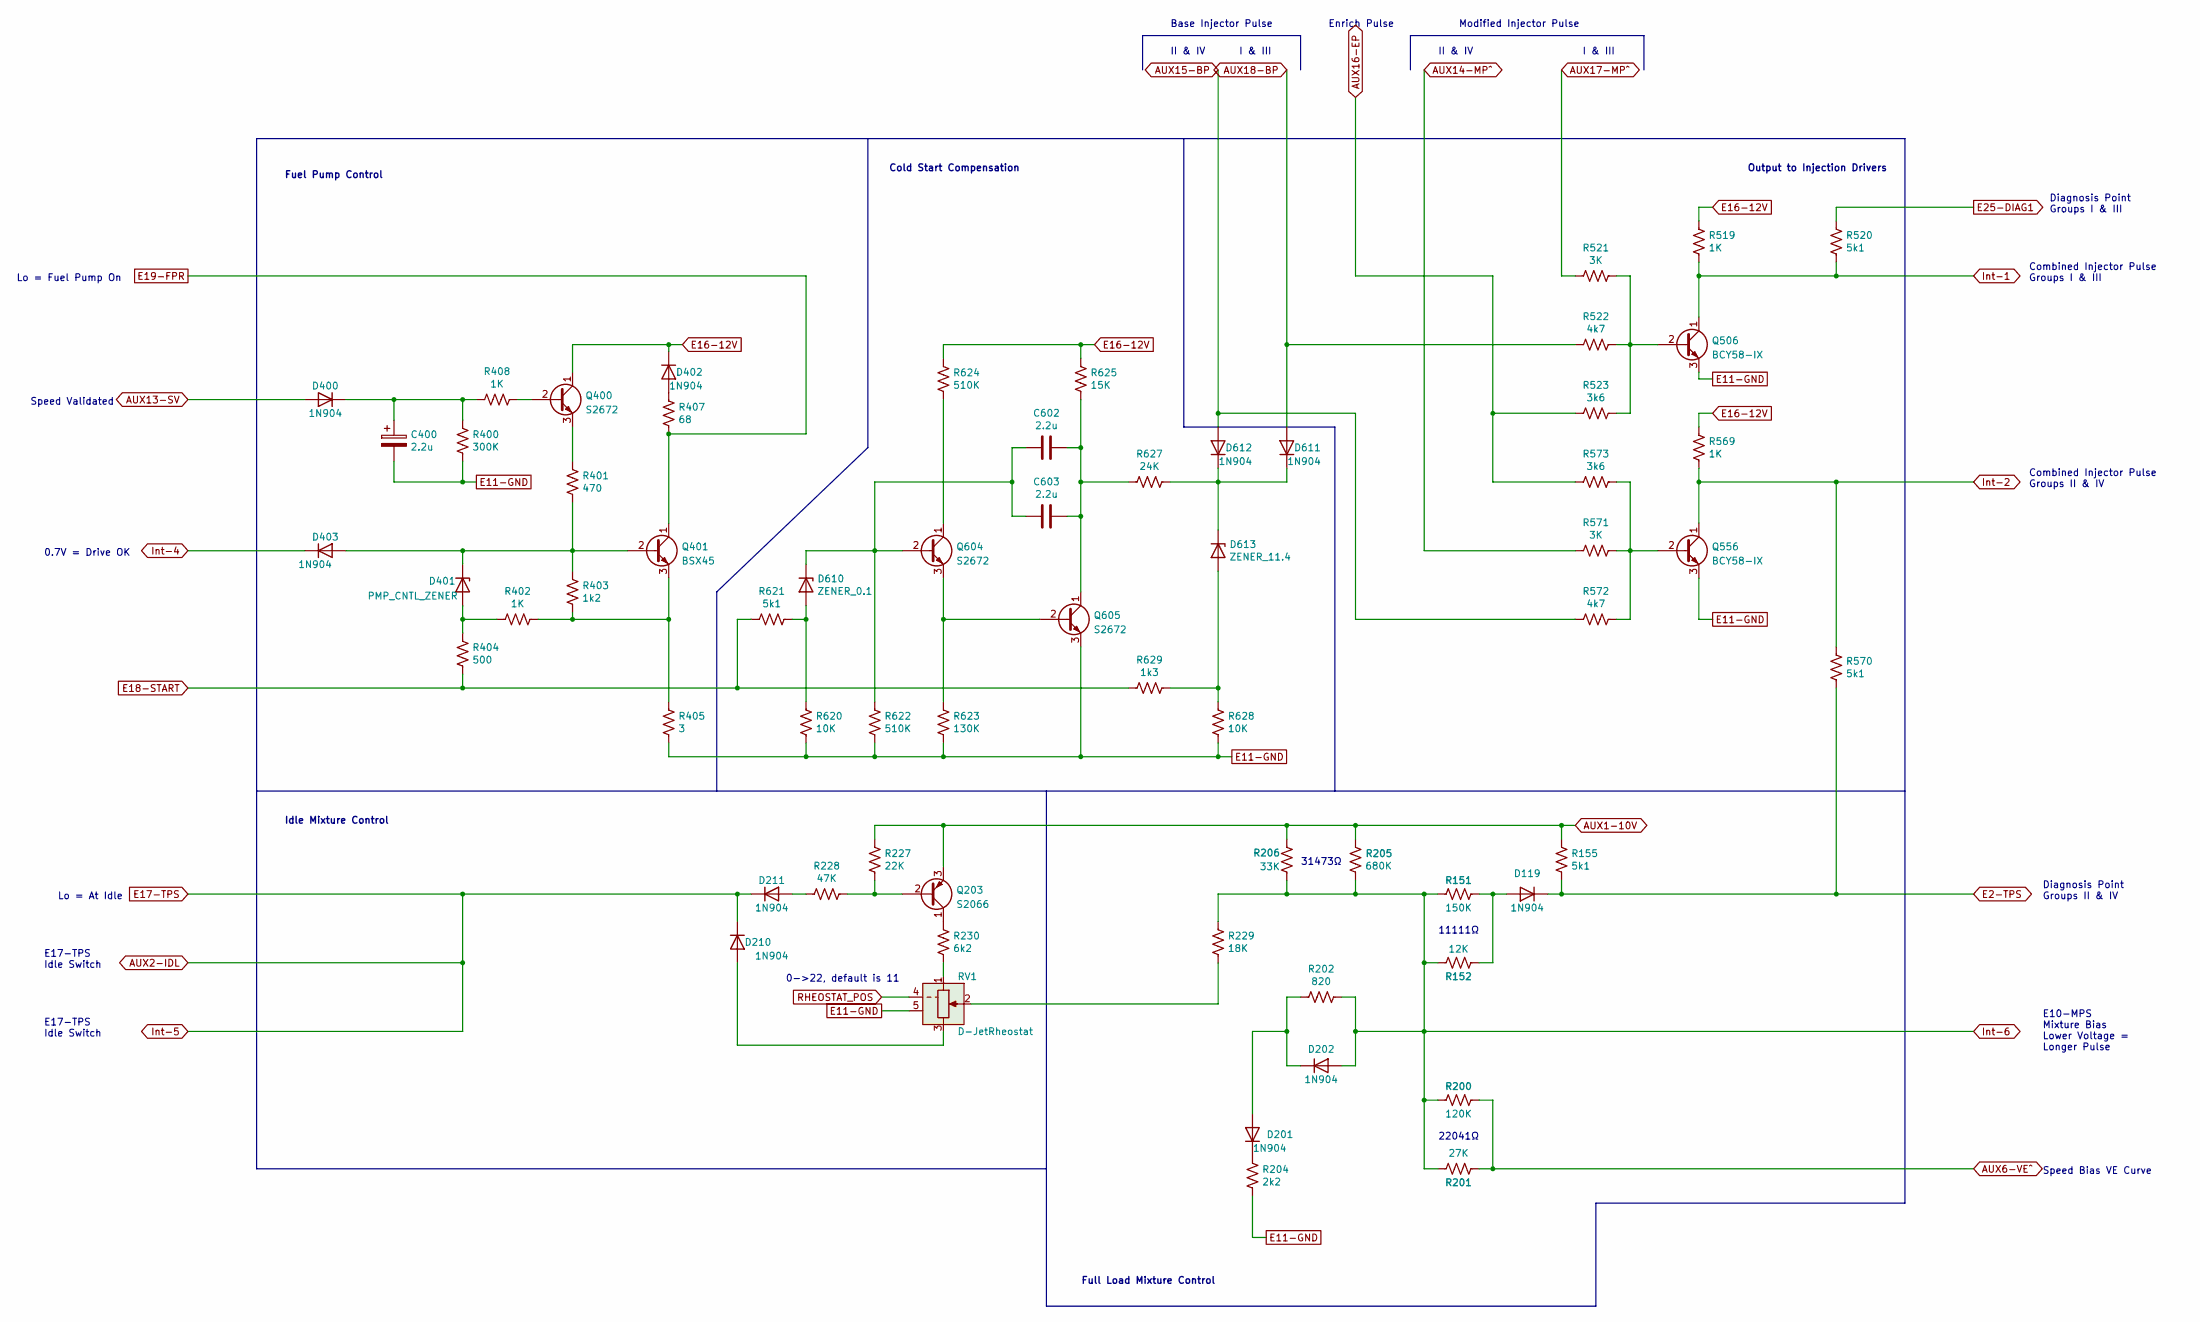
[picture p28: schematic TPS & Fuel Pump.kicad_sch]

Parts:
C400: 2.2u; Lower Left H
C602, C603: 2.2u; Center H
D119: 1N904; Upper Center A
D201, D202: 1N904; Lower Right A
D210, D211: 1N904; Upper Left B
D400, D611: 1N904; Lower Left H
D401: PMP_CNTL_ZENER; Lower Left J
D402, D403: 1N904; Lower Center H
D610: ZENER_0.1; Upper Right H
D612: 1N904; Lower G-H Line
D613: ZENER_11.4; Lower Right H
Q203: S2066; TO-92_Inline
Q400, Q604, Q605: S2672; TO-92_Inline
Q401: BSX45; TO-92_Inline
Q506, Q556: BCY58-IX; TO-92_Inline
R151: 150K; Center A
R152: 12K; Center A
R155: 5k1; Upper Center A
R200: 120K; Upper Center F
R201: 27K; Upper Right F
R202: 820; Lower Center A
R204: 2k2; Lower Center A
R205: 680K; Left A-F Line
R206: 33K; Center A_F Line
R227: 22K; Center Left B
R228: 47K; Center Left B
R229: 18K; Center Right A
R230: 6k2; Upper Left B (under rheostat wires)
R400: 300K; Lower Left H
R401: 470; Lower Right H
R402: 1K; Lower Left H
R403: 1k2; Lower H-J Line
R404: 500; Lower Center J
R405: 3; Lower Right H
R407: 68; Lower Right H
R408: 1K; Lower Left J
R519: 1K; Center Right J
R520: 5k1; Lower Right J
R521: 3K; Lower Right G
R522: 4k7; Lower Left H
R523: 3k6; Lower G-H Line
R569: 1K; Upper Left D
R570: 5k1; Upper Left A
R571: 3K; Lower Center G
R572: 4k7; Lower Right G
R573: 3k6; Lower Right G
R620, R628: 10K; Center Left J
R621: 5k1; Center Left J
R622: 510K; Center Right H
R623: 130K; Center Right H
R624: 510K; Upper Right H
R625: 15K; Lower Center H
R627: 24K; Lower Center H
R629: 1k3; Lower Left J
RV1: D-JetRheostat

Connections:
AUX1-10V: Q203.3 (E), R155.1, R205.1, R206.1, R227.2
AUX2-IDL: D210.1 (K), D211.1 (K)
AUX6-VE^: R200.1, R201.1
AUX13-SV: D400.2 (A)
AUX14-MP^: R571.2
AUX15-BP: D612.2 (A), R572.2
AUX16-EP: R523.2, R573.2
AUX17-MP^: R521.2
AUX18-BP: D611.2 (A), R522.2
E2-TPS: D119.1 (K), R155.2, R570.2
E11-GND: C400.2, Q506.3 (E), Q556.3 (E), Q605.3 (E), R204.1, R400.2, R405.2, R620.2, R622.1, R623.1, R628.2, RV1.5 (GND)
E16-12V: D402.1 (K), Q400.1 (C), R519.2, R569.2, R624.2, R625.2
E18-START: R404.1, R621.2, R629.2
E19-FPR: Q401.1 (C), R407.2
E25-DIAG1: R520.2
Int-1: Q506.1 (C), R519.1, R520.1
Int-2: Q556.1 (C), R569.1, R570.1
Int-4: D403.1 (K)
Int-6: D202.2 (A), R151.2, R152.2, R200.2, R201.2, R202.1, R205.2, R206.2, R229.2
unnamed: C400.1, D400.1 (K), R400.1, R408.2
unnamed: C602.1, C603.1, Q605.1 (C), R625.1, R627.2
unnamed: C602.2, C603.2, D610.1 (K), Q604.2 (B), R622.2
unnamed: D119.2 (A), R151.1, R152.1
unnamed: D201.1 (K), R204.2
unnamed: D201.2 (A), D202.1 (K), R202.2
unnamed: D210.2 (A), RV1.3
unnamed: D211.2 (A), R228.2
unnamed: D401.1 (K), D403.2 (A), Q401.2 (B), R401.2, R403.2
unnamed: D401.2 (A), R402.2, R404.2
unnamed: D402.2 (A), R407.1
unnamed: D610.2 (A), R620.1, R621.1
unnamed: D611.1 (K), D612.1 (K), D613.1 (K), R627.1
unnamed: D613.2 (A), R628.1, R629.1
unnamed: Q203.1 (C), R230.2
unnamed: Q203.2 (B), R227.1, R228.1
unnamed: Q400.2 (B), R408.1
unnamed: Q400.3 (E), R401.1
unnamed: Q401.3 (E), R402.1, R403.1, R405.1
unnamed: Q506.2 (B), R521.1, R522.1, R523.1
unnamed: Q556.2 (B), R571.1, R572.1, R573.1
unnamed: Q604.1 (C), R624.1
unnamed: Q604.3 (E), Q605.2 (B), R623.2
unnamed: R229.1, RV1.2
unnamed: R230.1, RV1.1
RHEOSTAT_POS: RV1.4 (KNOB_POS)

Notes on the sheet:
Diagnosis Point Groups II & IV
Lo = At Idle
Combined Injector Pulse Groups I & III
II & IV
11111Ω
Modified Injector Pulse
Diagnosis Point Groups I & III
0.7V = Drive OK
Idle Mixture Control
Base Injector Pulse
E17-TPS Idle Switch
Speed Validated
Lo = Fuel Pump On
0->22, default is 11
Enrich Pulse
Output to Injection Drivers
Fuel Pump Control
31473Ω
I & III
Full Load Mixture Control
Combined Injector Pulse Groups II & IV
E10-MPS Mixture Bias Lower Voltage = Longer Pulse
Cold Start Compensation
22041Ω
Speed Bias VE Curve
