ajayre/djetecu/(commit log)

2024-06-13 Added ECU 005 schematics and photos. Created in collaboration with CaptainSLC (Benzworld Forum) and Brad Cushman.
    [Aux Board 1.sch, Aux Board 2.sch, Bosch ECU 0 280 002 005 Components.xlsx, Bosch ECU 0 280 002 005.sch, MPS & Temp Sensors.sch, TPS & Fuel Pump.sch]
2024-06-13 Updated to current simulation version of the project.
    [Bosch ECU 0 280 002 005.kicad_sch, MPS & Temp Sensors.kicad_sch, Simulation.kicad_sch, TPS & Fuel Pump.kicad_sch]
